alanmimms/WSPR-ease/hw/WSPR-ease.kicad_pcb

## KiCad design hw/WSPR-ease.kicad_pcb (2026-07-18)

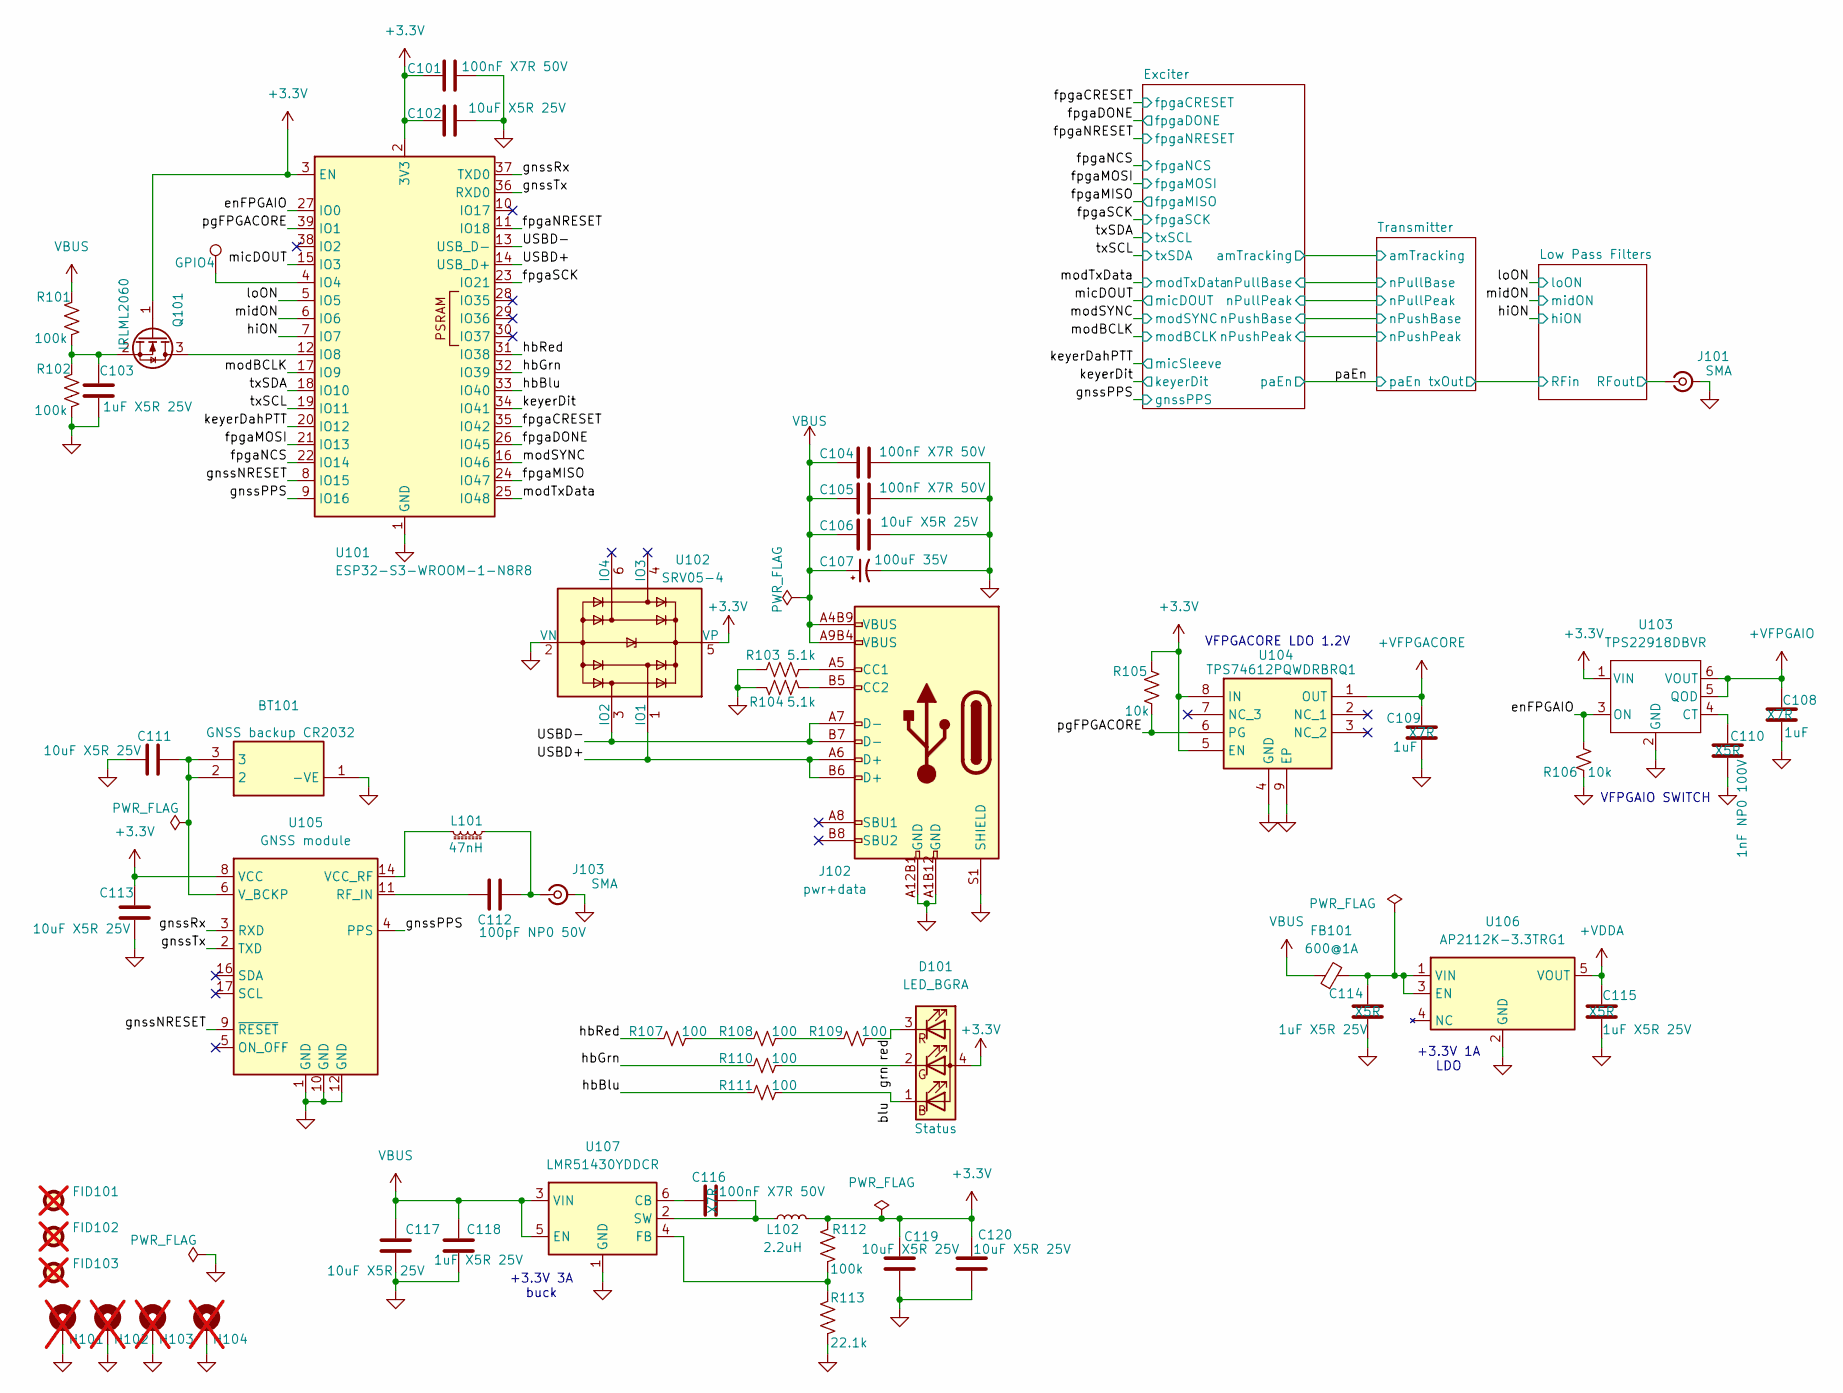
[picture p1: schematic WSPR-ease.kicad_sch]

Parts:
BT101: CR3032 holder; S8401-46; Mouser Part Number 855-S8401-46; LCSC C5904513
C101, C104, C105, C116: 100nF X7R 50V; C_0402_1005Metric; MPN KAM05FR71H104KH
C102, C106, C111, C113: 10uF X5R 25V; C_0603_1608Metric; MPN CM105X5R106M25AT; LCSC C479655
C103: 1uF X5R 25V; C_0402_1005Metric; MPN 04023D105MAT2A; LCSC C7393852
C107: 100uF 35V; C_Elec_6.3x7.7; MPN HHXJ350ARA101MF80G; LCSC C46528074
C108, C109: 1uF; C_0402_1005Metric; MPN GRM155Z71A105KE1D; LCSC_PN C301928
C110: 1nF NP0 100V; C_0603_1608Metric; MPN KGM15ACG2A102FT; LCSC_PN C301928
C112: 100pF NP0 50V; C_0402_1005Metric
C114, C115, C118: 1uF X5R 25V; C_0402_1005Metric; MPN 04023D105MAT2A; Mouser_PN 581-04023D105MAT2A
C117: 10uF X5R 25V; C_0603_1608Metric; MPN CM105X5R106M25AT; Mouser_PN 346-CM105X5R106M25AT
C119, C120: 10uF X5R 25V; C_0603_1608Metric; Manufacturer_Part_Number 81-GXT155R71E223KE1D; Mouser Part Number 963-MLAST168BB5106MT
D101: LED_BGRA; UHD111AFKAC3K23E1L3VG5ZB3Z3; MPN UHD111A-FKA-C3K23E1L3VG5ZB3Z3; Mouser_PN 941-UHD1AA3K3E3V53Z3
FB101: 600@1A; L_0603_1608Metric; MPN ILHB0603ER601VHC41; MouserPN 71-ILHB0603E601VHC41
FID101, FID102, FID103: Fiducial; Fiducial_1mm_Mask2mm; LCSC DNP; not fitted
H101, H102, H103, H104: MountingHole_Pad; MountingHole_3.2mm_M3_ISO7380_Pad; LCSC DNP; not fitted
J101, J103: SMA; SMA_Amphenol_901-143_Horizontal; MPN SMA-J-P-H-RA-TH1; LCSC C496551
J102: pwr+data; UJ20-C-H-G-SMT-P16-TR; MPN UJ20-C-H-G-SMT-P16-TR; Mouser_PN 179-UJ20CHGSMTP16TR
L101: 47nH; L_0603_1608Metric; MPN AIMC-0603-47NJ-T; LCSC C98076
L102: 2.2uH; L_1008_2520Metric; MPN APH252010T2R2M; LCSC C5349606
Q101: IRLML2060; SOT-23; MPN IRLML2060TRPBF; Mouser_PN 942-IRLML2060TRPBF
R101, R102: 100k; R_0402_1005Metric; MPN AC0402FR-0747RL; LCSC C2479306
R103, R104: 5.1k; R_0402_1005Metric; MPN MCS04020C5101FE000; Mouser_PN 594-MCS04020C5101FE0
R105: 10k; R_0402_1005Metric; MPN CRT0402-FZ-1003GLF; LCSC_PN C728576
R106: 10k; R_0402_1005Metric; MPN CRT0402-FZ-1003GLF; Mouser_PN 652-CRT0402FZ1003GLF
R107, R108, R109, R110, R111: 100; R_0402_1005Metric; MPN RT0402FRD0722K1L; Mouser_PN 603-RT0402FRD0722K1L
R112: 100k; R_0402_1005Metric; MPN AC0402FR-0747RL; Mouser_PN 603-AC0402FR-0747RL
R113: 22.1k; R_0402_1005Metric; MPN RT0402FRD0722K1L; Mouser_PN 603-RT0402FRD0722K1L
TP101: GPIO4; TestPoint_Pad_1.5x1.5mm
U101: ESP32-S3-WROOM-1-N8R8; ESP32-S3-WROOM-1; Mouser Part Number ESP32-S3-WROOM-1-N8R8; LCSC C2913201
U102: SRV05-4; SOT-23-6; MPN SRV05-4.TCT; LCSC C2836319
U103: TPS22918DBVR; DBV6_TEX; MPN TPS22918DBVR; LCSC_PN C131941
U104: TPS74612PQWDRBRQ1; SON65P300X300X100-9N-D; MPN TPS74612PQWDRBRQ1; LCSC_PN C2868254
U105: GNSS module; ublox_MAX; MPN TESEO-LIV3R; LCSC C5117921
U106: AP2112K-3.3TRG1; SOT95P285X140-5N; Mouser Part Number 621-AP2112K-3.3TRG1
U107: LMR51430YDDCR; SOT-23-6; MPN LMR51430YDDCR; Mouser_PN 595-LMR51430YDDCR

Connections:
+3.3V: C101.1, C102.1, C113.1, C119.1, C120.1, D101.4 (A), L102.2, Q101.1 (G), R105.2, R112.2, U101.2 (3V3), U101.3 (EN), U102.5 (VP), U103.1 (VIN), U104.5 (EN), U104.8 (IN), U105.8 (VCC); also elsewhere on the board
+VDDA: C115.1, U106.5 (VOUT); also elsewhere on the board
+VFPGACORE: C109.1, U104.1 (OUT); also elsewhere on the board
+VFPGAIO: C108.1, U103.5 (QOD), U103.6 (VOUT); also elsewhere on the board
/Low Pass Filters/RFout: J101.1 (In); also elsewhere on the board
/USBD+: J102.A6 (D+), J102.B6 (D+), U101.14 (USB_D+), U102.1 (IO1)
/USBD-: J102.A7 (D-), J102.B7 (D-), U101.13 (USB_D-), U102.3 (IO2)
/blu: D101.1 (BK), R111.2
/enFPGAIO: R106.2, U101.27 (IO0), U103.3 (ON)
/fpgaCRESET: U101.35 (IO42); also elsewhere on the board
/fpgaDONE: U101.26 (IO45); also elsewhere on the board
/fpgaMISO: U101.24 (IO47); also elsewhere on the board
/fpgaMOSI: U101.21 (IO13); also elsewhere on the board
/fpgaNCS: U101.22 (IO14); also elsewhere on the board
/fpgaNRESET: U101.11 (IO18); also elsewhere on the board
/fpgaSCK: U101.23 (IO21); also elsewhere on the board
/gnssNRESET: U101.8 (IO15), U105.9 (~RESET)
/gnssPPS: U101.9 (IO16), U105.4 (PPS); also elsewhere on the board
/gnssRx: U101.37 (TXD0), U105.3 (RXD)
/gnssTx: U101.36 (RXD0), U105.2 (TXD)
/grn: D101.2 (GK), R110.2
/hbBlu: R111.1, U101.33 (IO40)
/hbGrn: R110.1, U101.32 (IO39)
/hbRed: R107.1, U101.31 (IO38)
/hiON: U101.7 (IO7); also elsewhere on the board
/keyerDahPTT: U101.20 (IO12); also elsewhere on the board
/keyerDit: U101.34 (IO41); also elsewhere on the board
/loON: U101.5 (IO5); also elsewhere on the board
/micDOUT: U101.15 (IO3); also elsewhere on the board
/midON: U101.6 (IO6); also elsewhere on the board
/modBCLK: U101.17 (IO9); also elsewhere on the board
/modSYNC: U101.16 (IO46); also elsewhere on the board
/modTxData: U101.25 (IO48); also elsewhere on the board
/pgFPGACORE: R105.1, U101.39 (IO1), U104.6 (PG)
/red: D101.3 (RK), R109.2
/txSCL: U101.19 (IO11); also elsewhere on the board
/txSDA: U101.18 (IO10); also elsewhere on the board
GND: BT101.1 (-VE), C101.2, C102.2, C103.2, C104.2, C105.2, C106.2, C107.2, C108.2, C109.2, C110.2, C111.1, C113.2, C114.2, C115.2, C117.2, C118.2, C119.2, C120.2, H101.1, H102.1, H103.1, H104.1, J101.2 (Ext), J102.A1B12 (GND), J102.A12B1 (GND), J102.S1 (SHIELD), J103.2 (Ext), R102.2, R103.2, R104.2, R106.1, R113.1, U101.1 (GND), U101.40 (GND), U101.41 (GND), U102.2 (VN), U103.2 (GND), U104.4 (GND), U104.9 (EP), U105.1 (GND), U105.10 (GND), U105.12 (GND), U106.2 (GND), U107.1 (GND); also elsewhere on the board
unnamed: J102.A5 (CC1), R103.1
unnamed: J102.B5 (CC2), R104.1
unnamed: C112.2, J103.1 (In), L101.2
unnamed: Q101.3 (D), U101.12 (IO8)
unnamed: C103.1, Q101.2 (S), R101.2, R102.1
unnamed: R107.2, R108.1
unnamed: R108.2, R109.1
unnamed: TP101.1, U101.4 (IO4)
unnamed: C110.1, U103.4 (CT)
unnamed: C112.1, U105.11 (RF_IN)
unnamed: L101.1, U105.14 (VCC_RF)
unnamed: BT101.2, BT101.3, C111.2, U105.6 (V_BCKP)
unnamed: C114.1, FB101.2, U106.1 (VIN), U106.3 (EN)
unnamed: C116.1, U107.6 (CB)
unnamed: R112.1, R113.2, U107.4 (FB)
unnamed: C116.2, L102.1, U107.2 (SW)
VBUS: C104.1, C105.1, C106.1, C107.1, C117.1, C118.1, FB101.1, J102.A4B9 (VBUS), J102.A9B4 (VBUS), R101.1, U107.3 (VIN), U107.5 (EN); also elsewhere on the board

Notes on the sheet:
VFPGAIO SWITCH
+3.3V 1A LDO
+3.3V 3A buck
VFPGACORE LDO 1.2V

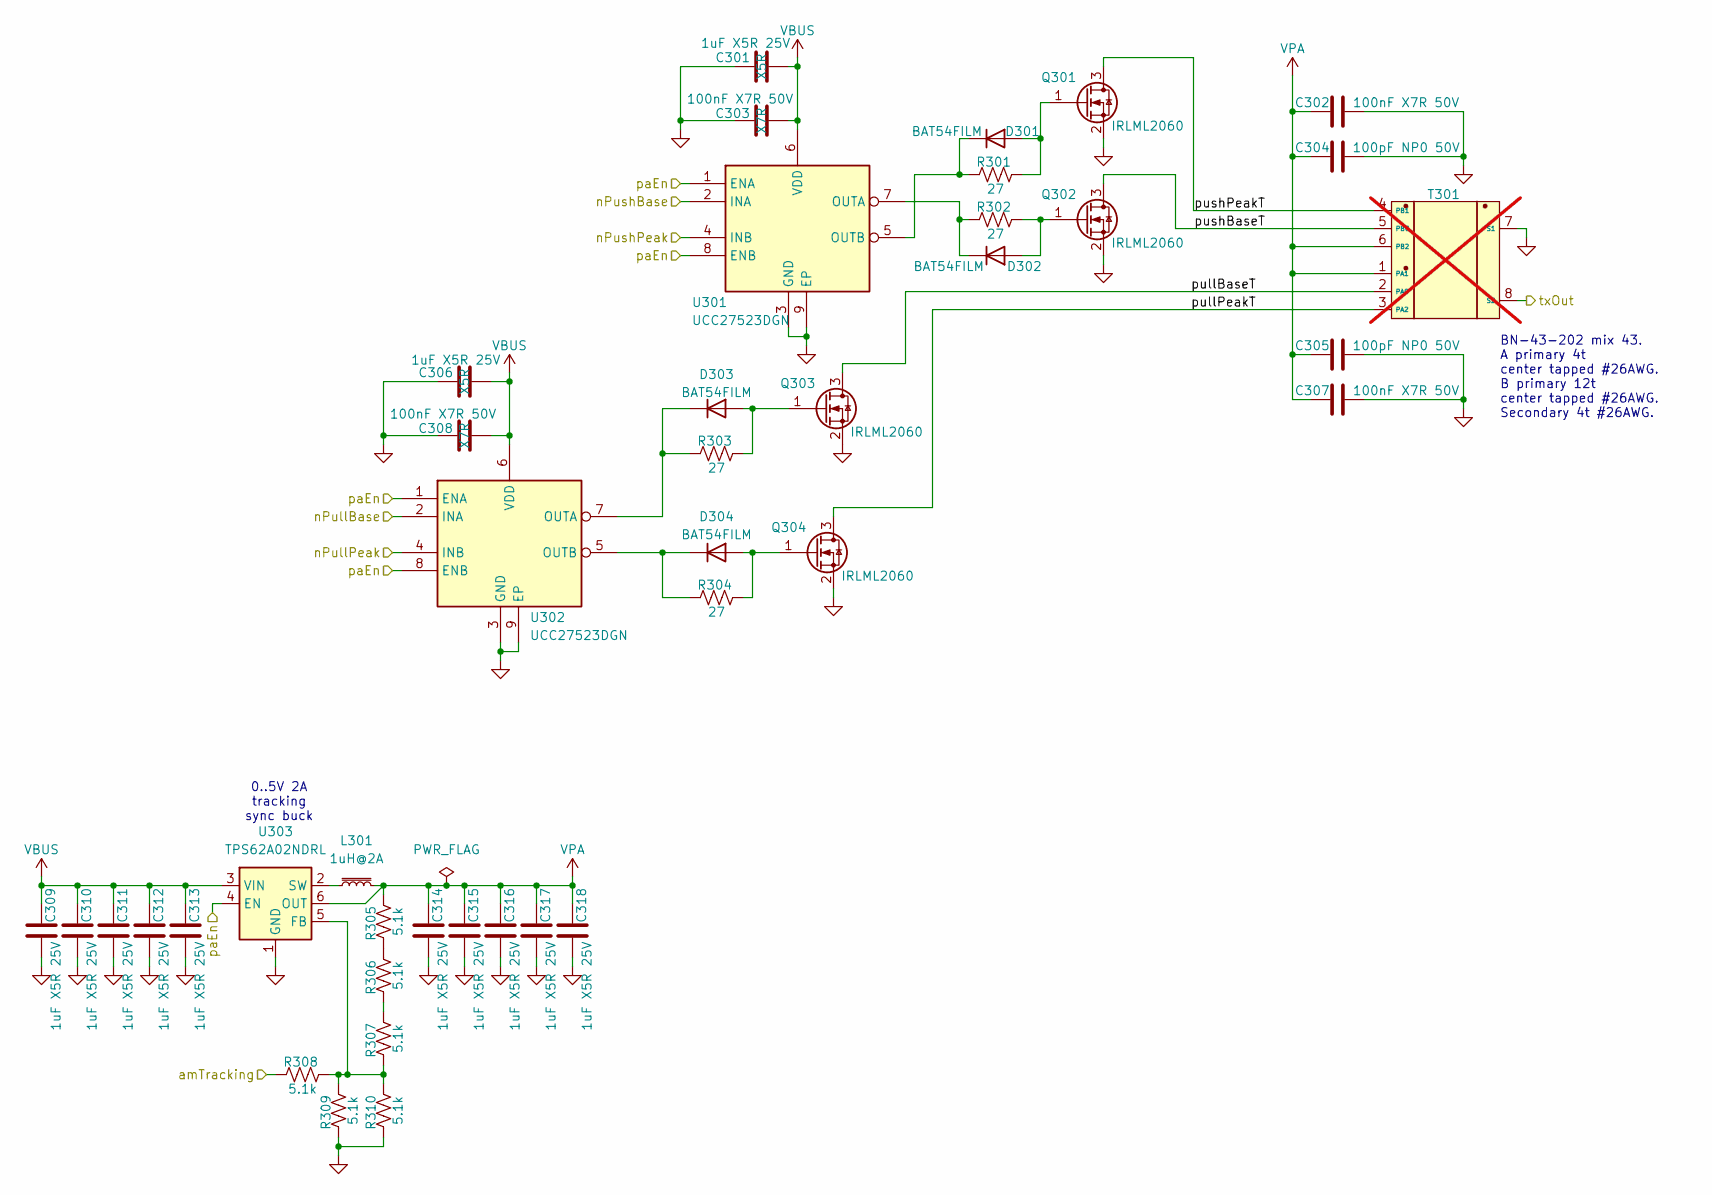
[picture p2: schematic tx.kicad_sch, Transmitter]

Parts:
C301, C306: 1uF X5R 25V; C_0402_1005Metric; MPN 04023D105MAT2A; Mouser_PN 581-04023D105MAT2A
C302, C303, C307, C308: 100nF X7R 50V; C_0402_1005Metric; MPN KAM05FR71H104KH
C304, C305: 100pF NP0 50V; C_0402_1005Metric
C309, C310, C311, C312, C313, C314, C315, C316, C317, C318: 1uF X5R 25V; C_0402_1005Metric; MPN 04023D105MAT2A; LCSC C7393852
D301, D302, D303, D304: BAT54FILM; D_SOD-123; MPN BAT54ZFILM; Mouser_PN 511-BAT54FILM
L301: 1uH@2A; PFL4514-inductor; MPN PFL4514-102MEC
Q301, Q302, Q303, Q304: IRLML2060; SOT-23; MPN IRLML2060TRPBF; Mouser_PN 942-IRLML2060TRPBF
R301, R302, R303, R304: 27; R_0402_1005Metric; MPN MCS04020C5101FE000; LCSC C2906874
R305, R306, R307, R308, R309, R310: 5.1k; R_0402_1005Metric
T301: BN-43-202_DualPri_CTSec; bn-43-202-horizontal; MPN 2843000202; LCSC C7174817; not fitted
U301, U302: UCC27523DGN; SOP65P490X110-9N; MPN UCC27525DGNR; Mouser_PN 595-UCC27525DGNR
U303: TPS62A02NDRL; SOT-563

Connections:
/Exciter/amTracking: R308.1; also elsewhere on the board
/Exciter/nPullBase: U302.2 (INA); also elsewhere on the board
/Exciter/nPullPeak: U302.4 (INB); also elsewhere on the board
/Exciter/nPushBase: U301.2 (INA); also elsewhere on the board
/Exciter/nPushPeak: U301.4 (INB); also elsewhere on the board
/Low Pass Filters/RFin: T301.8 (S2); also elsewhere on the board
/Transmitter/pullBaseT: Q303.3 (D), T301.2 (PAC)
/Transmitter/pullPeakT: Q304.3 (D), T301.3 (PA2)
/Transmitter/pushBaseT: Q302.3 (D), T301.5 (PBC)
/Transmitter/pushPeakT: Q301.3 (D), T301.4 (PB1)
/paEn: U301.1 (ENA), U301.8 (ENB), U302.1 (ENA), U302.8 (ENB), U303.4 (EN); also elsewhere on the board
GND: C301.1, C302.2, C303.1, C304.2, C305.2, C306.1, C307.2, C308.1, C309.2, C310.2, C311.2, C312.2, C313.2, C314.2, C315.2, C316.2, C317.2, C318.2, Q301.2 (S), Q302.2 (S), Q303.2 (S), Q304.2 (S), R309.1, R310.1, T301.7 (S1), U301.3 (GND), U301.9 (EP), U302.3 (GND), U302.9 (EP), U303.1 (GND); also elsewhere on the board
unnamed: D301.2 (A), Q301.1 (G), R301.2
unnamed: D301.1 (K), R301.1, U301.5 (OUTB)
unnamed: D302.2 (A), Q302.1 (G), R302.2
unnamed: D302.1 (K), R302.1, U301.7 (OUTA)
unnamed: D303.2 (A), Q303.1 (G), R303.2
unnamed: D303.1 (K), R303.1, U302.7 (OUTA)
unnamed: D304.2 (A), Q304.1 (G), R304.2
unnamed: D304.1 (K), R304.1, U302.5 (OUTB)
unnamed: R305.1, R306.2
unnamed: R306.1, R307.2
unnamed: R307.1, R308.2, R309.2, R310.2, U303.5 (FB)
unnamed: L301.1, U303.2 (SW)
VBUS: C301.2, C303.2, C306.2, C308.2, C309.1, C310.1, C311.1, C312.1, C313.1, U301.6 (VDD), U302.6 (VDD), U303.3 (VIN); also elsewhere on the board
VPA: C302.1, C304.1, C305.1, C307.1, C314.1, C315.1, C316.1, C317.1, C318.1, L301.2, R305.2, T301.1 (PA1), T301.6 (PB2), U303.6 (OUT)

Notes on the sheet:
BN-43-202 mix 43. A primary 4t center tapped #26AWG. B primary 12t center tapped #26AWG. Secondary 4t #26AWG.
0..5V 2A tracking sync buck

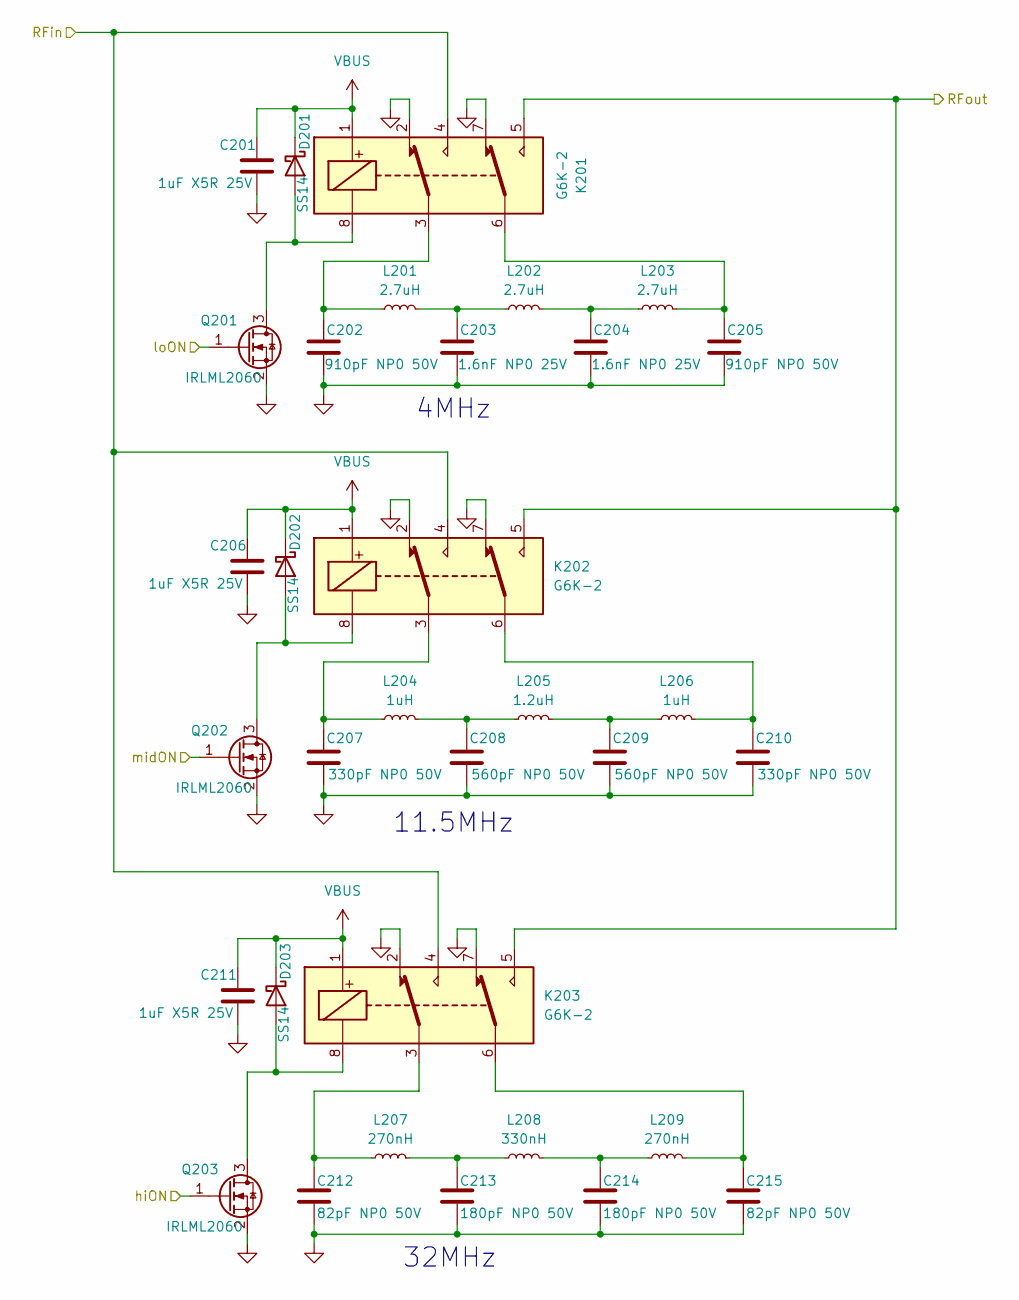
[picture p3: schematic LPFs.kicad_sch, Transmitter]

Parts:
C201, C206, C211: 1uF X5R 25V; C_0402_1005Metric; MPN 04023D105MAT2A; LCSC C7393852
C202, C205: 910pF NP0 50V; C_0402_1005Metric
C203, C204: 1.6nF NP0 25V; C_0402_1005Metric
C207, C210: 330pF NP0 50V; C_0402_1005Metric
C208, C209: 560pF NP0 50V; C_0402_1005Metric
C212, C215: 82pF NP0 50V; C_0402_1005Metric
C213, C214: 180pF NP0 50V; C_0402_1005Metric
D201, D202, D203: SS14; D_SMA; MPN SS14; LCSC C45406502
K201, K202, K203: G6K-2; Relay_DPDT_Omron_G6K-2G; MPN G6K-2G-DC5; Mouser_PN 653-G6K-2G-DC5
L201, L202, L203: 2.7uH; L_1008_2520Metric; MPN 1008LS-272XJRC; Mouser_PN 994-1008LS-272XJRC
L204, L206: 1uH; L_1008_2520Metric; MPN 1008CS-102XJRC; Mouser_PN 994-1008CS-102XJRC
L205: 1.2uH; L_1008_2520Metric; MPN 1008CS-122XJRC; Mouser_PN 994-1008CS-122XJRC
L207, L209: 270nH; L_0805_2012Metric; MPN 1008CS-271XGRC; LCSC C48946576
L208: 330nH; L_0805_2012Metric; MPN 1008CS-331XGRC; LCSC C48946577
Q201, Q202, Q203: IRLML2060; SOT-23; MPN IRLML2060TRPBF; Mouser_PN 942-IRLML2060TRPBF

Connections:
/Low Pass Filters/RFin: K201.4, K202.4, K203.4; also elsewhere on the board
/Low Pass Filters/RFout: K201.5, K202.5, K203.5; also elsewhere on the board
/hiON: Q203.1 (G); also elsewhere on the board
/loON: Q201.1 (G); also elsewhere on the board
/midON: Q202.1 (G); also elsewhere on the board
GND: C201.2, C202.2, C203.2, C204.2, C205.2, C206.2, C207.2, C208.2, C209.2, C210.2, C211.2, C212.2, C213.2, C214.2, C215.2, K201.2, K201.7, K202.2, K202.7, K203.2, K203.7, Q201.2 (S), Q202.2 (S), Q203.2 (S); also elsewhere on the board
unnamed: C202.1, K201.3, L201.1
unnamed: C203.1, L201.2, L202.1
unnamed: C204.1, L202.2, L203.1
unnamed: C205.1, K201.6, L203.2
unnamed: C207.1, K202.3, L204.1
unnamed: C208.1, L204.2, L205.1
unnamed: C209.1, L205.2, L206.1
unnamed: C210.1, K202.6, L206.2
unnamed: C212.1, K203.3, L207.1
unnamed: C213.1, L207.2, L208.1
unnamed: C214.1, L208.2, L209.1
unnamed: C215.1, K203.6, L209.2
unnamed: D201.2 (A), K201.8, Q201.3 (D)
unnamed: D202.2 (A), K202.8, Q202.3 (D)
unnamed: D203.2 (A), K203.8, Q203.3 (D)
VBUS: C201.1, C206.1, C211.1, D201.1 (K), D202.1 (K), D203.1 (K), K201.1, K202.1, K203.1; also elsewhere on the board

Notes on the sheet:
4MHz
32MHz
11.5MHz

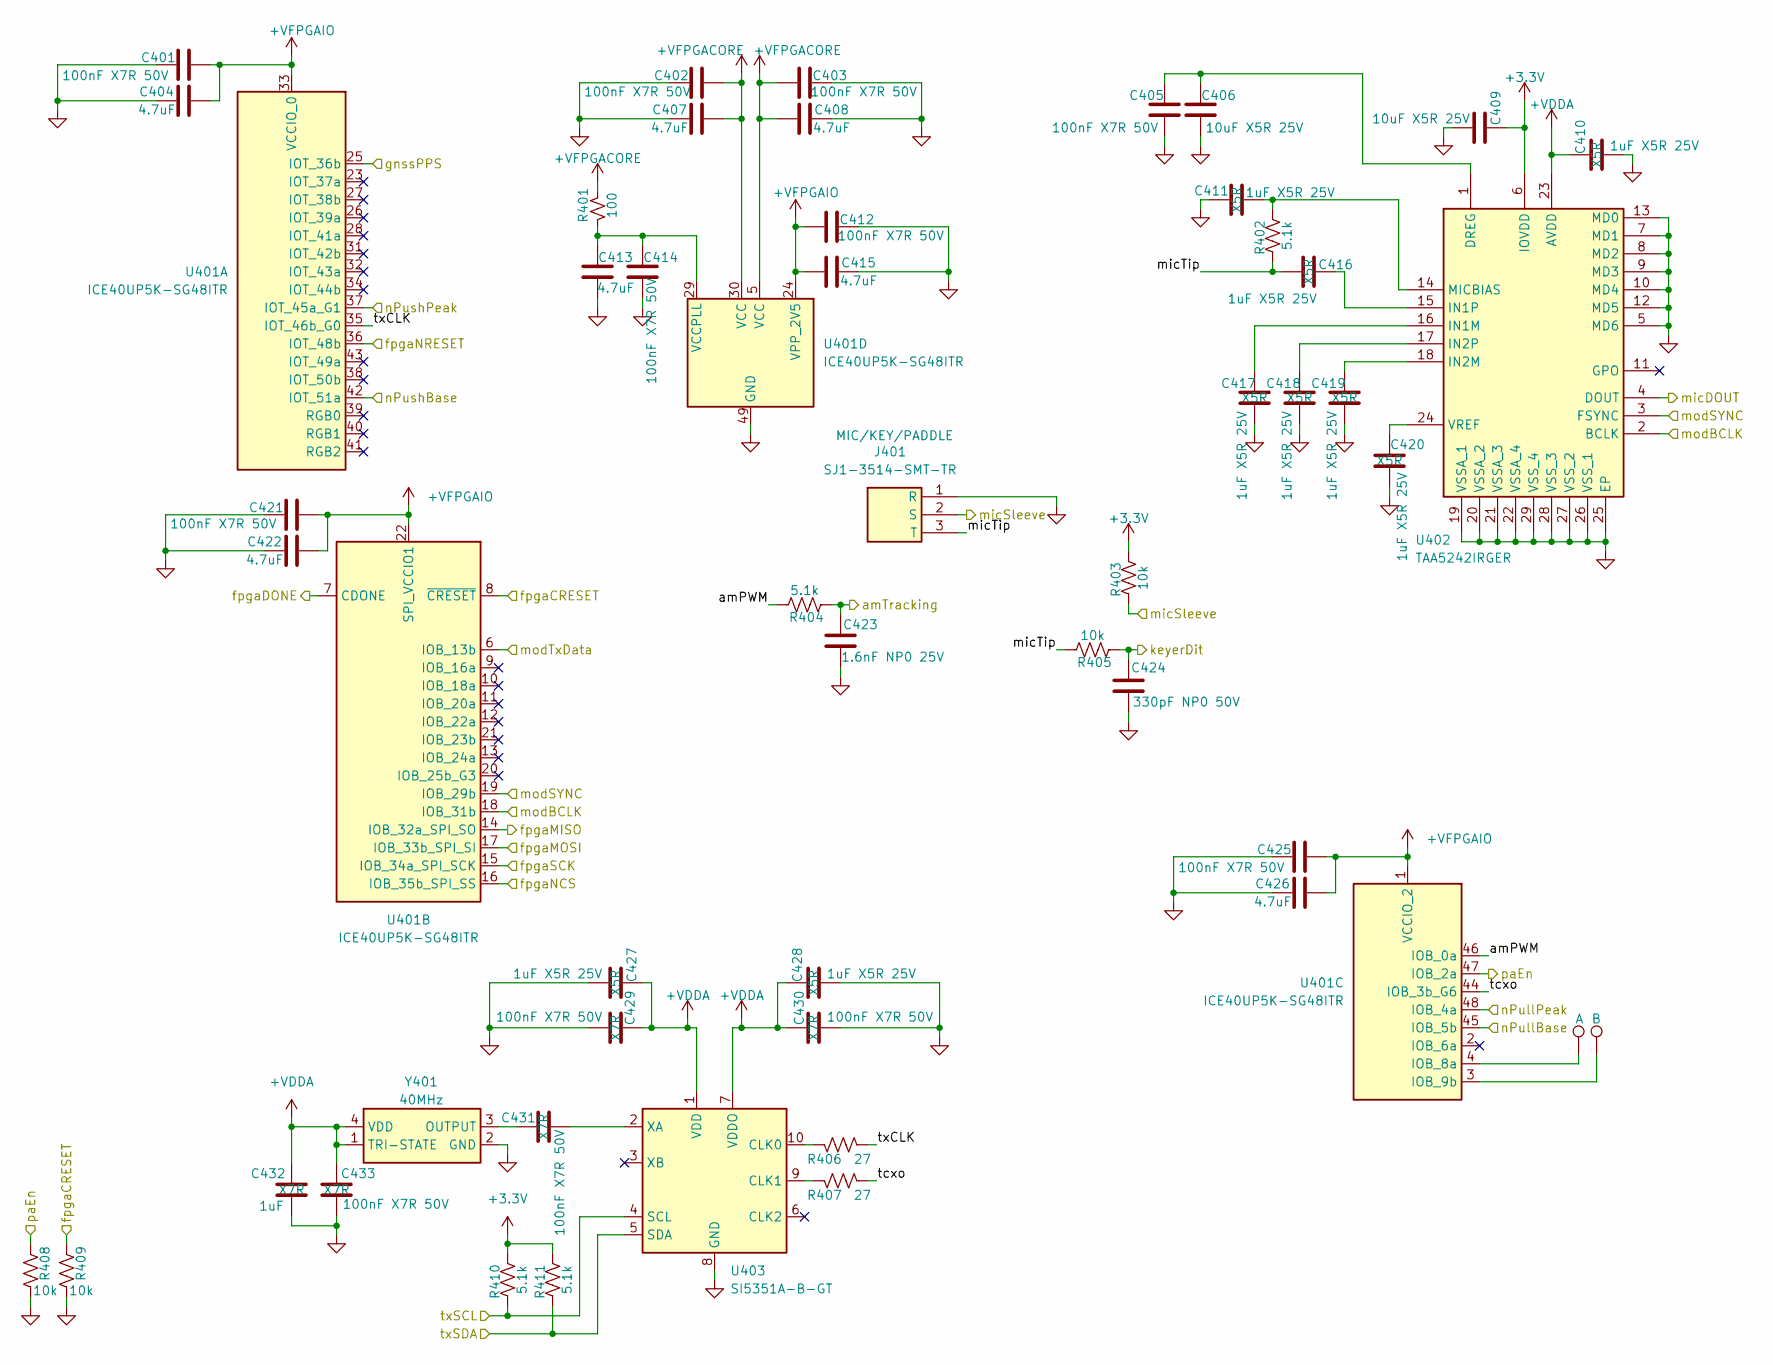
[picture p4: schematic exciter.kicad_sch]

Parts:
C401, C402, C403, C405, C412, C414, C421, C425: 100nF X7R 50V; C_0402_1005Metric; MPN KGM15BR71H104KT; LCSC C24452
C404, C407, C408, C413, C415, C422, C426: 4.7uF; C_0402_1005Metric; MPN CM05X5R475M10AH; LCSC_PN C18535241
C406: 10uF X5R 25V; C_0603_1608Metric; Manufacturer_Part_Number 81-GXT155R71E223KE1D; Mouser Part Number 963-MLAST168BB5106MT
C409: 10uF X5R 25V; C_0603_1608Metric; MPN CM105X5R106M25AT; LCSC C96446
C410, C411, C416, C417, C418, C419, C420, C427, C428: 1uF X5R 25V; C_0402_1005Metric; MPN 04023D105MAT2A; Mouser_PN 581-04023D105MAT2A
C423: 1.6nF NP0 25V; C_0402_1005Metric
C424: 330pF NP0 50V; C_0402_1005Metric
C429, C430, C431: 100nF X7R 50V; C_0402_1005Metric; MPN KAM05FR71H104KH
C432: 1uF; C_0402_1005Metric; MPN GRM155Z71A105KE1D; LCSC_PN C301928
C433: 100nF X7R 50V; C_0402_1005Metric; MPN KGM15BR71H104KT; LCSC_PN C24452
J401: SJ1-3514-SMT-TR; 35RASMT2BHWNTRX; Mouser Part Number 502-35RASMT2BHWNTRX
R401: 100; R_0402_1005Metric; MPN RT0402FRD0722K1L; Mouser_PN 603-RT0402FRD0722K1L
R402, R404: 5.1k; R_0402_1005Metric; MPN MCT06030C1009FP500; LCSC C2907091
R403, R405: 10k; R_0402_1005Metric; MPN MCT06030C1009FP500; LCSC C2907091
R406, R407: 27; R_0402_1005Metric; MPN MCS04020C5101FE000; Mouser_PN 594-MCS04020C5101FE0
R408, R409: 10k; R_0402_1005Metric; MPN CRT0402-FZ-1003GLF; LCSC C60490
R410, R411: 5.1k; R_0402_1005Metric; MPN MCS04020C5101FE000; LCSC C2906874
TP401: A; TestPoint_Pad_1.5x1.5mm
TP402: B; TestPoint_Pad_1.5x1.5mm
U401: ICE40UP5K-SG48ITR; QFN50P700X700X100-49N-D; MPN ICE40UP5K-SG48I; LCSC C2678152
U402: TAA5242IRGER; Manufacturer_Part_Number TAA5242IRGER
U403: SI5351A-B-GT; MSOP-10_3x3mm_P0.5mm; MPN SI5351C-B-GM1; Mouser_PN 634-SI5351C-B-GM1
Y401: 40MHz; ECSTXO201633400TR; MPN ECS-TXO-2016-33-400-TR; LCSC_PN C2451471

Connections:
+3.3V: C409.2, R403.2, R410.2, R411.2, U402.6 (IOVDD); also elsewhere on the board
+VDDA: C410.1, C427.1, C428.1, C429.2, C430.2, C432.1, C433.1, U402.23 (AVDD), U403.1 (VDD), U403.7 (VDDO), Y401.1 (TRI-STATE), Y401.4 (VDD); also elsewhere on the board
+VFPGACORE: C402.2, C403.2, C407.1, C408.1, R401.2, U401.5 (VCC), U401.30 (VCC); also elsewhere on the board
+VFPGAIO: C401.2, C404.1, C412.2, C415.1, C421.2, C422.1, C425.2, C426.1, U401.1 (VCCIO_2), U401.22 (SPI_VCCIO1), U401.24 (VPP_2V5), U401.33 (VCCIO_0); also elsewhere on the board
/Exciter/amPWM: R404.2, U401.46 (IOB_0a)
/Exciter/amTracking: C423.1, R404.1; also elsewhere on the board
/Exciter/micTip: C416.2, J401.3 (T), R402.1, R405.2
/Exciter/nPullBase: U401.45 (IOB_5b); also elsewhere on the board
/Exciter/nPullPeak: U401.48 (IOB_4a); also elsewhere on the board
/Exciter/nPushBase: U401.42 (IOT_51a); also elsewhere on the board
/Exciter/nPushPeak: U401.37 (IOT_45a_G1); also elsewhere on the board
/Exciter/tcxo: R407.1, U401.44 (IOB_3b_G6)
/Exciter/txCLK: R406.1, U401.35 (IOT_46b_G0)
/fpgaCRESET: R409.1, U401.8 (~CRESET); also elsewhere on the board
/fpgaDONE: U401.7 (CDONE); also elsewhere on the board
/fpgaMISO: U401.14 (IOB_32a_SPI_SO); also elsewhere on the board
/fpgaMOSI: U401.17 (IOB_33b_SPI_SI); also elsewhere on the board
/fpgaNCS: U401.16 (IOB_35b_SPI_SS); also elsewhere on the board
/fpgaNRESET: U401.36 (IOT_48b); also elsewhere on the board
/fpgaSCK: U401.15 (IOB_34a_SPI_SCK); also elsewhere on the board
/gnssPPS: U401.25 (IOT_36b); also elsewhere on the board
/keyerDahPTT: J401.2 (S), R403.1; also elsewhere on the board
/keyerDit: C424.1, R405.1; also elsewhere on the board
/micDOUT: U402.4 (DOUT); also elsewhere on the board
/modBCLK: U401.18 (IOB_31b), U402.2 (BCLK); also elsewhere on the board
/modSYNC: U401.19 (IOB_29b), U402.3 (FSYNC); also elsewhere on the board
/modTxData: U401.6 (IOB_13b); also elsewhere on the board
/paEn: R408.1, U401.47 (IOB_2a); also elsewhere on the board
/txSCL: R411.1, U403.5 (SDA); also elsewhere on the board
/txSDA: R410.1, U403.4 (SCL); also elsewhere on the board
GND: C401.1, C402.1, C403.1, C404.2, C405.1, C406.1, C407.2, C408.2, C409.1, C410.2, C411.2, C412.1, C413.2, C414.1, C415.2, C417.2, C418.2, C419.2, C420.2, C421.1, C422.2, C423.2, C424.2, C425.1, C426.2, C427.2, C428.2, C429.1, C430.1, C432.2, C433.2, J401.1 (R), R408.2, R409.2, U401.49 (GND), U402.5 (MD6), U402.7 (MD1), U402.8 (MD2), U402.9 (MD3), U402.10 (MD4), U402.12 (MD5), U402.13 (MD0), U402.19 (VSSA_1), U402.20 (VSSA_2), U402.21 (VSSA_3), U402.22 (VSSA_4), U402.25 (EP), U402.26 (VSS_1), U402.27 (VSS_2), U402.28 (VSS_3), U402.29 (VSS_4), U403.8 (GND), Y401.2 (GND); also elsewhere on the board
unnamed: TP401.1, U401.4 (IOB_8a)
unnamed: TP402.1, U401.3 (IOB_9b)
unnamed: C413.1, C414.2, R401.1, U401.29 (VCCPLL)
unnamed: C405.2, C406.2, U402.1 (DREG)
unnamed: C417.1, U402.16 (IN1M)
unnamed: C416.1, U402.15 (IN1P)
unnamed: C419.1, U402.18 (IN2M)
unnamed: C418.1, U402.17 (IN2P)
unnamed: C411.1, R402.2, U402.14 (MICBIAS)
unnamed: C420.1, U402.24 (VREF)
unnamed: R406.2, U403.10 (CLK0)
unnamed: R407.2, U403.9 (CLK1)
unnamed: C431.2, U403.2 (XA)
unnamed: C431.1, Y401.3 (OUTPUT)

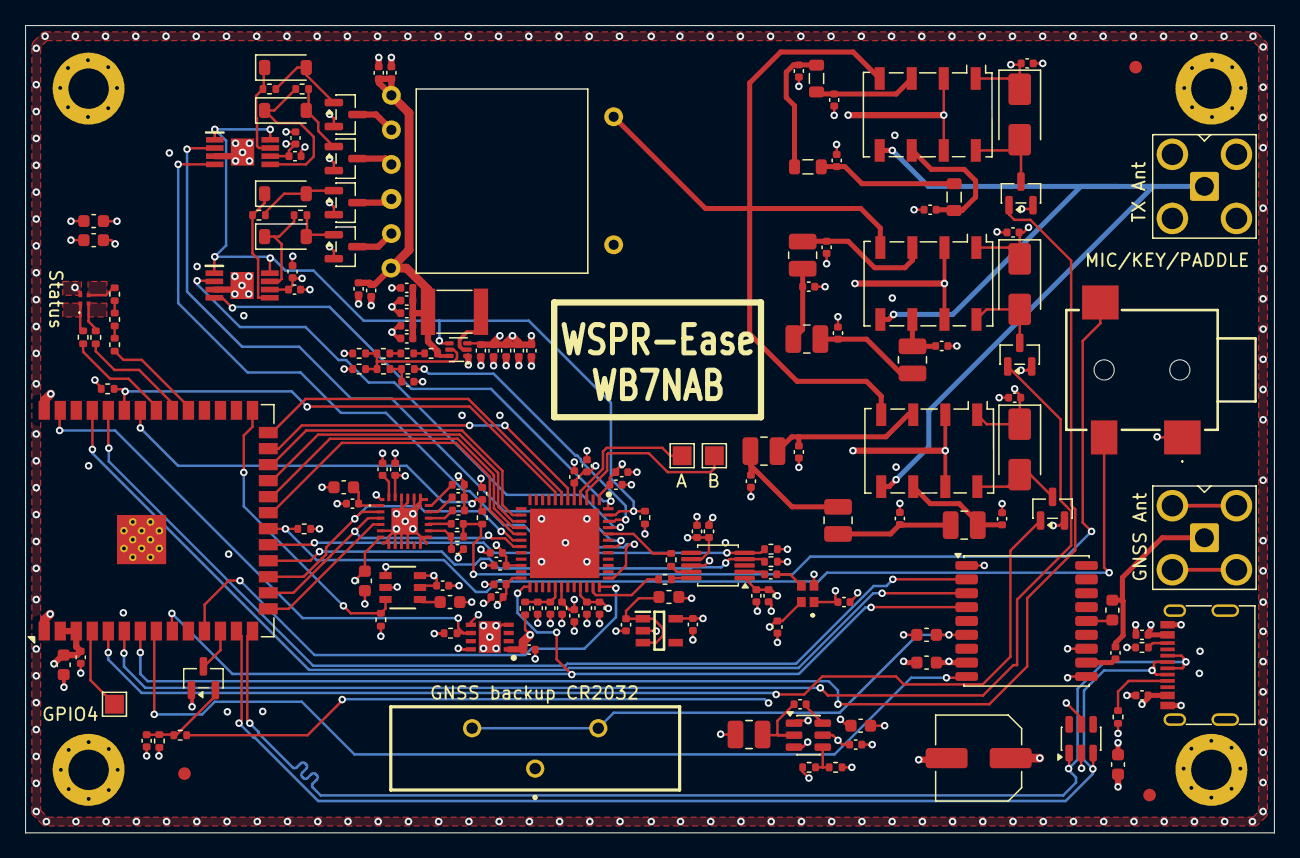
[picture p5: board WSPR-ease.kicad_pcb from above]

Board: 4 copper layers, 99.0 x 64.0 mm, 182 parts (0 on the bottom side), 112 nets.
