alanmimms/WSPR-ease/FPGA/pins.pcf

# Clock Inputs
set_io txCLK 35
set_io tcxo 44
set_io gnssPPS 25

# SPI Interface
set_io fpgaMISO 14
set_io fpgaSCK 15
set_io fpgaNCS 16
set_io fpgaMOSI 17

# I2S Audio Bus Inputs (from ESP32, BCLK/SYNC shared with mic ADC)
set_io modTxData 6
set_io modBCLK 18
set_io modSYNC 19

# RF Exciter & Control Outputs
set_io rfPushPeak 37
set_io rfPushBase 42
set_io rfPullPeak 48
set_io rfPullBase 45
set_io paEn 47
set_io amPWM 46

# Debug Pads
set_io padA 4
set_io padB 3

# Reset without reconfiguration
set_io fpgaNRESET 36
