alanmimms/WSPR-ease/FPGA/sim/cells_sim.v

/*
 *  yosys -- Yosys Open SYnthesis Suite
 *
 *  Copyright (C) 2012  Claire Xenia Wolf <claire@yosyshq.com>
 *
 *  Permission to use, copy, modify, and/or distribute this software for any
 *  purpose with or without fee is hereby granted, provided that the above
 *  copyright notice and this permission notice appear in all copies.
 *
 *  THE SOFTWARE IS PROVIDED "AS IS" AND THE AUTHOR DISCLAIMS ALL WARRANTIES
 *  WITH REGARD TO THIS SOFTWARE INCLUDING ALL IMPLIED WARRANTIES OF
 *  MERCHANTABILITY AND FITNESS. IN NO EVENT SHALL THE AUTHOR BE LIABLE FOR
 *  ANY SPECIAL, DIRECT, INDIRECT, OR CONSEQUENTIAL DAMAGES OR ANY DAMAGES
 *  WHATSOEVER RESULTING FROM LOSS OF USE, DATA OR PROFITS, WHETHER IN AN
 *  ACTION OF CONTRACT, NEGLIGENCE OR OTHER TORTIOUS ACTION, ARISING OUT OF
 *  OR IN CONNECTION WITH THE USE OR PERFORMANCE OF THIS SOFTWARE.
 */
`timescale 1ps / 1ps
`define SB_DFF_INIT initial Q = 0;
// `define SB_DFF_INIT

`ifndef NO_ICE40_DEFAULT_ASSIGNMENTS
`define ICE40_DEFAULT_ASSIGNMENT_V(v) = v
`define ICE40_DEFAULT_ASSIGNMENT_0 = 1'b0
`define ICE40_DEFAULT_ASSIGNMENT_1 = 1'b1
`else
`define ICE40_DEFAULT_ASSIGNMENT_V(v)
`define ICE40_DEFAULT_ASSIGNMENT_0
`define ICE40_DEFAULT_ASSIGNMENT_1
`endif

// SiliconBlue IO Cells

module SB_IO (
	inout  PACKAGE_PIN,
	input  LATCH_INPUT_VALUE,
	input  CLOCK_ENABLE `ICE40_DEFAULT_ASSIGNMENT_1,
	input  INPUT_CLK,
	input  OUTPUT_CLK,
	input  OUTPUT_ENABLE,
	input  D_OUT_0,
	input  D_OUT_1,
	output D_IN_0,
	output D_IN_1
);
	parameter [5:0] PIN_TYPE = 6'b000000;
	parameter [0:0] PULLUP = 1'b0;
	parameter [0:0] NEG_TRIGGER = 1'b0;
	parameter IO_STANDARD = "SB_LVCMOS";

`ifndef BLACKBOX
	reg dout, din_0, din_1;
	reg din_q_0, din_q_1;
	reg dout_q_0, dout_q_1;
	reg outena_q;

	// IO tile generates a constant 1'b1 internally if global_cen is not connected
`ifdef VERILATOR
        wire clken_pulled = CLOCK_ENABLE;
`else
	wire clken_pulled = CLOCK_ENABLE || CLOCK_ENABLE === 1'bz;
`endif
	reg  clken_pulled_ri;
	reg  clken_pulled_ro;

	generate if (!NEG_TRIGGER) begin
		always @(posedge INPUT_CLK)                       clken_pulled_ri <= clken_pulled;
		always @(posedge INPUT_CLK)  if (clken_pulled)    din_q_0         <= PACKAGE_PIN;
		always @(negedge INPUT_CLK)  if (clken_pulled_ri) din_q_1         <= PACKAGE_PIN;
		always @(posedge OUTPUT_CLK)                      clken_pulled_ro <= clken_pulled;
		always @(posedge OUTPUT_CLK) if (clken_pulled)    dout_q_0        <= D_OUT_0;
		always @(negedge OUTPUT_CLK) if (clken_pulled_ro) dout_q_1        <= D_OUT_1;
		always @(posedge OUTPUT_CLK) if (clken_pulled)    outena_q        <= OUTPUT_ENABLE;
	end else begin
		always @(negedge INPUT_CLK)                       clken_pulled_ri <= clken_pulled;
		always @(negedge INPUT_CLK)  if (clken_pulled)    din_q_0         <= PACKAGE_PIN;
		always @(posedge INPUT_CLK)  if (clken_pulled_ri) din_q_1         <= PACKAGE_PIN;
		always @(negedge OUTPUT_CLK)                      clken_pulled_ro <= clken_pulled;
		always @(negedge OUTPUT_CLK) if (clken_pulled)    dout_q_0        <= D_OUT_0;
		always @(posedge OUTPUT_CLK) if (clken_pulled_ro) dout_q_1        <= D_OUT_1;
		always @(negedge OUTPUT_CLK) if (clken_pulled)    outena_q        <= OUTPUT_ENABLE;
	end endgenerate

	always @* begin
		if (!PIN_TYPE[1] || !LATCH_INPUT_VALUE)
			din_0 = PIN_TYPE[0] ? PACKAGE_PIN : din_q_0;
		din_1 = din_q_1;
	end

	// work around simulation glitches on dout in DDR mode
	reg outclk_delayed_1;
	reg outclk_delayed_2;
	always @* outclk_delayed_1 <= OUTPUT_CLK;
	always @* outclk_delayed_2 <= outclk_delayed_1;

	always @* begin
		if (PIN_TYPE[3])
			dout = PIN_TYPE[2] ? !dout_q_0 : D_OUT_0;
		else
			dout = (outclk_delayed_2 ^ NEG_TRIGGER) || PIN_TYPE[2] ? dout_q_0 : dout_q_1;
	end

	assign D_IN_0 = din_0, D_IN_1 = din_1;

	generate
		if (PIN_TYPE[5:4] == 2'b01) assign PACKAGE_PIN = dout;
		if (PIN_TYPE[5:4] == 2'b10) assign PACKAGE_PIN = OUTPUT_ENABLE ? dout : 1'bz;
		if (PIN_TYPE[5:4] == 2'b11) assign PACKAGE_PIN = outena_q ? dout : 1'bz;
	endgenerate
`endif
`ifdef TIMING
specify
	(INPUT_CLK => D_IN_0) = (0:0:0, 0:0:0);
	(INPUT_CLK => D_IN_1) = (0:0:0, 0:0:0);
	(PACKAGE_PIN => D_IN_0) = (0:0:0, 0:0:0);
	(OUTPUT_CLK => PACKAGE_PIN) = (0:0:0, 0:0:0);
	(D_OUT_0 => PACKAGE_PIN) = (0:0:0, 0:0:0);
	(OUTPUT_ENABLE => PACKAGE_PIN) = (0:0:0, 0:0:0);

	$setuphold(posedge OUTPUT_CLK, posedge D_OUT_0, 0:0:0, 0:0:0);
	$setuphold(posedge OUTPUT_CLK, negedge D_OUT_0, 0:0:0, 0:0:0);
	$setuphold(negedge OUTPUT_CLK, posedge D_OUT_1, 0:0:0, 0:0:0);
	$setuphold(negedge OUTPUT_CLK, negedge D_OUT_1, 0:0:0, 0:0:0);
	$setuphold(negedge OUTPUT_CLK, posedge D_OUT_0, 0:0:0, 0:0:0);
	$setuphold(negedge OUTPUT_CLK, negedge D_OUT_0, 0:0:0, 0:0:0);
	$setuphold(posedge OUTPUT_CLK, posedge D_OUT_1, 0:0:0, 0:0:0);
	$setuphold(posedge OUTPUT_CLK, negedge D_OUT_1, 0:0:0, 0:0:0);
	$setuphold(posedge INPUT_CLK, posedge CLOCK_ENABLE, 0:0:0, 0:0:0);
	$setuphold(posedge INPUT_CLK, negedge CLOCK_ENABLE, 0:0:0, 0:0:0);
	$setuphold(posedge OUTPUT_CLK, posedge CLOCK_ENABLE, 0:0:0, 0:0:0);
	$setuphold(posedge OUTPUT_CLK, negedge CLOCK_ENABLE, 0:0:0, 0:0:0);
	$setuphold(posedge INPUT_CLK, posedge PACKAGE_PIN, 0:0:0, 0:0:0);
	$setuphold(posedge INPUT_CLK, negedge PACKAGE_PIN, 0:0:0, 0:0:0);
	$setuphold(negedge INPUT_CLK, posedge PACKAGE_PIN, 0:0:0, 0:0:0);
	$setuphold(negedge INPUT_CLK, negedge PACKAGE_PIN, 0:0:0, 0:0:0);
	$setuphold(posedge OUTPUT_CLK, posedge OUTPUT_ENABLE, 0:0:0, 0:0:0);
	$setuphold(posedge OUTPUT_CLK, negedge OUTPUT_ENABLE, 0:0:0, 0:0:0);
	$setuphold(negedge OUTPUT_CLK, posedge OUTPUT_ENABLE, 0:0:0, 0:0:0);
	$setuphold(negedge OUTPUT_CLK, negedge OUTPUT_ENABLE, 0:0:0, 0:0:0);
endspecify
`endif
endmodule

module SB_GB_IO (
	inout  PACKAGE_PIN,
	output GLOBAL_BUFFER_OUTPUT,
	input  LATCH_INPUT_VALUE,
	input  CLOCK_ENABLE `ICE40_DEFAULT_ASSIGNMENT_1,
	input  INPUT_CLK,
	input  OUTPUT_CLK,
	input  OUTPUT_ENABLE,
	input  D_OUT_0,
	input  D_OUT_1,
	output D_IN_0,
	output D_IN_1
);
	parameter [5:0] PIN_TYPE = 6'b000000;
	parameter [0:0] PULLUP = 1'b0;
	parameter [0:0] NEG_TRIGGER = 1'b0;
	parameter IO_STANDARD = "SB_LVCMOS";

	assign GLOBAL_BUFFER_OUTPUT = PACKAGE_PIN;

	SB_IO #(
		.PIN_TYPE(PIN_TYPE),
		.PULLUP(PULLUP),
		.NEG_TRIGGER(NEG_TRIGGER),
		.IO_STANDARD(IO_STANDARD)
	) IO (
		.PACKAGE_PIN(PACKAGE_PIN),
		.LATCH_INPUT_VALUE(LATCH_INPUT_VALUE),
		.CLOCK_ENABLE(CLOCK_ENABLE),
		.INPUT_CLK(INPUT_CLK),
		.OUTPUT_CLK(OUTPUT_CLK),
		.OUTPUT_ENABLE(OUTPUT_ENABLE),
		.D_OUT_0(D_OUT_0),
		.D_OUT_1(D_OUT_1),
		.D_IN_0(D_IN_0),
		.D_IN_1(D_IN_1)
	);
endmodule

module SB_GB (
	input  USER_SIGNAL_TO_GLOBAL_BUFFER,
	output GLOBAL_BUFFER_OUTPUT
);
	assign GLOBAL_BUFFER_OUTPUT = USER_SIGNAL_TO_GLOBAL_BUFFER;
`ifdef TIMING
specify
	(USER_SIGNAL_TO_GLOBAL_BUFFER => GLOBAL_BUFFER_OUTPUT) = (0:0:0, 0:0:0);
endspecify
`endif
endmodule

// SiliconBlue Logic Cells

(* abc9_lut=1, lib_whitebox *)
module SB_LUT4 (
	output O,
	input I0 `ICE40_DEFAULT_ASSIGNMENT_0,
	input I1 `ICE40_DEFAULT_ASSIGNMENT_0,
	input I2 `ICE40_DEFAULT_ASSIGNMENT_0,
	input I3 `ICE40_DEFAULT_ASSIGNMENT_0
);
	parameter [15:0] LUT_INIT = 0;
	wire [7:0] s3 = I3 ? LUT_INIT[15:8] : LUT_INIT[7:0];
	wire [3:0] s2 = I2 ?       s3[ 7:4] :       s3[3:0];
	wire [1:0] s1 = I1 ?       s2[ 3:2] :       s2[1:0];
	assign O = I0 ? s1[1] : s1[0];
`ifdef ICE40_HX
	specify
		// https://github.com/YosysHQ/icestorm/blob/be0bca0230d6fe1102e0a360b953fbb0d273a39f/icefuzz/timings_hx1k.txt#L80
		(I0 => O) = (449, 386);
		// https://github.com/YosysHQ/icestorm/blob/be0bca0230d6fe1102e0a360b953fbb0d273a39f/icefuzz/timings_hx1k.txt#L83
		(I1 => O) = (400, 379);
		// https://github.com/YosysHQ/icestorm/blob/be0bca0230d6fe1102e0a360b953fbb0d273a39f/icefuzz/timings_hx1k.txt#L86
		(I2 => O) = (379, 351);
		// https://github.com/YosysHQ/icestorm/blob/be0bca0230d6fe1102e0a360b953fbb0d273a39f/icefuzz/timings_hx1k.txt#L88
		(I3 => O) = (316, 288);
	endspecify
`endif
`ifdef ICE40_LP
	specify
		// https://github.com/YosysHQ/icestorm/blob/be0bca0230d6fe1102e0a360b953fbb0d273a39f/icefuzz/timings_lp1k.txt#L80
		(I0 => O) = (662, 569);
		// https://github.com/YosysHQ/icestorm/blob/be0bca0230d6fe1102e0a360b953fbb0d273a39f/icefuzz/timings_lp1k.txt#L83
		(I1 => O) = (589, 558);
		// https://github.com/YosysHQ/icestorm/blob/be0bca0230d6fe1102e0a360b953fbb0d273a39f/icefuzz/timings_lp1k.txt#L86
		(I2 => O) = (558, 517);
		// https://github.com/YosysHQ/icestorm/blob/be0bca0230d6fe1102e0a360b953fbb0d273a39f/icefuzz/timings_lp1k.txt#L88
		(I3 => O) = (465, 423);
	endspecify
`endif
`ifdef ICE40_U
	specify
		// https://github.com/YosysHQ/icestorm/blob/be0bca0230d6fe1102e0a360b953fbb0d273a39f/icefuzz/timings_up5k.txt#L92
		(I0 => O) = (1245, 1285);
		// https://github.com/YosysHQ/icestorm/blob/be0bca0230d6fe1102e0a360b953fbb0d273a39f/icefuzz/timings_up5k.txt#L95
		(I1 => O) = (1179, 1232);
		// https://github.com/YosysHQ/icestorm/blob/be0bca0230d6fe1102e0a360b953fbb0d273a39f/icefuzz/timings_up5k.txt#L98
		(I2 => O) = (1179, 1205);
		// https://github.com/YosysHQ/icestorm/blob/be0bca0230d6fe1102e0a360b953fbb0d273a39f/icefuzz/timings_up5k.txt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
		(I3 => O) = (861, 874);
	endspecify
`endif
endmodule

(* lib_whitebox *)
module SB_CARRY (output CO, input I0, I1, CI);
	assign CO = (I0 && I1) || ((I0 || I1) && CI);
`ifdef ICE40_HX
	specify
		// https://github.com/YosysHQ/icestorm/blob/be0bca0230d6fe1102e0a360b953fbb0d273a39f/icefuzz/timings_hx1k.txt#L79
		(CI => CO) = (126, 105);
		// https://github.com/YosysHQ/icestorm/blob/be0bca0230d6fe1102e0a360b953fbb0d273a39f/icefuzz/timings_hx1k.txt#L82
		(I0 => CO) = (259, 245);
		// https://github.com/YosysHQ/icestorm/blob/be0bca0230d6fe1102e0a360b953fbb0d273a39f/icefuzz/timings_hx1k.txt#L85
		(I1 => CO) = (231, 133);
	endspecify
`endif
`ifdef ICE40_LP
	specify
		// https://github.com/YosysHQ/icestorm/blob/be0bca0230d6fe1102e0a360b953fbb0d273a39f/icefuzz/timings_lp1k.txt#L79
		(CI => CO) = (186, 155);
		// https://github.com/YosysHQ/icestorm/blob/be0bca0230d6fe1102e0a360b953fbb0d273a39f/icefuzz/timings_lp1k.txt#L82
		(I0 => CO) = (382, 362);
		// https://github.com/YosysHQ/icestorm/blob/be0bca0230d6fe1102e0a360b953fbb0d273a39f/icefuzz/timings_lp1k.txt#L85
		(I1 => CO) = (341, 196);
	endspecify
`endif
`ifdef ICE40_U
	specify
		// https://github.com/YosysHQ/icestorm/blob/be0bca0230d6fe1102e0a360b953fbb0d273a39f/icefuzz/timings_up5k.txt#L91
		(CI => CO) = (278, 278);
		// https://github.com/YosysHQ/icestorm/blob/be0bca0230d6fe1102e0a360b953fbb0d273a39f/icefuzz/timings_up5k.txt#L94
		(I0 => CO) = (675, 662);
		// https://github.com/YosysHQ/icestorm/blob/be0bca0230d6fe1102e0a360b953fbb0d273a39f/icefuzz/timings_up5k.txt#L97
		(I1 => CO) = (609, 358);
	endspecify
`endif
endmodule

// Positive Edge SiliconBlue FF Cells

(* abc9_flop, lib_whitebox *)
module SB_DFF (
	output reg Q,
	input C, D
);
	`SB_DFF_INIT

	always @(posedge C)
		Q <= D;
`ifdef ICE40_HX
	specify
		// https://github.com/YosysHQ/icestorm/blob/95949315364f8d9b0c693386aefadf44b28e2cf6/icefuzz/timings_hx1k.txt#L74
		//   minus https://github.com/YosysHQ/icestorm/blob/95949315364f8d9b0c693386aefadf44b28e2cf6/icefuzz/timings_hx1k.txt#L80
		$setup(D, posedge C, 470 - 449);
		// https://github.com/YosysHQ/icestorm/blob/95949315364f8d9b0c693386aefadf44b28e2cf6/icefuzz/timings_hx1k.txt#L90
		(posedge C => (Q : D)) = 540;
	endspecify
`endif
`ifdef ICE40_LP
	specify
		// https://github.com/YosysHQ/icestorm/blob/95949315364f8d9b0c693386aefadf44b28e2cf6/icefuzz/timings_lp1k.txt#L74
		//   minus https://github.com/YosysHQ/icestorm/blob/95949315364f8d9b0c693386aefadf44b28e2cf6/icefuzz/timings_lp1k.txt#L80
		$setup(D, posedge C, 693 - 662);
		// https://github.com/YosysHQ/icestorm/blob/95949315364f8d9b0c693386aefadf44b28e2cf6/icefuzz/timings_lp1k.txt#L90
		(posedge C => (Q : D)) = 796;
	endspecify
`endif
`ifdef ICE40_U
	specify
		// https://github.com/YosysHQ/icestorm/blob/95949315364f8d9b0c693386aefadf44b28e2cf6/icefuzz/timings_lp1k.txt#L86
		//   minus https://github.com/YosysHQ/icestorm/blob/95949315364f8d9b0c693386aefadf44b28e2cf6/icefuzz/timings_lp1k.txt#L80
		$setup(D, posedge C, /*1232 - 1285*/ 0); // Negative times not currently supported
		// https://github.com/YosysHQ/icestorm/blob/95949315364f8d9b0c693386aefadf44b28e2cf6/icefuzz/timings_up5k.txt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
		(posedge C => (Q : D)) = 1391;
	endspecify
`endif
endmodule

(* abc9_flop, lib_whitebox *)
module SB_DFFE (
	output reg Q,
	input C,
	input E `ICE40_DEFAULT_ASSIGNMENT_1,
	input D
);
	`SB_DFF_INIT

	always @(posedge C)
		if (E)
			Q <= D;
`ifdef ICE40_HX
	specify
		// https://github.com/YosysHQ/icestorm/blob/95949315364f8d9b0c693386aefadf44b28e2cf6/icefuzz/timings_hx1k.txt#L74
		//   minus https://github.com/YosysHQ/icestorm/blob/95949315364f8d9b0c693386aefadf44b28e2cf6/icefuzz/timings_hx1k.txt#L80
		$setup(D, posedge C &&& E, 470 - 449);
		// https://github.com/YosysHQ/icestorm/blob/95949315364f8d9b0c693386aefadf44b28e2cf6/icefuzz/timings_hx1k.txt#L73
		$setup(E, posedge C, 0);
		// https://github.com/YosysHQ/icestorm/blob/95949315364f8d9b0c693386aefadf44b28e2cf6/icefuzz/timings_hx1k.txt#L90
		if (E) (posedge C => (Q : D)) = 540;
	endspecify
`endif
`ifdef ICE40_LP
	specify
		// https://github.com/YosysHQ/icestorm/blob/95949315364f8d9b0c693386aefadf44b28e2cf6/icefuzz/timings_lp1k.txt#L74
		//   minus https://github.com/YosysHQ/icestorm/blob/95949315364f8d9b0c693386aefadf44b28e2cf6/icefuzz/timings_lp1k.txt#L80
		$setup(D, posedge C &&& E, 693 - 662);
		// https://github.com/YosysHQ/icestorm/blob/95949315364f8d9b0c693386aefadf44b28e2cf6/icefuzz/timings_lp1k.txt#L73
		$setup(E, posedge C, 0);
		// https://github.com/YosysHQ/icestorm/blob/95949315364f8d9b0c693386aefadf44b28e2cf6/icefuzz/timings_lp1k.txt#L90
		if (E) (posedge C => (Q : D)) = 796;
	endspecify
`endif
`ifdef ICE40_U
	specify
		// https://github.com/YosysHQ/icestorm/blob/95949315364f8d9b0c693386aefadf44b28e2cf6/icefuzz/timings_lp1k.txt#L86
		//   minus https://github.com/YosysHQ/icestorm/blob/95949315364f8d9b0c693386aefadf44b28e2cf6/icefuzz/timings_lp1k.txt#L80
		$setup(D, posedge C &&& E, /*1232 - 1285*/ 0); // Negative times not currently supported
		// https://github.com/YosysHQ/icestorm/blob/95949315364f8d9b0c693386aefadf44b28e2cf6/icefuzz/timings_up5k.txt#L86
		$setup(E, posedge C, 0);
		// https://github.com/YosysHQ/icestorm/blob/95949315364f8d9b0c693386aefadf44b28e2cf6/icefuzz/timings_up5k.txt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
		if (E) (posedge C => (Q : D)) = 1391;
	endspecify
`endif
endmodule

(* abc9_flop, lib_whitebox *)
module SB_DFFSR (
	output reg Q,
	input C, R, D
);
	`SB_DFF_INIT

	always @(posedge C)
		if (R)
			Q <= 0;
		else
			Q <= D;
`ifdef ICE40_HX
	specify
		// https://github.com/YosysHQ/icestorm/blob/95949315364f8d9b0c693386aefadf44b28e2cf6/icefuzz/timings_hx1k.txt#L74
		//   minus https://github.com/YosysHQ/icestorm/blob/95949315364f8d9b0c693386aefadf44b28e2cf6/icefuzz/timings_hx1k.txt#L80
		$setup(D, posedge C, 470 - 449);
		// https://github.com/YosysHQ/icestorm/blob/95949315364f8d9b0c693386aefadf44b28e2cf6/icefuzz/timings_hx1k.txt#L78
		$setup(R, posedge C, 203);
		// https://github.com/YosysHQ/icestorm/blob/95949315364f8d9b0c693386aefadf44b28e2cf6/icefuzz/timings_hx1k.txt#L90
		if ( R) (posedge C => (Q : 1'b0)) = 540;
		if (!R) (posedge C => (Q : D)) = 540;
	endspecify
`endif
`ifdef ICE40_LP
	specify
		// https://github.com/YosysHQ/icestorm/blob/95949315364f8d9b0c693386aefadf44b28e2cf6/icefuzz/timings_lp1k.txt#L74
		//   minus https://github.com/YosysHQ/icestorm/blob/95949315364f8d9b0c693386aefadf44b28e2cf6/icefuzz/timings_lp1k.txt#L80
		$setup(D, posedge C, 693 - 662);
		// https://github.com/YosysHQ/icestorm/blob/95949315364f8d9b0c693386aefadf44b28e2cf6/icefuzz/timings_lp1k.txt#L78
		$setup(R, posedge C, 299);
		// https://github.com/YosysHQ/icestorm/blob/95949315364f8d9b0c693386aefadf44b28e2cf6/icefuzz/timings_lp1k.txt#L90
		if ( R) (posedge C => (Q : 1'b0)) = 796;
		if (!R) (posedge C => (Q : D)) = 796;
	endspecify
`endif
`ifdef ICE40_U
	specify
		// https://github.com/YosysHQ/icestorm/blob/95949315364f8d9b0c693386aefadf44b28e2cf6/icefuzz/timings_lp1k.txt#L86
		//   minus https://github.com/YosysHQ/icestorm/blob/95949315364f8d9b0c693386aefadf44b28e2cf6/icefuzz/timings_lp1k.txt#L80
		$setup(D, posedge C, /*1232 - 1285*/ 0); // Negative times not currently supported
		// https://github.com/YosysHQ/icestorm/blob/95949315364f8d9b0c693386aefadf44b28e2cf6/icefuzz/timings_up5k.txt#L90
		$setup(R, posedge C, 530);
		// https://github.com/YosysHQ/icestorm/blob/95949315364f8d9b0c693386aefadf44b28e2cf6/icefuzz/timings_up5k.txt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
		if ( R) (posedge C => (Q : 1'b0)) = 1391;
		if (!R) (posedge C => (Q : D)) = 1391;
	endspecify
`endif
endmodule

(* abc9_box, lib_whitebox *)
module SB_DFFR (
	output reg Q,
	input C, R, D
);
	`SB_DFF_INIT

	always @(posedge C, posedge R)
		if (R)
			Q <= 0;
		else
			Q <= D;
`ifdef ICE40_HX
	specify
		// https://github.com/YosysHQ/icestorm/blob/95949315364f8d9b0c693386aefadf44b28e2cf6/icefuzz/timings_hx1k.txt#L74
		//   minus https://github.com/YosysHQ/icestorm/blob/95949315364f8d9b0c693386aefadf44b28e2cf6/icefuzz/timings_hx1k.txt#L80
		$setup(D, posedge C, 470 - 449);
		// https://github.com/YosysHQ/icestorm/blob/95949315364f8d9b0c693386aefadf44b28e2cf6/icefuzz/timings_hx1k.txt#L63
		$setup(negedge R, posedge C, 160);
		// https://github.com/YosysHQ/icestorm/blob/95949315364f8d9b0c693386aefadf44b28e2cf6/icefuzz/timings_hx1k.txt#L91
`ifndef YOSYS
		(posedge R => (Q : 1'b0)) = 599;
`else
		if (R) (R => Q) = 599;	// Technically, this should be an edge sensitive path
					// but for facilitating a bypass box, let's pretend it's
					// a simple path
`endif
		// https://github.com/YosysHQ/icestorm/blob/95949315364f8d9b0c693386aefadf44b28e2cf6/icefuzz/timings_hx1k.txt#L90
		if (!R) (posedge C => (Q : D)) = 540;
	endspecify
`endif
`ifdef ICE40_LP
	specify
		// https://github.com/YosysHQ/icestorm/blob/95949315364f8d9b0c693386aefadf44b28e2cf6/icefuzz/timings_lp1k.txt#L74
		//   minus https://github.com/YosysHQ/icestorm/blob/95949315364f8d9b0c693386aefadf44b28e2cf6/icefuzz/timings_lp1k.txt#L80
		$setup(D, posedge C, 693 - 662);
		// https://github.com/YosysHQ/icestorm/blob/95949315364f8d9b0c693386aefadf44b28e2cf6/icefuzz/timings_lp1k.txt#L63
		$setup(negedge R, posedge C, 235);
		// https://github.com/YosysHQ/icestorm/blob/95949315364f8d9b0c693386aefadf44b28e2cf6/icefuzz/timings_lp1k.txt#L91
`ifndef YOSYS
		(posedge R => (Q : 1'b0)) = 883;
`else
		if (R) (R => Q) = 883;	// Technically, this should be an edge sensitive path
					// but for facilitating a bypass box, let's pretend it's
					// a simple path
`endif
		// https://github.com/YosysHQ/icestorm/blob/95949315364f8d9b0c693386aefadf44b28e2cf6/icefuzz/timings_lp1k.txt#L90
		if (!R) (posedge C => (Q : D)) = 796;
	endspecify
`endif
`ifdef ICE40_U
	specify
		// https://github.com/YosysHQ/icestorm/blob/95949315364f8d9b0c693386aefadf44b28e2cf6/icefuzz/timings_lp1k.txt#L86
		//   minus https://github.com/YosysHQ/icestorm/blob/95949315364f8d9b0c693386aefadf44b28e2cf6/icefuzz/timings_lp1k.txt#L80
		$setup(D, posedge C, /*1232 - 1285*/ 0); // Negative times not currently supported
		// https://github.com/YosysHQ/icestorm/blob/95949315364f8d9b0c693386aefadf44b28e2cf6/icefuzz/timings_up5k.txt#L75
		$setup(negedge R, posedge C, 424);
		// https://github.com/YosysHQ/icestorm/blob/95949315364f8d9b0c693386aefadf44b28e2cf6/icefuzz/timings_up5k.txt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
`ifndef YOSYS
		(posedge R => (Q : 1'b0)) = 1589;
`else
		if (R) (R => Q) = 1589;	// Technically, this should be an edge sensitive path
					// but for facilitating a bypass box, let's pretend it's
					// a simple path
`endif
		// https://github.com/YosysHQ/icestorm/blob/95949315364f8d9b0c693386aefadf44b28e2cf6/icefuzz/timings_up5k.txt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
		if (!R) (posedge C => (Q : D)) = 1391;
	endspecify
`endif
endmodule

(* abc9_flop, lib_whitebox *)
module SB_DFFSS (
	output reg Q,
	input C, S, D
);
	`SB_DFF_INIT

	always @(posedge C)
		if (S)
			Q <= 1;
		else
			Q <= D;
`ifdef ICE40_HX
	specify
		// https://github.com/YosysHQ/icestorm/blob/95949315364f8d9b0c693386aefadf44b28e2cf6/icefuzz/timings_hx1k.txt#L74
		//   minus https://github.com/YosysHQ/icestorm/blob/95949315364f8d9b0c693386aefadf44b28e2cf6/icefuzz/timings_hx1k.txt#L80
		$setup(D, posedge C, 470 - 449);
		// https://github.com/YosysHQ/icestorm/blob/95949315364f8d9b0c693386aefadf44b28e2cf6/icefuzz/timings_hx1k.txt#L78
		$setup(S, posedge C, 203);
		// https://github.com/YosysHQ/icestorm/blob/95949315364f8d9b0c693386aefadf44b28e2cf6/icefuzz/timings_hx1k.txt#L90
		if ( S) (posedge C => (Q : 1'b1)) = 540;
		if (!S) (posedge C => (Q : D)) = 540;
	endspecify
`endif
`ifdef ICE40_LP
	specify
		// https://github.com/YosysHQ/icestorm/blob/95949315364f8d9b0c693386aefadf44b28e2cf6/icefuzz/timings_lp1k.txt#L74
		//   minus https://github.com/YosysHQ/icestorm/blob/95949315364f8d9b0c693386aefadf44b28e2cf6/icefuzz/timings_lp1k.txt#L80
		$setup(D, posedge C, 693 - 662);
		// https://github.com/YosysHQ/icestorm/blob/95949315364f8d9b0c693386aefadf44b28e2cf6/icefuzz/timings_lp1k.txt#L78
		$setup(S, posedge C, 299);
		// https://github.com/YosysHQ/icestorm/blob/95949315364f8d9b0c693386aefadf44b28e2cf6/icefuzz/timings_lp1k.txt#L90
		if ( S) (posedge C => (Q : 1'b1)) = 796;
		if (!S) (posedge C => (Q : D)) = 796;
	endspecify
`endif
`ifdef ICE40_U
	specify
		// https://github.com/YosysHQ/icestorm/blob/95949315364f8d9b0c693386aefadf44b28e2cf6/icefuzz/timings_lp1k.txt#L86
		//   minus https://github.com/YosysHQ/icestorm/blob/95949315364f8d9b0c693386aefadf44b28e2cf6/icefuzz/timings_lp1k.txt#L80
		$setup(D, posedge C, /*1232 - 1285*/ 0); // Negative times not currently supported
		// https://github.com/YosysHQ/icestorm/blob/95949315364f8d9b0c693386aefadf44b28e2cf6/icefuzz/timings_up5k.txt#L90
		$setup(S, posedge C, 530);
		// https://github.com/YosysHQ/icestorm/blob/95949315364f8d9b0c693386aefadf44b28e2cf6/icefuzz/timings_up5k.txt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
		if ( S) (posedge C => (Q : 1'b1)) = 1391;
		if (!S) (posedge C => (Q : D)) = 1391;
	endspecify
`endif
endmodule

(* abc9_box, lib_whitebox *)
module SB_DFFS (
	output reg Q,
	input C, S, D
);
	`SB_DFF_INIT

	always @(posedge C, posedge S)
		if (S)
			Q <= 1;
		else
			Q <= D;
`ifdef ICE40_HX
	specify
		// https://github.com/YosysHQ/icestorm/blob/95949315364f8d9b0c693386aefadf44b28e2cf6/icefuzz/timings_hx1k.txt#L74
		//   minus https://github.com/YosysHQ/icestorm/blob/95949315364f8d9b0c693386aefadf44b28e2cf6/icefuzz/timings_hx1k.txt#L80
		$setup(D, posedge C, 470 - 449);
		// https://github.com/YosysHQ/icestorm/blob/95949315364f8d9b0c693386aefadf44b28e2cf6/icefuzz/timings_hx1k.txt#L63
		$setup(negedge S, posedge C, 160);
		// https://github.com/YosysHQ/icestorm/blob/95949315364f8d9b0c693386aefadf44b28e2cf6/icefuzz/timings_hx1k.txt#L91
`ifndef YOSYS
		(posedge S => (Q : 1'b1)) = 599;
`else
		if (S) (S => Q) = 599;	// Technically, this should be an edge sensitive path
					// but for facilitating a bypass box, let's pretend it's
					// a simple path
`endif
		// https://github.com/YosysHQ/icestorm/blob/95949315364f8d9b0c693386aefadf44b28e2cf6/icefuzz/timings_hx1k.txt#L90
		if (!S) (posedge C => (Q : D)) = 540;
	endspecify
`endif
`ifdef ICE40_LP
	specify
		// https://github.com/YosysHQ/icestorm/blob/95949315364f8d9b0c693386aefadf44b28e2cf6/icefuzz/timings_lp1k.txt#L74
		//   minus https://github.com/YosysHQ/icestorm/blob/95949315364f8d9b0c693386aefadf44b28e2cf6/icefuzz/timings_lp1k.txt#L80
		$setup(D, posedge C, 693 - 662);
		// https://github.com/YosysHQ/icestorm/blob/95949315364f8d9b0c693386aefadf44b28e2cf6/icefuzz/timings_lp1k.txt#L63
		$setup(negedge S, posedge C, 235);
		// https://github.com/YosysHQ/icestorm/blob/95949315364f8d9b0c693386aefadf44b28e2cf6/icefuzz/timings_lp1k.txt#L91
`ifndef YOSYS
		(posedge S => (Q : 1'b1)) = 883;
`else
		if (S) (S => Q) = 883;	// Technically, this should be an edge sensitive path
					// but for facilitating a bypass box, let's pretend it's
					// a simple path
`endif
		// https://github.com/YosysHQ/icestorm/blob/95949315364f8d9b0c693386aefadf44b28e2cf6/icefuzz/timings_lp1k.txt#L90
		if (!S) (posedge C => (Q : D)) = 796;
	endspecify
`endif
`ifdef ICE40_U
	specify
		// https://github.com/YosysHQ/icestorm/blob/95949315364f8d9b0c693386aefadf44b28e2cf6/icefuzz/timings_lp1k.txt#L86
		//   minus https://github.com/YosysHQ/icestorm/blob/95949315364f8d9b0c693386aefadf44b28e2cf6/icefuzz/timings_lp1k.txt#L80
		$setup(D, posedge C, /*1232 - 1285*/ 0); // Negative times not currently supported
		// https://github.com/YosysHQ/icestorm/blob/95949315364f8d9b0c693386aefadf44b28e2cf6/icefuzz/timings_up5k.txt#L75
		$setup(negedge S, posedge C, 424);
		// https://github.com/YosysHQ/icestorm/blob/95949315364f8d9b0c693386aefadf44b28e2cf6/icefuzz/timings_up5k.txt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
`ifndef YOSYS
		(posedge S => (Q : 1'b1)) = 1589;
`else
		if (S) (S => Q) = 1589; // Technically, this should be an edge sensitive path
					// but for facilitating a bypass box, let's pretend it's
					// a simple path
`endif
		// https://github.com/YosysHQ/icestorm/blob/95949315364f8d9b0c693386aefadf44b28e2cf6/icefuzz/timings_up5k.txt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
		if (!S) (posedge C => (Q : D)) = 1391;
	endspecify
`endif
endmodule

(* abc9_flop, lib_whitebox *)
module SB_DFFESR (
	output reg Q,
	input C,
	input E `ICE40_DEFAULT_ASSIGNMENT_1,
	input R,
	input D
);
	`SB_DFF_INIT

	always @(posedge C)
		if (E) begin
			if (R)
				Q <= 0;
			else
				Q <= D;
		end
`ifdef ICE40_HX
	specify
		// https://github.com/YosysHQ/icestorm/blob/95949315364f8d9b0c693386aefadf44b28e2cf6/icefuzz/timings_hx1k.txt#L74
		//   minus https://github.com/YosysHQ/icestorm/blob/95949315364f8d9b0c693386aefadf44b28e2cf6/icefuzz/timings_hx1k.txt#L80
		$setup(D, posedge C &&& E && !R, 470 - 449);
		// https://github.com/YosysHQ/icestorm/blob/95949315364f8d9b0c693386aefadf44b28e2cf6/icefuzz/timings_hx1k.txt#L73
		$setup(E, posedge C, 0);
		// https://github.com/YosysHQ/icestorm/blob/95949315364f8d9b0c693386aefadf44b28e2cf6/icefuzz/timings_hx1k.txt#L78
		$setup(R, posedge C &&& E, 203);
		// https://github.com/YosysHQ/icestorm/blob/95949315364f8d9b0c693386aefadf44b28e2cf6/icefuzz/timings_hx1k.txt#L90
		if (E &&  R) (posedge C => (Q : 1'b0)) = 540;
		if (E && !R) (posedge C => (Q : D)) = 540;
	endspecify
`endif
`ifdef ICE40_LP
	specify
		// https://github.com/YosysHQ/icestorm/blob/95949315364f8d9b0c693386aefadf44b28e2cf6/icefuzz/timings_lp1k.txt#L74
		//   minus https://github.com/YosysHQ/icestorm/blob/95949315364f8d9b0c693386aefadf44b28e2cf6/icefuzz/timings_lp1k.txt#L80
		$setup(D, posedge C &&& E && !R, 693 - 662);
		// https://github.com/YosysHQ/icestorm/blob/95949315364f8d9b0c693386aefadf44b28e2cf6/icefuzz/timings_lp1k.txt#L73
		$setup(E, posedge C, 0);
		// https://github.com/YosysHQ/icestorm/blob/95949315364f8d9b0c693386aefadf44b28e2cf6/icefuzz/timings_lp1k.txt#L78
		$setup(R, posedge C &&& E, 299);
		// https://github.com/YosysHQ/icestorm/blob/95949315364f8d9b0c693386aefadf44b28e2cf6/icefuzz/timings_lp1k.txt#L90
		if (E &&  R) (posedge C => (Q : 1'b0)) = 796;
		if (E && !R) (posedge C => (Q : D)) = 796;
	endspecify
`endif
`ifdef ICE40_U
	specify
		// https://github.com/YosysHQ/icestorm/blob/95949315364f8d9b0c693386aefadf44b28e2cf6/icefuzz/timings_lp1k.txt#L86
		//   minus https://github.com/YosysHQ/icestorm/blob/95949315364f8d9b0c693386aefadf44b28e2cf6/icefuzz/timings_lp1k.txt#L80
		$setup(D, posedge C &&& E, /*1232 - 1285*/ 0); // Negative times not currently supported
		// https://github.com/YosysHQ/icestorm/blob/95949315364f8d9b0c693386aefadf44b28e2cf6/icefuzz/timings_up5k.txt#L86
		$setup(E, posedge C, 0);
		// https://github.com/YosysHQ/icestorm/blob/95949315364f8d9b0c693386aefadf44b28e2cf6/icefuzz/timings_up5k.txt#L90
		$setup(R, posedge C &&& E, 530);
		// https://github.com/YosysHQ/icestorm/blob/95949315364f8d9b0c693386aefadf44b28e2cf6/icefuzz/timings_up5k.txt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
		if (E &&  R) (posedge C => (Q : 1'b0)) = 1391;
		if (E && !R) (posedge C => (Q : D)) = 1391;
	endspecify
`endif
endmodule

(* abc9_box, lib_whitebox *)
module SB_DFFER (
	output reg Q,
	input C,
	input E `ICE40_DEFAULT_ASSIGNMENT_1,
	input R,
	input D
);
	`SB_DFF_INIT

	always @(posedge C, posedge R)
		if (R)
			Q <= 0;
		else if (E)
			Q <= D;
`ifdef ICE40_HX
	specify
		// https://github.com/YosysHQ/icestorm/blob/95949315364f8d9b0c693386aefadf44b28e2cf6/icefuzz/timings_hx1k.txt#L74
		//   minus https://github.com/YosysHQ/icestorm/blob/95949315364f8d9b0c693386aefadf44b28e2cf6/icefuzz/timings_hx1k.txt#L80
		$setup(D, posedge C &&& E, 470 - 449);
		// https://github.com/YosysHQ/icestorm/blob/95949315364f8d9b0c693386aefadf44b28e2cf6/icefuzz/timings_hx1k.txt#L73
		$setup(E, posedge C, 0);
		// https://github.com/YosysHQ/icestorm/blob/95949315364f8d9b0c693386aefadf44b28e2cf6/icefuzz/timings_hx1k.txt#L63
		$setup(negedge R, posedge C, 160);
		// https://github.com/YosysHQ/icestorm/blob/95949315364f8d9b0c693386aefadf44b28e2cf6/icefuzz/timings_hx1k.txt#L91
`ifndef YOSYS
		(posedge R => (Q : 1'b0)) = 599;
`else
		if (R) (R => Q) = 599;	// Technically, this should be an edge sensitive path
					// but for facilitating a bypass box, let's pretend it's
					// a simple path
`endif
		// https://github.com/YosysHQ/icestorm/blob/95949315364f8d9b0c693386aefadf44b28e2cf6/icefuzz/timings_hx1k.txt#L90
		if (E && !R) (posedge C => (Q : D)) = 540;
	endspecify
`endif
`ifdef ICE40_LP
	specify
		// https://github.com/YosysHQ/icestorm/blob/95949315364f8d9b0c693386aefadf44b28e2cf6/icefuzz/timings_lp1k.txt#L74
		//   minus https://github.com/YosysHQ/icestorm/blob/95949315364f8d9b0c693386aefadf44b28e2cf6/icefuzz/timings_lp1k.txt#L80
		$setup(D, posedge C &&& E, 693 - 662);
		// https://github.com/YosysHQ/icestorm/blob/95949315364f8d9b0c693386aefadf44b28e2cf6/icefuzz/timings_lp1k.txt#L73
		$setup(E, posedge C, 0);
		// https://github.com/YosysHQ/icestorm/blob/95949315364f8d9b0c693386aefadf44b28e2cf6/icefuzz/timings_lp1k.txt#L63
		$setup(negedge R, posedge C, 235);
		// https://github.com/YosysHQ/icestorm/blob/95949315364f8d9b0c693386aefadf44b28e2cf6/icefuzz/timings_lp1k.txt#L91
`ifndef YOSYS
		(posedge R => (Q : 1'b0)) = 883;
`else
		if (R) (R => Q) = 883; 	// Technically, this should be an edge sensitive path
					// but for facilitating a bypass box, let's pretend it's
					// a simple path
`endif
		// https://github.com/YosysHQ/icestorm/blob/95949315364f8d9b0c693386aefadf44b28e2cf6/icefuzz/timings_lp1k.txt#L90
		if (E && !R) (posedge C => (Q : D)) = 796;
	endspecify
`endif
`ifdef ICE40_U
	specify
		// https://github.com/YosysHQ/icestorm/blob/95949315364f8d9b0c693386aefadf44b28e2cf6/icefuzz/timings_lp1k.txt#L86
		//   minus https://github.com/YosysHQ/icestorm/blob/95949315364f8d9b0c693386aefadf44b28e2cf6/icefuzz/timings_lp1k.txt#L80
		$setup(D, posedge C &&& E, /*1232 - 1285*/ 0); // Negative times not currently supported
		// https://github.com/YosysHQ/icestorm/blob/95949315364f8d9b0c693386aefadf44b28e2cf6/icefuzz/timings_up5k.txt#L86
		$setup(E, posedge C, 0);
		// https://github.com/YosysHQ/icestorm/blob/95949315364f8d9b0c693386aefadf44b28e2cf6/icefuzz/timings_up5k.txt#L75
		$setup(negedge R, posedge C, 424);
		// https://github.com/YosysHQ/icestorm/blob/95949315364f8d9b0c693386aefadf44b28e2cf6/icefuzz/timings_up5k.txt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
`ifndef YOSYS
		(posedge R => (Q : 1'b0)) = 1589;
`else
		if (R) (R => Q) = 1589;	// Technically, this should be an edge sensitive path
					// but for facilitating a bypass box, let's pretend it's
					// a simple path
`endif
		// https://github.com/YosysHQ/icestorm/blob/95949315364f8d9b0c693386aefadf44b28e2cf6/icefuzz/timings_up5k.txt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
		if (E && !R) (posedge C => (Q : D)) = 1391;
	endspecify
`endif
endmodule

(* abc9_flop, lib_whitebox *)
module SB_DFFESS (
	output reg Q,
	input C,
	input E `ICE40_DEFAULT_ASSIGNMENT_1,
	input S,
	input D
);
	`SB_DFF_INIT

	always @(posedge C)
		if (E) begin
			if (S)
				Q <= 1;
			else
				Q <= D;
		end
`ifdef ICE40_HX
	specify
		// https://github.com/YosysHQ/icestorm/blob/95949315364f8d9b0c693386aefadf44b28e2cf6/icefuzz/timings_hx1k.txt#L74
		//   minus https://github.com/YosysHQ/icestorm/blob/95949315364f8d9b0c693386aefadf44b28e2cf6/icefuzz/timings_hx1k.txt#L80
		$setup(D, posedge C &&& E && !S, 470 - 449);
		// https://github.com/YosysHQ/icestorm/blob/95949315364f8d9b0c693386aefadf44b28e2cf6/icefuzz/timings_hx1k.txt#L73
		$setup(E, posedge C, 0);
		// https://github.com/YosysHQ/icestorm/blob/95949315364f8d9b0c693386aefadf44b28e2cf6/icefuzz/timings_hx1k.txt#L78
		$setup(S, posedge C &&& E, 203);
		// https://github.com/YosysHQ/icestorm/blob/95949315364f8d9b0c693386aefadf44b28e2cf6/icefuzz/timings_hx1k.txt#L90
		if (E &&  S) (posedge C => (Q : 1'b1)) = 540;
		if (E && !S) (posedge C => (Q : D)) = 540;
	endspecify
`endif
`ifdef ICE40_LP
	specify
		// https://github.com/YosysHQ/icestorm/blob/95949315364f8d9b0c693386aefadf44b28e2cf6/icefuzz/timings_lp1k.txt#L74
		//   minus https://github.com/YosysHQ/icestorm/blob/95949315364f8d9b0c693386aefadf44b28e2cf6/icefuzz/timings_lp1k.txt#L80
		$setup(D, posedge C &&& E && !S, 693 - 662);
		// https://github.com/YosysHQ/icestorm/blob/95949315364f8d9b0c693386aefadf44b28e2cf6/icefuzz/timings_lp1k.txt#L73
		$setup(E, posedge C, 0);
		// https://github.com/YosysHQ/icestorm/blob/95949315364f8d9b0c693386aefadf44b28e2cf6/icefuzz/timings_lp1k.txt#L78
		$setup(S, posedge C &&& E, 299);
		// https://github.com/YosysHQ/icestorm/blob/95949315364f8d9b0c693386aefadf44b28e2cf6/icefuzz/timings_lp1k.txt#L90
		if (E &&  S) (posedge C => (Q : 1'b1)) = 796;
		if (E && !S) (posedge C => (Q : D)) = 796;
	endspecify
`endif
`ifdef ICE40_U
	specify
		// https://github.com/YosysHQ/icestorm/blob/95949315364f8d9b0c693386aefadf44b28e2cf6/icefuzz/timings_lp1k.txt#L86
		//   minus https://github.com/YosysHQ/icestorm/blob/95949315364f8d9b0c693386aefadf44b28e2cf6/icefuzz/timings_lp1k.txt#L80
		$setup(D, posedge C &&& E, /*1232 - 1285*/ 0); // Negative times not currently supported
		// https://github.com/YosysHQ/icestorm/blob/95949315364f8d9b0c693386aefadf44b28e2cf6/icefuzz/timings_up5k.txt#L86
		$setup(E, posedge C, 0);
		// https://github.com/YosysHQ/icestorm/blob/95949315364f8d9b0c693386aefadf44b28e2cf6/icefuzz/timings_up5k.txt#L90
		$setup(S, posedge C &&& E, 530);
		// https://github.com/YosysHQ/icestorm/blob/95949315364f8d9b0c693386aefadf44b28e2cf6/icefuzz/timings_up5k.txt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
		if (E &&  S) (posedge C => (Q : 1'b1)) = 1391;
		if (E && !S) (posedge C => (Q : D)) = 1391;
	endspecify
`endif
endmodule

(* abc9_box, lib_whitebox *)
module SB_DFFES (
	output reg Q,
	input C,
	input E `ICE40_DEFAULT_ASSIGNMENT_1,
	input S,
	input D
);
	`SB_DFF_INIT

	always @(posedge C, posedge S)
		if (S)
			Q <= 1;
		else if (E)
			Q <= D;
`ifdef ICE40_HX
	specify
		// https://github.com/YosysHQ/icestorm/blob/95949315364f8d9b0c693386aefadf44b28e2cf6/icefuzz/timings_hx1k.txt#L74
		//   minus https://github.com/YosysHQ/icestorm/blob/95949315364f8d9b0c693386aefadf44b28e2cf6/icefuzz/timings_hx1k.txt#L80
		$setup(D, posedge C &&& E, 470 - 449);
		// https://github.com/YosysHQ/icestorm/blob/95949315364f8d9b0c693386aefadf44b28e2cf6/icefuzz/timings_hx1k.txt#L73
		$setup(E, posedge C, 0);
		// https://github.com/YosysHQ/icestorm/blob/95949315364f8d9b0c693386aefadf44b28e2cf6/icefuzz/timings_hx1k.txt#L63
		$setup(posedge S, posedge C, 160);
		// https://github.com/YosysHQ/icestorm/blob/95949315364f8d9b0c693386aefadf44b28e2cf6/icefuzz/timings_hx1k.txt#L91
`ifndef YOSYS
		(posedge S => (Q : 1'b1)) = 599;
`else
		if (S) (S => Q) = 599;	// Technically, this should be an edge sensitive path
					// but for facilitating a bypass box, let's pretend it's
					// a simple path
`endif
		// https://github.com/YosysHQ/icestorm/blob/95949315364f8d9b0c693386aefadf44b28e2cf6/icefuzz/timings_hx1k.txt#L90
		if (E && !S) (posedge C => (Q : D)) = 540;
	endspecify
`endif
`ifdef ICE40_LP
	specify
		// https://github.com/YosysHQ/icestorm/blob/95949315364f8d9b0c693386aefadf44b28e2cf6/icefuzz/timings_lp1k.txt#L74
		//   minus https://github.com/YosysHQ/icestorm/blob/95949315364f8d9b0c693386aefadf44b28e2cf6/icefuzz/timings_lp1k.txt#L80
		$setup(D, posedge C &&& E, 693 - 662);
		// https://github.com/YosysHQ/icestorm/blob/95949315364f8d9b0c693386aefadf44b28e2cf6/icefuzz/timings_lp1k.txt#L73
		$setup(E, posedge C, 0);
		// https://github.com/YosysHQ/icestorm/blob/95949315364f8d9b0c693386aefadf44b28e2cf6/icefuzz/timings_lp1k.txt#L63
		$setup(posedge S, posedge C, 235);
		// https://github.com/YosysHQ/icestorm/blob/95949315364f8d9b0c693386aefadf44b28e2cf6/icefuzz/timings_lp1k.txt#L91
`ifndef YOSYS
		(posedge S => (Q : 1'b1)) = 883;
`else
		if (S) (S => Q) = 883; // Technically, this should be an edge sensitive path
							   // but for facilitating a bypass box, let's pretend it's
							   // a simple path
`endif
		// https://github.com/YosysHQ/icestorm/blob/95949315364f8d9b0c693386aefadf44b28e2cf6/icefuzz/timings_lp1k.txt#L90
		if (E && !S) (posedge C => (Q : D)) = 796;
	endspecify
`endif
`ifdef ICE40_U
	specify
		// https://github.com/YosysHQ/icestorm/blob/95949315364f8d9b0c693386aefadf44b28e2cf6/icefuzz/timings_lp1k.txt#L86
		//   minus https://github.com/YosysHQ/icestorm/blob/95949315364f8d9b0c693386aefadf44b28e2cf6/icefuzz/timings_lp1k.txt#L80
		$setup(D, posedge C &&& E, /*1232 - 1285*/ 0); // Negative times not currently supported
		// https://github.com/YosysHQ/icestorm/blob/95949315364f8d9b0c693386aefadf44b28e2cf6/icefuzz/timings_up5k.txt#L86
		$setup(E, posedge C, 0);
		// https://github.com/YosysHQ/icestorm/blob/95949315364f8d9b0c693386aefadf44b28e2cf6/icefuzz/timings_up5k.txt#L75
		$setup(posedge S, posedge C, 424);
		// https://github.com/YosysHQ/icestorm/blob/95949315364f8d9b0c693386aefadf44b28e2cf6/icefuzz/timings_up5k.txt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
`ifndef YOSYS
		(posedge S => (Q : 1'b1)) = 1589;
`else
		if (S) (S => Q) = 1589; // Technically, this should be an edge sensitive path
							   // but for facilitating a bypass box, let's pretend it's
							   // a simple path
`endif
		// https://github.com/YosysHQ/icestorm/blob/95949315364f8d9b0c693386aefadf44b28e2cf6/icefuzz/timings_up5k.txt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
		if (E && !S) (posedge C => (Q : D)) = 1391;
	endspecify
`endif
endmodule

// Negative Edge SiliconBlue FF Cells

(* abc9_flop, lib_whitebox *)
module SB_DFFN (
	output reg Q,
	input C, D
);
	`SB_DFF_INIT

	always @(negedge C)
		Q <= D;
`ifdef ICE40_HX
	specify
		// https://github.com/YosysHQ/icestorm/blob/95949315364f8d9b0c693386aefadf44b28e2cf6/icefuzz/timings_hx1k.txt#L74
		//   minus https://github.com/YosysHQ/icestorm/blob/95949315364f8d9b0c693386aefadf44b28e2cf6/icefuzz/timings_hx1k.txt#L80
		$setup(D, negedge C, 470 - 449);
		// https://github.com/YosysHQ/icestorm/blob/95949315364f8d9b0c693386aefadf44b28e2cf6/icefuzz/timings_hx1k.txt#L90
		(negedge C => (Q : D)) = 540;
	endspecify
`endif
`ifdef ICE40_LP
	specify
		// https://github.com/YosysHQ/icestorm/blob/95949315364f8d9b0c693386aefadf44b28e2cf6/icefuzz/timings_lp1k.txt#L74
		//   minus https://github.com/YosysHQ/icestorm/blob/95949315364f8d9b0c693386aefadf44b28e2cf6/icefuzz/timings_lp1k.txt#L80
		$setup(D, negedge C, 693 - 662);
		// https://github.com/YosysHQ/icestorm/blob/95949315364f8d9b0c693386aefadf44b28e2cf6/icefuzz/timings_lp1k.txt#L90
		(negedge C => (Q : D)) = 796;
	endspecify
`endif
`ifdef ICE40_U
	specify
		// https://github.com/YosysHQ/icestorm/blob/95949315364f8d9b0c693386aefadf44b28e2cf6/icefuzz/timings_lp1k.txt#L86
		//   minus https://github.com/YosysHQ/icestorm/blob/95949315364f8d9b0c693386aefadf44b28e2cf6/icefuzz/timings_lp1k.txt#L80
		$setup(D, negedge C, /*1232 - 1285*/ 0); // Negative times not currently supported
		// https://github.com/YosysHQ/icestorm/blob/95949315364f8d9b0c693386aefadf44b28e2cf6/icefuzz/timings_up5k.txt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
		(negedge C => (Q : D)) = 1391;
	endspecify
`endif
endmodule

(* abc9_flop, lib_whitebox *)
module SB_DFFNE (
	output reg Q,
	input C,
	input E `ICE40_DEFAULT_ASSIGNMENT_1,
	input D
);
	`SB_DFF_INIT

	always @(negedge C)
		if (E)
			Q <= D;
`ifdef ICE40_HX
	specify
		// https://github.com/YosysHQ/icestorm/blob/95949315364f8d9b0c693386aefadf44b28e2cf6/icefuzz/timings_hx1k.txt#L74
		//   minus https://github.com/YosysHQ/icestorm/blob/95949315364f8d9b0c693386aefadf44b28e2cf6/icefuzz/timings_hx1k.txt#L80
		$setup(D, negedge C &&& E, 470 - 449);
		// https://github.com/YosysHQ/icestorm/blob/95949315364f8d9b0c693386aefadf44b28e2cf6/icefuzz/timings_hx1k.txt#L73
		$setup(E, negedge C, 0);
		// https://github.com/YosysHQ/icestorm/blob/95949315364f8d9b0c693386aefadf44b28e2cf6/icefuzz/timings_hx1k.txt#L90
		if (E) (negedge C => (Q : D)) = 540;
	endspecify
`endif
`ifdef ICE40_LP
	specify
		// https://github.com/YosysHQ/icestorm/blob/95949315364f8d9b0c693386aefadf44b28e2cf6/icefuzz/timings_lp1k.txt#L74
		//   minus https://github.com/YosysHQ/icestorm/blob/95949315364f8d9b0c693386aefadf44b28e2cf6/icefuzz/timings_lp1k.txt#L80
		$setup(D, negedge C &&& E, 693 - 662);
		// https://github.com/YosysHQ/icestorm/blob/95949315364f8d9b0c693386aefadf44b28e2cf6/icefuzz/timings_lp1k.txt#L73
		$setup(E, negedge C, 0);
		// https://github.com/YosysHQ/icestorm/blob/95949315364f8d9b0c693386aefadf44b28e2cf6/icefuzz/timings_lp1k.txt#L90
		if (E) (negedge C => (Q : D)) = 796;
	endspecify
`endif
`ifdef ICE40_U
	specify
		// https://github.com/YosysHQ/icestorm/blob/95949315364f8d9b0c693386aefadf44b28e2cf6/icefuzz/timings_lp1k.txt#L86
		//   minus https://github.com/YosysHQ/icestorm/blob/95949315364f8d9b0c693386aefadf44b28e2cf6/icefuzz/timings_lp1k.txt#L80
		$setup(D, negedge C &&& E, /*1232 - 1285*/ 0); // Negative times not currently supported
		// https://github.com/YosysHQ/icestorm/blob/95949315364f8d9b0c693386aefadf44b28e2cf6/icefuzz/timings_up5k.txt#L86
		$setup(E, negedge C, 0);
		// https://github.com/YosysHQ/icestorm/blob/95949315364f8d9b0c693386aefadf44b28e2cf6/icefuzz/timings_up5k.txt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
		if (E) (negedge C => (Q : D)) = 1391;
	endspecify
`endif
endmodule

(* abc9_flop, lib_whitebox *)
module SB_DFFNSR (
	output reg Q,
	input C, R, D
);
	`SB_DFF_INIT

	always @(negedge C)
		if (R)
			Q <= 0;
		else
			Q <= D;
`ifdef ICE40_HX
	specify
		// https://github.com/YosysHQ/icestorm/blob/95949315364f8d9b0c693386aefadf44b28e2cf6/icefuzz/timings_hx1k.txt#L74
		//   minus https://github.com/YosysHQ/icestorm/blob/95949315364f8d9b0c693386aefadf44b28e2cf6/icefuzz/timings_hx1k.txt#L80
		$setup(D, negedge C, 470 - 449);
		// https://github.com/YosysHQ/icestorm/blob/95949315364f8d9b0c693386aefadf44b28e2cf6/icefuzz/timings_hx1k.txt#L73
		$setup(R, negedge C, 203);
		// https://github.com/YosysHQ/icestorm/blob/95949315364f8d9b0c693386aefadf44b28e2cf6/icefuzz/timings_hx1k.txt#L90
		if ( R) (negedge C => (Q : 1'b0)) = 540;
		if (!R) (negedge C => (Q : D)) = 540;
	endspecify
`endif
`ifdef ICE40_LP
	specify
		// https://github.com/YosysHQ/icestorm/blob/95949315364f8d9b0c693386aefadf44b28e2cf6/icefuzz/timings_lp1k.txt#L74
		//   minus https://github.com/YosysHQ/icestorm/blob/95949315364f8d9b0c693386aefadf44b28e2cf6/icefuzz/timings_lp1k.txt#L80
		$setup(D, negedge C, 693 - 662);
		// https://github.com/YosysHQ/icestorm/blob/95949315364f8d9b0c693386aefadf44b28e2cf6/icefuzz/timings_lp1k.txt#L78
		$setup(R, negedge C, 299);
		// https://github.com/YosysHQ/icestorm/blob/95949315364f8d9b0c693386aefadf44b28e2cf6/icefuzz/timings_lp1k.txt#L90
		if ( R) (negedge C => (Q : 1'b0)) = 796;
		if (!R) (negedge C => (Q : D)) = 796;
	endspecify
`endif
`ifdef ICE40_U
	specify
		// https://github.com/YosysHQ/icestorm/blob/95949315364f8d9b0c693386aefadf44b28e2cf6/icefuzz/timings_lp1k.txt#L86
		//   minus https://github.com/YosysHQ/icestorm/blob/95949315364f8d9b0c693386aefadf44b28e2cf6/icefuzz/timings_lp1k.txt#L80
		$setup(D, negedge C, /*1232 - 1285*/ 0); // Negative times not currently supported
		// https://github.com/YosysHQ/icestorm/blob/95949315364f8d9b0c693386aefadf44b28e2cf6/icefuzz/timings_up5k.txt#L90
		$setup(R, negedge C, 530);
		// https://github.com/YosysHQ/icestorm/blob/95949315364f8d9b0c693386aefadf44b28e2cf6/icefuzz/timings_up5k.txt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
		if ( R) (negedge C => (Q : 1'b0)) = 1391;
		if (!R) (negedge C => (Q : D)) = 1391;
	endspecify
`endif
endmodule

(* abc9_flop, lib_whitebox *)
module SB_DFFNR (
	output reg Q,
	input C, R, D
);
	`SB_DFF_INIT

	always @(negedge C, posedge R)
		if (R)
			Q <= 0;
		else
			Q <= D;
`ifdef ICE40_HX
	specify
		// https://github.com/YosysHQ/icestorm/blob/95949315364f8d9b0c693386aefadf44b28e2cf6/icefuzz/timings_hx1k.txt#L74
		//   minus https://github.com/YosysHQ/icestorm/blob/95949315364f8d9b0c693386aefadf44b28e2cf6/icefuzz/timings_hx1k.txt#L80
		$setup(D, negedge C, 470 - 449);
		// https://github.com/YosysHQ/icestorm/blob/95949315364f8d9b0c693386aefadf44b28e2cf6/icefuzz/timings_hx1k.txt#L63
		$setup(negedge R, negedge C, 160);
		// https://github.com/YosysHQ/icestorm/blob/95949315364f8d9b0c693386aefadf44b28e2cf6/icefuzz/timings_hx1k.txt#L91
`ifndef YOSYS
		(posedge R => (Q : 1'b0)) = 599;
`else
		if (R) (R => Q) = 599;	// Technically, this should be an edge sensitive path
					// but for facilitating a bypass box, let's pretend it's
					// a simple path
`endif
		// https://github.com/YosysHQ/icestorm/blob/95949315364f8d9b0c693386aefadf44b28e2cf6/icefuzz/timings_hx1k.txt#L90
		if (!R) (negedge C => (Q : D)) = 540;
	endspecify
`endif
`ifdef ICE40_LP
	specify
		// https://github.com/YosysHQ/icestorm/blob/95949315364f8d9b0c693386aefadf44b28e2cf6/icefuzz/timings_lp1k.txt#L74
		//   minus https://github.com/YosysHQ/icestorm/blob/95949315364f8d9b0c693386aefadf44b28e2cf6/icefuzz/timings_lp1k.txt#L80
		$setup(D, negedge C, 693 - 662);
		// https://github.com/YosysHQ/icestorm/blob/95949315364f8d9b0c693386aefadf44b28e2cf6/icefuzz/timings_lp1k.txt#L63
		$setup(negedge R, negedge C, 235);
		// https://github.com/YosysHQ/icestorm/blob/95949315364f8d9b0c693386aefadf44b28e2cf6/icefuzz/timings_lp1k.txt#L91
`ifndef YOSYS
		(posedge R => (Q : 1'b0)) = 883;
`else
		if (R) (R => Q) = 883;	// Technically, this should be an edge sensitive path
					// but for facilitating a bypass box, let's pretend it's
					// a simple path
`endif
		// https://github.com/YosysHQ/icestorm/blob/95949315364f8d9b0c693386aefadf44b28e2cf6/icefuzz/timings_lp1k.txt#L90
		if (!R) (negedge C => (Q : D)) = 796;
	endspecify
`endif
`ifdef ICE40_U
	specify
		// https://github.com/YosysHQ/icestorm/blob/95949315364f8d9b0c693386aefadf44b28e2cf6/icefuzz/timings_lp1k.txt#L86
		//   minus https://github.com/YosysHQ/icestorm/blob/95949315364f8d9b0c693386aefadf44b28e2cf6/icefuzz/timings_lp1k.txt#L80
		$setup(D, negedge C, /*1232 - 1285*/ 0); // Negative times not currently supported
		// https://github.com/YosysHQ/icestorm/blob/95949315364f8d9b0c693386aefadf44b28e2cf6/icefuzz/timings_up5k.txt#L75
		$setup(negedge R, negedge C, 424);
		// https://github.com/YosysHQ/icestorm/blob/95949315364f8d9b0c693386aefadf44b28e2cf6/icefuzz/timings_up5k.txt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
`ifndef YOSYS
		(posedge R => (Q : 1'b0)) = 1589;
`else
		if (R) (R => Q) = 1589;	// Technically, this should be an edge sensitive path
					// but for facilitating a bypass box, let's pretend it's
					// a simple path
`endif
		// https://github.com/YosysHQ/icestorm/blob/95949315364f8d9b0c693386aefadf44b28e2cf6/icefuzz/timings_up5k.txt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
		if (!R) (negedge C => (Q : D)) = 1391;
	endspecify
`endif
endmodule

(* abc9_flop, lib_whitebox *)
module SB_DFFNSS (
	output reg Q,
	input C, S, D
);
	`SB_DFF_INIT

	always @(negedge C)
		if (S)
			Q <= 1;
		else
			Q <= D;
`ifdef ICE40_HX
	specify
		// https://github.com/YosysHQ/icestorm/blob/95949315364f8d9b0c693386aefadf44b28e2cf6/icefuzz/timings_hx1k.txt#L74
		//   minus https://github.com/YosysHQ/icestorm/blob/95949315364f8d9b0c693386aefadf44b28e2cf6/icefuzz/timings_hx1k.txt#L80
		$setup(D, negedge C, 470 - 449);
		// https://github.com/YosysHQ/icestorm/blob/95949315364f8d9b0c693386aefadf44b28e2cf6/icefuzz/timings_hx1k.txt#L73
		$setup(S, negedge C, 203);
		// https://github.com/YosysHQ/icestorm/blob/95949315364f8d9b0c693386aefadf44b28e2cf6/icefuzz/timings_hx1k.txt#L90
		if ( S) (negedge C => (Q : 1'b1)) = 540;
		if (!S) (negedge C => (Q : D)) = 540;
	endspecify
`endif
`ifdef ICE40_LP
	specify
		// https://github.com/YosysHQ/icestorm/blob/95949315364f8d9b0c693386aefadf44b28e2cf6/icefuzz/timings_lp1k.txt#L74
		//   minus https://github.com/YosysHQ/icestorm/blob/95949315364f8d9b0c693386aefadf44b28e2cf6/icefuzz/timings_lp1k.txt#L80
		$setup(D, negedge C, 693 - 662);
		// https://github.com/YosysHQ/icestorm/blob/95949315364f8d9b0c693386aefadf44b28e2cf6/icefuzz/timings_lp1k.txt#L78
		$setup(S, negedge C, 299);
		// https://github.com/YosysHQ/icestorm/blob/95949315364f8d9b0c693386aefadf44b28e2cf6/icefuzz/timings_lp1k.txt#L90
		if ( S) (negedge C => (Q : 1'b1)) = 796;
		if (!S) (negedge C => (Q : D)) = 796;
	endspecify
`endif
`ifdef ICE40_U
	specify
		// https://github.com/YosysHQ/icestorm/blob/95949315364f8d9b0c693386aefadf44b28e2cf6/icefuzz/timings_lp1k.txt#L86
		//   minus https://github.com/YosysHQ/icestorm/blob/95949315364f8d9b0c693386aefadf44b28e2cf6/icefuzz/timings_lp1k.txt#L80
		$setup(D, negedge C, /*1232 - 1285*/ 0); // Negative times not currently supported
		// https://github.com/YosysHQ/icestorm/blob/95949315364f8d9b0c693386aefadf44b28e2cf6/icefuzz/timings_up5k.txt#L90
		$setup(S, negedge C, 530);
		// https://github.com/YosysHQ/icestorm/blob/95949315364f8d9b0c693386aefadf44b28e2cf6/icefuzz/timings_up5k.txt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
		if ( S) (negedge C => (Q : 1'b1)) = 1391;
		if (!S) (negedge C => (Q : D)) = 1391;
	endspecify
`endif
endmodule

(* abc9_box, lib_whitebox *)
module SB_DFFNS (
	output reg Q,
	input C, S, D
);
	`SB_DFF_INIT

	always @(negedge C, posedge S)
		if (S)
			Q <= 1;
		else
			Q <= D;
`ifdef ICE40_HX
	specify
		// https://github.com/YosysHQ/icestorm/blob/95949315364f8d9b0c693386aefadf44b28e2cf6/icefuzz/timings_hx1k.txt#L74
		//   minus https://github.com/YosysHQ/icestorm/blob/95949315364f8d9b0c693386aefadf44b28e2cf6/icefuzz/timings_hx1k.txt#L80
		$setup(D, negedge C, 470 - 449);
		// https://github.com/YosysHQ/icestorm/blob/95949315364f8d9b0c693386aefadf44b28e2cf6/icefuzz/timings_hx1k.txt#L63
		$setup(negedge S, negedge C, 160);
		// https://github.com/YosysHQ/icestorm/blob/95949315364f8d9b0c693386aefadf44b28e2cf6/icefuzz/timings_hx1k.txt#L91
`ifndef YOSYS
		(posedge S => (Q : 1'b1)) = 599;
`else
		if (S) (S => Q) = 599;	// Technically, this should be an edge sensitive path
					// but for facilitating a bypass box, let's pretend it's
					// a simple path
`endif
		// https://github.com/YosysHQ/icestorm/blob/95949315364f8d9b0c693386aefadf44b28e2cf6/icefuzz/timings_hx1k.txt#L90
		if (!S) (negedge C => (Q : D)) = 540;
	endspecify
`endif
`ifdef ICE40_LP
	specify
		// https://github.com/YosysHQ/icestorm/blob/95949315364f8d9b0c693386aefadf44b28e2cf6/icefuzz/timings_lp1k.txt#L74
		//   minus https://github.com/YosysHQ/icestorm/blob/95949315364f8d9b0c693386aefadf44b28e2cf6/icefuzz/timings_lp1k.txt#L80
		$setup(D, negedge C, 693 - 662);
		// https://github.com/YosysHQ/icestorm/blob/95949315364f8d9b0c693386aefadf44b28e2cf6/icefuzz/timings_lp1k.txt#L63
		$setup(negedge S, negedge C, 235);
		// https://github.com/YosysHQ/icestorm/blob/95949315364f8d9b0c693386aefadf44b28e2cf6/icefuzz/timings_lp1k.txt#L91
`ifndef YOSYS
		(posedge S => (Q : 1'b1)) = 883;
`else
		if (S) (S => Q) = 883;	// Technically, this should be an edge sensitive path
					// but for facilitating a bypass box, let's pretend it's
					// a simple path
`endif
		// https://github.com/YosysHQ/icestorm/blob/95949315364f8d9b0c693386aefadf44b28e2cf6/icefuzz/timings_lp1k.txt#L90
		if (!S) (negedge C => (Q : D)) = 796;
	endspecify
`endif
`ifdef ICE40_U
	specify
		// https://github.com/YosysHQ/icestorm/blob/95949315364f8d9b0c693386aefadf44b28e2cf6/icefuzz/timings_lp1k.txt#L86
		//   minus https://github.com/YosysHQ/icestorm/blob/95949315364f8d9b0c693386aefadf44b28e2cf6/icefuzz/timings_lp1k.txt#L80
		$setup(D, negedge C, /*1232 - 1285*/ 0); // Negative times not currently supported
		// https://github.com/YosysHQ/icestorm/blob/95949315364f8d9b0c693386aefadf44b28e2cf6/icefuzz/timings_up5k.txt#L75
		$setup(negedge S, negedge C, 424);
		// https://github.com/YosysHQ/icestorm/blob/95949315364f8d9b0c693386aefadf44b28e2cf6/icefuzz/timings_up5k.txt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
`ifndef YOSYS
		(posedge S => (Q : 1'b1)) = 1589;
`else
		if (S) (S => Q) = 1589;	// Technically, this should be an edge sensitive path
					// but for facilitating a bypass box, let's pretend it's
					// a simple path
`endif
		// https://github.com/YosysHQ/icestorm/blob/95949315364f8d9b0c693386aefadf44b28e2cf6/icefuzz/timings_up5k.txt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
		if (!S) (negedge C => (Q : D)) = 1391;
	endspecify
`endif
endmodule

(* abc9_flop, lib_whitebox *)
module SB_DFFNESR (
	output reg Q,
	input C,
	input E `ICE40_DEFAULT_ASSIGNMENT_1,
	input R,
	input D
);
	`SB_DFF_INIT

	always @(negedge C)
		if (E) begin
			if (R)
				Q <= 0;
			else
				Q <= D;
		end
`ifdef ICE40_HX
	specify
		// https://github.com/YosysHQ/icestorm/blob/95949315364f8d9b0c693386aefadf44b28e2cf6/icefuzz/timings_hx1k.txt#L74
		//   minus https://github.com/YosysHQ/icestorm/blob/95949315364f8d9b0c693386aefadf44b28e2cf6/icefuzz/timings_hx1k.txt#L80
		$setup(D, negedge C &&& E && !R, 470 - 449);
		// https://github.com/YosysHQ/icestorm/blob/95949315364f8d9b0c693386aefadf44b28e2cf6/icefuzz/timings_hx1k.txt#L73
		$setup(E, negedge C, 0);
		// https://github.com/YosysHQ/icestorm/blob/95949315364f8d9b0c693386aefadf44b28e2cf6/icefuzz/timings_hx1k.txt#L78
		$setup(R, negedge C &&& E, 203);
		// https://github.com/YosysHQ/icestorm/blob/95949315364f8d9b0c693386aefadf44b28e2cf6/icefuzz/timings_hx1k.txt#L90
		if (E &&  R) (negedge C => (Q : 1'b0)) = 540;
		if (E && !R) (negedge C => (Q : D)) = 540;
	endspecify
`endif
`ifdef ICE40_LP
	specify
		// https://github.com/YosysHQ/icestorm/blob/95949315364f8d9b0c693386aefadf44b28e2cf6/icefuzz/timings_lp1k.txt#L74
		//   minus https://github.com/YosysHQ/icestorm/blob/95949315364f8d9b0c693386aefadf44b28e2cf6/icefuzz/timings_lp1k.txt#L80
		$setup(D, negedge C &&& E && !R, 693 - 662);
		// https://github.com/YosysHQ/icestorm/blob/95949315364f8d9b0c693386aefadf44b28e2cf6/icefuzz/timings_lp1k.txt#L73
		$setup(E, negedge C, 0);
		// https://github.com/YosysHQ/icestorm/blob/95949315364f8d9b0c693386aefadf44b28e2cf6/icefuzz/timings_lp1k.txt#L78
		$setup(R, negedge C &&& E, 299);
		// https://github.com/YosysHQ/icestorm/blob/95949315364f8d9b0c693386aefadf44b28e2cf6/icefuzz/timings_lp1k.txt#L90
		if (E &&  R) (negedge C => (Q : 1'b0)) = 796;
		if (E && !R) (negedge C => (Q : D)) = 796;
	endspecify
`endif
`ifdef ICE40_U
	specify
		// https://github.com/YosysHQ/icestorm/blob/95949315364f8d9b0c693386aefadf44b28e2cf6/icefuzz/timings_lp1k.txt#L86
		//   minus https://github.com/YosysHQ/icestorm/blob/95949315364f8d9b0c693386aefadf44b28e2cf6/icefuzz/timings_lp1k.txt#L80
		$setup(D, negedge C &&& E, /*1232 - 1285*/ 0); // Negative times not currently supported
		// https://github.com/YosysHQ/icestorm/blob/95949315364f8d9b0c693386aefadf44b28e2cf6/icefuzz/timings_up5k.txt#L86
		$setup(E, negedge C, 0);
		// https://github.com/YosysHQ/icestorm/blob/95949315364f8d9b0c693386aefadf44b28e2cf6/icefuzz/timings_up5k.txt#L90
		$setup(R, negedge C &&& E, 530);
		// https://github.com/YosysHQ/icestorm/blob/95949315364f8d9b0c693386aefadf44b28e2cf6/icefuzz/timings_up5k.txt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
		if (E &&  R) (negedge C => (Q : 1'b0)) = 1391;
		if (E && !R) (negedge C => (Q : D)) = 1391;
	endspecify
`endif
endmodule

(* abc9_box, lib_whitebox *)
module SB_DFFNER (
	output reg Q,
	input C,
	input E `ICE40_DEFAULT_ASSIGNMENT_1,
	input R,
	input D
);
	`SB_DFF_INIT

	always @(negedge C, posedge R)
		if (R)
			Q <= 0;
		else if (E)
			Q <= D;
`ifdef ICE40_HX
	specify
		// https://github.com/YosysHQ/icestorm/blob/95949315364f8d9b0c693386aefadf44b28e2cf6/icefuzz/timings_hx1k.txt#L74
		//   minus https://github.com/YosysHQ/icestorm/blob/95949315364f8d9b0c693386aefadf44b28e2cf6/icefuzz/timings_hx1k.txt#L80
		$setup(D, negedge C &&& E, 470 - 449);
		// https://github.com/YosysHQ/icestorm/blob/95949315364f8d9b0c693386aefadf44b28e2cf6/icefuzz/timings_hx1k.txt#L73
		$setup(E, negedge C, 0);
		// https://github.com/YosysHQ/icestorm/blob/95949315364f8d9b0c693386aefadf44b28e2cf6/icefuzz/timings_hx1k.txt#L63
		$setup(R, negedge C, 2160);
		// https://github.com/YosysHQ/icestorm/blob/95949315364f8d9b0c693386aefadf44b28e2cf6/icefuzz/timings_hx1k.txt#L91
`ifndef YOSYS
		(posedge R => (Q : 1'b0)) = 599;
`else
		if (R) (R => Q) = 599;	// Technically, this should be an edge sensitive path
					// but for facilitating a bypass box, let's pretend it's
					// a simple path
`endif
		// https://github.com/YosysHQ/icestorm/blob/95949315364f8d9b0c693386aefadf44b28e2cf6/icefuzz/timings_hx1k.txt#L90
		if (E && !R) (negedge C => (Q : D)) = 540;
	endspecify
`endif
`ifdef ICE40_LP
	specify
		// https://github.com/YosysHQ/icestorm/blob/95949315364f8d9b0c693386aefadf44b28e2cf6/icefuzz/timings_lp1k.txt#L74
		//   minus https://github.com/YosysHQ/icestorm/blob/95949315364f8d9b0c693386aefadf44b28e2cf6/icefuzz/timings_lp1k.txt#L80
		$setup(D, negedge C &&& E, 693 - 662);
		// https://github.com/YosysHQ/icestorm/blob/95949315364f8d9b0c693386aefadf44b28e2cf6/icefuzz/timings_lp1k.txt#L73
		$setup(E, negedge C, 0);
		// https://github.com/YosysHQ/icestorm/blob/95949315364f8d9b0c693386aefadf44b28e2cf6/icefuzz/timings_lp1k.txt#L63
		$setup(R, negedge C, 235);
		// https://github.com/YosysHQ/icestorm/blob/95949315364f8d9b0c693386aefadf44b28e2cf6/icefuzz/timings_lp1k.txt#L91
`ifndef YOSYS
		(posedge R => (Q : 1'b0)) = 883;
`else
		if (R) (R => Q) = 883;	// Technically, this should be an edge sensitive path
					// but for facilitating a bypass box, let's pretend it's
					// a simple path
`endif
		// https://github.com/YosysHQ/icestorm/blob/95949315364f8d9b0c693386aefadf44b28e2cf6/icefuzz/timings_lp1k.txt#L90
		if (E && !R) (negedge C => (Q : D)) = 796;
	endspecify
`endif
`ifdef ICE40_U
	specify
		// https://github.com/YosysHQ/icestorm/blob/95949315364f8d9b0c693386aefadf44b28e2cf6/icefuzz/timings_lp1k.txt#L86
		//   minus https://github.com/YosysHQ/icestorm/blob/95949315364f8d9b0c693386aefadf44b28e2cf6/icefuzz/timings_lp1k.txt#L80
		$setup(D, negedge C &&& E, /*1232 - 1285*/ 0); // Negative times not currently supported
		// https://github.com/YosysHQ/icestorm/blob/95949315364f8d9b0c693386aefadf44b28e2cf6/icefuzz/timings_up5k.txt#L86
		$setup(E, negedge C, 0);
		// https://github.com/YosysHQ/icestorm/blob/95949315364f8d9b0c693386aefadf44b28e2cf6/icefuzz/timings_up5k.txt#L75
		$setup(negedge R, negedge C, 424);
		// https://github.com/YosysHQ/icestorm/blob/95949315364f8d9b0c693386aefadf44b28e2cf6/icefuzz/timings_up5k.txt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
`ifndef YOSYS
		(posedge R => (Q : 1'b0)) = 1589;
`else
		if (R) (R => Q) = 1589;	// Technically, this should be an edge sensitive path
					// but for facilitating a bypass box, let's pretend it's
					// a simple path
`endif
		// https://github.com/YosysHQ/icestorm/blob/95949315364f8d9b0c693386aefadf44b28e2cf6/icefuzz/timings_up5k.txt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
		if (E && !R) (negedge C => (Q : D)) = 1391;
	endspecify
`endif
endmodule

(* abc9_flop, lib_whitebox *)
module SB_DFFNESS (
	output reg Q,
	input C,
	input E `ICE40_DEFAULT_ASSIGNMENT_1,
	input S,
	input D
);
	`SB_DFF_INIT

	always @(negedge C)
		if (E) begin
			if (S)
				Q <= 1;
			else
				Q <= D;
		end
`ifdef ICE40_HX
	specify
		// https://github.com/YosysHQ/icestorm/blob/95949315364f8d9b0c693386aefadf44b28e2cf6/icefuzz/timings_hx1k.txt#L74
		//   minus https://github.com/YosysHQ/icestorm/blob/95949315364f8d9b0c693386aefadf44b28e2cf6/icefuzz/timings_hx1k.txt#L80
		$setup(D, negedge C &&& E && !S, 470 - 449);
		// https://github.com/YosysHQ/icestorm/blob/95949315364f8d9b0c693386aefadf44b28e2cf6/icefuzz/timings_hx1k.txt#L73
		$setup(E, negedge C, 0);
		// https://github.com/YosysHQ/icestorm/blob/95949315364f8d9b0c693386aefadf44b28e2cf6/icefuzz/timings_hx1k.txt#L78
		$setup(S, negedge C &&& E, 203);
		// https://github.com/YosysHQ/icestorm/blob/95949315364f8d9b0c693386aefadf44b28e2cf6/icefuzz/timings_hx1k.txt#L90
		if (E &&  S) (negedge C => (Q : 1'b1)) = 540;
		if (E && !S) (negedge C => (Q : D)) = 540;
	endspecify
`endif
`ifdef ICE40_LP
	specify
		// https://github.com/YosysHQ/icestorm/blob/95949315364f8d9b0c693386aefadf44b28e2cf6/icefuzz/timings_lp1k.txt#L74
		//   minus https://github.com/YosysHQ/icestorm/blob/95949315364f8d9b0c693386aefadf44b28e2cf6/icefuzz/timings_lp1k.txt#L80
		$setup(D, negedge C &&& E && !S, 693 - 662);
		// https://github.com/YosysHQ/icestorm/blob/95949315364f8d9b0c693386aefadf44b28e2cf6/icefuzz/timings_lp1k.txt#L73
		$setup(E, negedge C, 0);
		// https://github.com/YosysHQ/icestorm/blob/95949315364f8d9b0c693386aefadf44b28e2cf6/icefuzz/timings_lp1k.txt#L78
		$setup(S, negedge C &&& E, 299);
		// https://github.com/YosysHQ/icestorm/blob/95949315364f8d9b0c693386aefadf44b28e2cf6/icefuzz/timings_lp1k.txt#L90
		if (E &&  S) (negedge C => (Q : 1'b1)) = 796;
		if (E && !S) (negedge C => (Q : D)) = 796;
	endspecify
`endif
`ifdef ICE40_U
	specify
		// https://github.com/YosysHQ/icestorm/blob/95949315364f8d9b0c693386aefadf44b28e2cf6/icefuzz/timings_lp1k.txt#L86
		//   minus https://github.com/YosysHQ/icestorm/blob/95949315364f8d9b0c693386aefadf44b28e2cf6/icefuzz/timings_lp1k.txt#L80
		$setup(D, negedge C &&& E, /*1232 - 1285*/ 0); // Negative times not currently supported
		// https://github.com/YosysHQ/icestorm/blob/95949315364f8d9b0c693386aefadf44b28e2cf6/icefuzz/timings_up5k.txt#L86
		$setup(E, negedge C, 0);
		// https://github.com/YosysHQ/icestorm/blob/95949315364f8d9b0c693386aefadf44b28e2cf6/icefuzz/timings_up5k.txt#L90
		$setup(S, negedge C &&& E, 530);
		// https://github.com/YosysHQ/icestorm/blob/95949315364f8d9b0c693386aefadf44b28e2cf6/icefuzz/timings_up5k.txt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
		if (E &&  S) (negedge C => (Q : 1'b1)) = 1391;
		if (E && !S) (negedge C => (Q : D)) = 1391;
	endspecify
`endif
endmodule

(* abc9_box, lib_whitebox *)
module SB_DFFNES (
	output reg Q,
	input C,
	input E `ICE40_DEFAULT_ASSIGNMENT_1,
	input S,
	input D
);
	`SB_DFF_INIT

	always @(negedge C, posedge S)
		if (S)
			Q <= 1;
		else if (E)
			Q <= D;
`ifdef ICE40_HX
	specify
		// https://github.com/YosysHQ/icestorm/blob/95949315364f8d9b0c693386aefadf44b28e2cf6/icefuzz/timings_hx1k.txt#L74
		//   minus https://github.com/YosysHQ/icestorm/blob/95949315364f8d9b0c693386aefadf44b28e2cf6/icefuzz/timings_hx1k.txt#L80
		$setup(D, negedge C &&& E, 470 - 449);
		// https://github.com/YosysHQ/icestorm/blob/95949315364f8d9b0c693386aefadf44b28e2cf6/icefuzz/timings_hx1k.txt#L73
		$setup(E, negedge C, 0);
		// https://github.com/YosysHQ/icestorm/blob/95949315364f8d9b0c693386aefadf44b28e2cf6/icefuzz/timings_hx1k.txt#L63
		$setup(negedge S, negedge C, 160);
		// https://github.com/YosysHQ/icestorm/blob/95949315364f8d9b0c693386aefadf44b28e2cf6/icefuzz/timings_hx1k.txt#L91
`ifndef YOSYS
		(posedge S => (Q : 1'b1)) = 599;
`else
        if (S) (S => Q) = 599; // Technically, this should be an edge sensitive path
                               // but for facilitating a bypass box, let's pretend it's
                               // a simple path
`endif

		// https://github.com/YosysHQ/icestorm/blob/95949315364f8d9b0c693386aefadf44b28e2cf6/icefuzz/timings_hx1k.txt#L90
		if (E && !S) (negedge C => (Q : D)) = 540;
	endspecify
`endif
`ifdef ICE40_LP
	specify
		// https://github.com/YosysHQ/icestorm/blob/95949315364f8d9b0c693386aefadf44b28e2cf6/icefuzz/timings_lp1k.txt#L74
		//   minus https://github.com/YosysHQ/icestorm/blob/95949315364f8d9b0c693386aefadf44b28e2cf6/icefuzz/timings_lp1k.txt#L80
		$setup(D, negedge C &&& E, 693 - 662);
		// https://github.com/YosysHQ/icestorm/blob/95949315364f8d9b0c693386aefadf44b28e2cf6/icefuzz/timings_lp1k.txt#L73
		$setup(E, negedge C, 0);
		// https://github.com/YosysHQ/icestorm/blob/95949315364f8d9b0c693386aefadf44b28e2cf6/icefuzz/timings_lp1k.txt#L63
		$setup(negedge S, negedge C, 235);
		// https://github.com/YosysHQ/icestorm/blob/95949315364f8d9b0c693386aefadf44b28e2cf6/icefuzz/timings_lp1k.txt#L91
`ifndef YOSYS
		(posedge S => (Q : 1'b1)) = 883;
`else
        if (S) (S => Q) = 883; // Technically, this should be an edge sensitive path
                               // but for facilitating a bypass box, let's pretend it's
                               // a simple path
`endif
		// https://github.com/YosysHQ/icestorm/blob/95949315364f8d9b0c693386aefadf44b28e2cf6/icefuzz/timings_lp1k.txt#L90
		if (E && !S) (negedge C => (Q : D)) = 796;
	endspecify
`endif
`ifdef ICE40_U
	specify
		// https://github.com/YosysHQ/icestorm/blob/95949315364f8d9b0c693386aefadf44b28e2cf6/icefuzz/timings_lp1k.txt#L86
		//   minus https://github.com/YosysHQ/icestorm/blob/95949315364f8d9b0c693386aefadf44b28e2cf6/icefuzz/timings_lp1k.txt#L80
		$setup(D, negedge C &&& E, /*1232 - 1285*/ 0); // Negative times not currently supported
		// https://github.com/YosysHQ/icestorm/blob/95949315364f8d9b0c693386aefadf44b28e2cf6/icefuzz/timings_up5k.txt#L86
		$setup(E, negedge C, 0);
		// https://github.com/YosysHQ/icestorm/blob/95949315364f8d9b0c693386aefadf44b28e2cf6/icefuzz/timings_up5k.txt#L75
		$setup(negedge S, negedge C, 424);
		// https://github.com/YosysHQ/icestorm/blob/95949315364f8d9b0c693386aefadf44b28e2cf6/icefuzz/timings_up5k.txt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
`ifndef YOSYS
		(posedge S => (Q : 1'b1)) = 1589;
`else
        if (S) (S => Q) = 1589; // Technically, this should be an edge sensitive path
                               // but for facilitating a bypass box, let's pretend it's
                               // a simple path
`endif
		// https://github.com/YosysHQ/icestorm/blob/95949315364f8d9b0c693386aefadf44b28e2cf6/icefuzz/timings_up5k.txt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
		if (E && !S) (negedge C => (Q : D)) = 1391;
	endspecify
`endif
endmodule

// SiliconBlue RAM Cells

module SB_RAM40_4K (
	output [15:0] RDATA,
	input         RCLK,
	input         RCLKE `ICE40_DEFAULT_ASSIGNMENT_1,
	input         RE `ICE40_DEFAULT_ASSIGNMENT_0,
	input  [10:0] RADDR,
	input         WCLK,
	input         WCLKE `ICE40_DEFAULT_ASSIGNMENT_1,
	input         WE `ICE40_DEFAULT_ASSIGNMENT_0,
	input  [10:0] WADDR,
	input  [15:0] MASK `ICE40_DEFAULT_ASSIGNMENT_V(16'h 0000),
	input  [15:0] WDATA
);
	// MODE 0:  256 x 16
	// MODE 1:  512 x 8
	// MODE 2: 1024 x 4
	// MODE 3: 2048 x 2
	parameter WRITE_MODE = 0;
	parameter READ_MODE = 0;

	parameter INIT_0 = 256'h0000000000000000000000000000000000000000000000000000000000000000;
	parameter INIT_1 = 256'h0000000000000000000000000000000000000000000000000000000000000000;
	parameter INIT_2 = 256'h0000000000000000000000000000000000000000000000000000000000000000;
	parameter INIT_3 = 256'h0000000000000000000000000000000000000000000000000000000000000000;
	parameter INIT_4 = 256'h0000000000000000000000000000000000000000000000000000000000000000;
	parameter INIT_5 = 256'h0000000000000000000000000000000000000000000000000000000000000000;
	parameter INIT_6 = 256'h0000000000000000000000000000000000000000000000000000000000000000;
	parameter INIT_7 = 256'h0000000000000000000000000000000000000000000000000000000000000000;
	parameter INIT_8 = 256'h0000000000000000000000000000000000000000000000000000000000000000;
	parameter INIT_9 = 256'h0000000000000000000000000000000000000000000000000000000000000000;
	parameter INIT_A = 256'h0000000000000000000000000000000000000000000000000000000000000000;
	parameter INIT_B = 256'h0000000000000000000000000000000000000000000000000000000000000000;
	parameter INIT_C = 256'h0000000000000000000000000000000000000000000000000000000000000000;
	parameter INIT_D = 256'h0000000000000000000000000000000000000000000000000000000000000000;
	parameter INIT_E = 256'h0000000000000000000000000000000000000000000000000000000000000000;
	parameter INIT_F = 256'h0000000000000000000000000000000000000000000000000000000000000000;

	parameter INIT_FILE = "";

`ifndef BLACKBOX
	wire [15:0] WMASK_I;
	wire [15:0] RMASK_I;

	reg  [15:0] RDATA_I;
	wire [15:0] WDATA_I;

	generate
		case (WRITE_MODE)
			0: assign WMASK_I = MASK;

			1: assign WMASK_I = WADDR[   8] == 0 ? 16'b 1010_1010_1010_1010 :
			                    WADDR[   8] == 1 ? 16'b 0101_0101_0101_0101 : 16'bx;

			2: assign WMASK_I = WADDR[ 9:8] == 0 ? 16'b 1110_1110_1110_1110 :
			                    WADDR[ 9:8] == 1 ? 16'b 1101_1101_1101_1101 :
			                    WADDR[ 9:8] == 2 ? 16'b 1011_1011_1011_1011 :
			                    WADDR[ 9:8] == 3 ? 16'b 0111_0111_0111_0111 : 16'bx;

			3: assign WMASK_I = WADDR[10:8] == 0 ? 16'b 1111_1110_1111_1110 :
			                    WADDR[10:8] == 1 ? 16'b 1111_1101_1111_1101 :
			                    WADDR[10:8] == 2 ? 16'b 1111_1011_1111_1011 :
			                    WADDR[10:8] == 3 ? 16'b 1111_0111_1111_0111 :
			                    WADDR[10:8] == 4 ? 16'b 1110_1111_1110_1111 :
			                    WADDR[10:8] == 5 ? 16'b 1101_1111_1101_1111 :
			                    WADDR[10:8] == 6 ? 16'b 1011_1111_1011_1111 :
			                    WADDR[10:8] == 7 ? 16'b 0111_1111_0111_1111 : 16'bx;
		endcase

		case (READ_MODE)
			0: assign RMASK_I = 16'b 0000_0000_0000_0000;

			1: assign RMASK_I = RADDR[   8] == 0 ? 16'b 1010_1010_1010_1010 :
			                    RADDR[   8] == 1 ? 16'b 0101_0101_0101_0101 : 16'bx;

			2: assign RMASK_I = RADDR[ 9:8] == 0 ? 16'b 1110_1110_1110_1110 :
			                    RADDR[ 9:8] == 1 ? 16'b 1101_1101_1101_1101 :
			                    RADDR[ 9:8] == 2 ? 16'b 1011_1011_1011_1011 :
			                    RADDR[ 9:8] == 3 ? 16'b 0111_0111_0111_0111 : 16'bx;

			3: assign RMASK_I = RADDR[10:8] == 0 ? 16'b 1111_1110_1111_1110 :
			                    RADDR[10:8] == 1 ? 16'b 1111_1101_1111_1101 :
			                    RADDR[10:8] == 2 ? 16'b 1111_1011_1111_1011 :
			                    RADDR[10:8] == 3 ? 16'b 1111_0111_1111_0111 :
			                    RADDR[10:8] == 4 ? 16'b 1110_1111_1110_1111 :
			                    RADDR[10:8] == 5 ? 16'b 1101_1111_1101_1111 :
			                    RADDR[10:8] == 6 ? 16'b 1011_1111_1011_1111 :
			                    RADDR[10:8] == 7 ? 16'b 0111_1111_0111_1111 : 16'bx;
		endcase

		case (WRITE_MODE)
			0: assign WDATA_I = WDATA;

			1: assign WDATA_I = {WDATA[14], WDATA[14], WDATA[12], WDATA[12],
			                     WDATA[10], WDATA[10], WDATA[ 8], WDATA[ 8],
			                     WDATA[ 6], WDATA[ 6], WDATA[ 4], WDATA[ 4],
			                     WDATA[ 2], WDATA[ 2], WDATA[ 0], WDATA[ 0]};

			2: assign WDATA_I = {WDATA[13], WDATA[13], WDATA[13], WDATA[13],
			                     WDATA[ 9], WDATA[ 9], WDATA[ 9], WDATA[ 9],
			                     WDATA[ 5], WDATA[ 5], WDATA[ 5], WDATA[ 5],
			                     WDATA[ 1], WDATA[ 1], WDATA[ 1], WDATA[ 1]};

			3: assign WDATA_I = {WDATA[11], WDATA[11], WDATA[11], WDATA[11],
			                     WDATA[11], WDATA[11], WDATA[11], WDATA[11],
			                     WDATA[ 3], WDATA[ 3], WDATA[ 3], WDATA[ 3],
			                     WDATA[ 3], WDATA[ 3], WDATA[ 3], WDATA[ 3]};
		endcase

		case (READ_MODE)
			0: assign RDATA = RDATA_I;
			1: assign RDATA = {1'b0, |RDATA_I[15:14], 1'b0, |RDATA_I[13:12], 1'b0, |RDATA_I[11:10], 1'b0, |RDATA_I[ 9: 8],
			                   1'b0, |RDATA_I[ 7: 6], 1'b0, |RDATA_I[ 5: 4], 1'b0, |RDATA_I[ 3: 2], 1'b0, |RDATA_I[ 1: 0]};
			2: assign RDATA = {2'b0, |RDATA_I[15:12], 3'b0, |RDATA_I[11: 8], 3'b0, |RDATA_I[ 7: 4], 3'b0, |RDATA_I[ 3: 0], 1'b0};
			3: assign RDATA = {4'b0, |RDATA_I[15: 8], 7'b0, |RDATA_I[ 7: 0], 3'b0};
		endcase
	endgenerate

	integer i;
	reg [15:0] memory [0:255];

	initial begin
		if (INIT_FILE != "")
			$readmemh(INIT_FILE, memory);
		else
			for (i=0; i<16; i=i+1) begin
				memory[ 0*16 + i] = INIT_0[16*i +: 16];
				memory[ 1*16 + i] = INIT_1[16*i +: 16];
				memory[ 2*16 + i] = INIT_2[16*i +: 16];
				memory[ 3*16 + i] = INIT_3[16*i +: 16];
				memory[ 4*16 + i] = INIT_4[16*i +: 16];
				memory[ 5*16 + i] = INIT_5[16*i +: 16];
				memory[ 6*16 + i] = INIT_6[16*i +: 16];
				memory[ 7*16 + i] = INIT_7[16*i +: 16];
				memory[ 8*16 + i] = INIT_8[16*i +: 16];
				memory[ 9*16 + i] = INIT_9[16*i +: 16];
				memory[10*16 + i] = INIT_A[16*i +: 16];
				memory[11*16 + i] = INIT_B[16*i +: 16];
				memory[12*16 + i] = INIT_C[16*i +: 16];
				memory[13*16 + i] = INIT_D[16*i +: 16];
				memory[14*16 + i] = INIT_E[16*i +: 16];
				memory[15*16 + i] = INIT_F[16*i +: 16];
			end
	end

	always @(posedge WCLK) begin
		if (WE && WCLKE) begin
			if (!WMASK_I[ 0]) memory[WADDR[7:0]][ 0] <= WDATA_I[ 0];
			if (!WMASK_I[ 1]) memory[WADDR[7:0]][ 1] <= WDATA_I[ 1];
			if (!WMASK_I[ 2]) memory[WADDR[7:0]][ 2] <= WDATA_I[ 2];
			if (!WMASK_I[ 3]) memory[WADDR[7:0]][ 3] <= WDATA_I[ 3];
			if (!WMASK_I[ 4]) memory[WADDR[7:0]][ 4] <= WDATA_I[ 4];
			if (!WMASK_I[ 5]) memory[WADDR[7:0]][ 5] <= WDATA_I[ 5];
			if (!WMASK_I[ 6]) memory[WADDR[7:0]][ 6] <= WDATA_I[ 6];
			if (!WMASK_I[ 7]) memory[WADDR[7:0]][ 7] <= WDATA_I[ 7];
			if (!WMASK_I[ 8]) memory[WADDR[7:0]][ 8] <= WDATA_I[ 8];
			if (!WMASK_I[ 9]) memory[WADDR[7:0]][ 9] <= WDATA_I[ 9];
			if (!WMASK_I[10]) memory[WADDR[7:0]][10] <= WDATA_I[10];
			if (!WMASK_I[11]) memory[WADDR[7:0]][11] <= WDATA_I[11];
			if (!WMASK_I[12]) memory[WADDR[7:0]][12] <= WDATA_I[12];
			if (!WMASK_I[13]) memory[WADDR[7:0]][13] <= WDATA_I[13];
			if (!WMASK_I[14]) memory[WADDR[7:0]][14] <= WDATA_I[14];
			if (!WMASK_I[15]) memory[WADDR[7:0]][15] <= WDATA_I[15];
		end
	end

	always @(posedge RCLK) begin
		if (RE && RCLKE) begin
			RDATA_I <= memory[RADDR[7:0]] & ~RMASK_I;
		end
	end
`endif
`ifdef ICE40_HX
	specify
		// https://github.com/YosysHQ/icestorm/blob/95949315364f8d9b0c693386aefadf44b28e2cf6/icefuzz/timings_hx1k.txt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
		$setup(MASK, posedge WCLK &&& WE && WCLKE, 274);
		// https://github.com/YosysHQ/icestorm/blob/95949315364f8d9b0c693386aefadf44b28e2cf6/icefuzz/timings_hx1k.txt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
		$setup(RADDR, posedge RCLK &&& RE && RCLKE, 203);
		// https://github.com/YosysHQ/icestorm/blob/95949315364f8d9b0c693386aefadf44b28e2cf6/icefuzz/timings_hx1k.txt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
		$setup(RCLKE, posedge RCLK, 267);
		// https://github.com/YosysHQ/icestorm/blob/95949315364f8d9b0c693386aefadf44b28e2cf6/icefuzz/timings_hx1k.txt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
		$setup(RE, posedge RCLK, 98);
		// https://github.com/YosysHQ/icestorm/blob/95949315364f8d9b0c693386aefadf44b28e2cf6/icefuzz/timings_hx1k.txt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
		$setup(WADDR, posedge WCLK &&& WE && WCLKE, 224);
		// https://github.com/YosysHQ/icestorm/blob/95949315364f8d9b0c693386aefadf44b28e2cf6/icefuzz/timings_hx1k.txt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
		$setup(WCLKE, posedge WCLK, 267);
		// https://github.com/YosysHQ/icestorm/blob/95949315364f8d9b0c693386aefadf44b28e2cf6/icefuzz/timings_hx1k.txt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
		$setup(WDATA, posedge WCLK &&& WE && WCLKE, 161);
		// https://github.com/YosysHQ/icestorm/blob/95949315364f8d9b0c693386aefadf44b28e2cf6/icefuzz/timings_hx1k.txt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
		$setup(WE, posedge WCLK, 133);
		// https://github.com/YosysHQ/icestorm/blob/95949315364f8d9b0c693386aefadf44b28e2cf6/icefuzz/timings_hx1k.txt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
		(posedge RCLK *> (RDATA : 16'bx)) = 2146;
	endspecify
`endif
`ifdef ICE40_LP
	specify
		// https://github.com/YosysHQ/icestorm/blob/95949315364f8d9b0c693386aefadf44b28e2cf6/icefuzz/timings_lp1k.txt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
		$setup(MASK, posedge WCLK &&& WE && WCLKE, 403);
		// https://github.com/YosysHQ/icestorm/blob/95949315364f8d9b0c693386aefadf44b28e2cf6/icefuzz/timings_lp1k.txt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
		$setup(RADDR, posedge RCLK &&& RE && RCLKE, 300);
		// https://github.com/YosysHQ/icestorm/blob/95949315364f8d9b0c693386aefadf44b28e2cf6/icefuzz/timings_lp1k.txt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
		$setup(RCLKE, posedge RCLK, 393);
		// https://github.com/YosysHQ/icestorm/blob/95949315364f8d9b0c693386aefadf44b28e2cf6/icefuzz/timings_lp1k.txt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
		$setup(RE, posedge RCLK, 145);
		// https://github.com/YosysHQ/icestorm/blob/95949315364f8d9b0c693386aefadf44b28e2cf6/icefuzz/timings_lp1k.txt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
		$setup(WADDR, posedge WCLK &&& WE && WCLKE, 331);
		// https://github.com/YosysHQ/icestorm/blob/95949315364f8d9b0c693386aefadf44b28e2cf6/icefuzz/timings_lp1k.txt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
		$setup(WCLKE, posedge WCLK, 393);
		// https://github.com/YosysHQ/icestorm/blob/95949315364f8d9b0c693386aefadf44b28e2cf6/icefuzz/timings_lp1k.txt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
		$setup(WDATA, posedge WCLK &&& WE && WCLKE, 238);
		// https://github.com/YosysHQ/icestorm/blob/95949315364f8d9b0c693386aefadf44b28e2cf6/icefuzz/timings_lp1k.txt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
		$setup(WE, posedge WCLK, 196);
		// https://github.com/YosysHQ/icestorm/blob/95949315364f8d9b0c693386aefadf44b28e2cf6/icefuzz/timings_lp1k.txt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
		(posedge RCLK *> (RDATA : 16'bx)) = 3163;
	endspecify
`endif
`ifdef ICE40_U
	specify
		// https://github.com/YosysHQ/icestorm/blob/95949315364f8d9b0c693386aefadf44b28e2cf6/icefuzz/timings_up5k.txt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
		$setup(MASK, posedge WCLK &&& WE && WCLKE, 517);
		// https://github.com/YosysHQ/icestorm/blob/95949315364f8d9b0c693386aefadf44b28e2cf6/icefuzz/timings_up5k.txt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
		$setup(RADDR, posedge RCLK &&& RE && RCLKE, 384);
		// https://github.com/YosysHQ/icestorm/blob/95949315364f8d9b0c693386aefadf44b28e2cf6/icefuzz/timings_up5k.txt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
		$setup(RCLKE, posedge RCLK, 503);
		// https://github.com/YosysHQ/icestorm/blob/95949315364f8d9b0c693386aefadf44b28e2cf6/icefuzz/timings_up5k.txt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
		$setup(RE, posedge RCLK, 185);
		// https://github.com/YosysHQ/icestorm/blob/95949315364f8d9b0c693386aefadf44b28e2cf6/icefuzz/timings_up5k.txt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
		$setup(WADDR, posedge WCLK &&& WE && WCLKE, 424);
		// https://github.com/YosysHQ/icestorm/blob/95949315364f8d9b0c693386aefadf44b28e2cf6/icefuzz/timings_up5k.txt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
		$setup(WCLKE, posedge WCLK, 503);
		// https://github.com/YosysHQ/icestorm/blob/95949315364f8d9b0c693386aefadf44b28e2cf6/icefuzz/timings_up5k.txt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
		$setup(WDATA, posedge WCLK &&& WE && WCLKE, 305);
		// https://github.com/YosysHQ/icestorm/blob/95949315364f8d9b0c693386aefadf44b28e2cf6/icefuzz/timings_up5k.txt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
		$setup(WE, posedge WCLK, 252);
		// https://github.com/YosysHQ/icestorm/blob/95949315364f8d9b0c693386aefadf44b28e2cf6/icefuzz/timings_up5k.txt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
		(posedge RCLK *> (RDATA : 16'bx)) = 1179;
	endspecify
`endif
endmodule

module SB_RAM40_4KNR (
	output [15:0] RDATA,
	input         RCLKN,
	input         RCLKE `ICE40_DEFAULT_ASSIGNMENT_1,
	input         RE `ICE40_DEFAULT_ASSIGNMENT_0,
	input  [10:0] RADDR,
	input         WCLK,
	input         WCLKE `ICE40_DEFAULT_ASSIGNMENT_1,
	input         WE `ICE40_DEFAULT_ASSIGNMENT_0,
	input  [10:0] WADDR,
	input  [15:0] MASK `ICE40_DEFAULT_ASSIGNMENT_V(16'h 0000),
	input  [15:0] WDATA
);
	parameter WRITE_MODE = 0;
	parameter READ_MODE = 0;

	parameter INIT_0 = 256'h0000000000000000000000000000000000000000000000000000000000000000;
	parameter INIT_1 = 256'h0000000000000000000000000000000000000000000000000000000000000000;
	parameter INIT_2 = 256'h0000000000000000000000000000000000000000000000000000000000000000;
	parameter INIT_3 = 256'h0000000000000000000000000000000000000000000000000000000000000000;
	parameter INIT_4 = 256'h0000000000000000000000000000000000000000000000000000000000000000;
	parameter INIT_5 = 256'h0000000000000000000000000000000000000000000000000000000000000000;
	parameter INIT_6 = 256'h0000000000000000000000000000000000000000000000000000000000000000;
	parameter INIT_7 = 256'h0000000000000000000000000000000000000000000000000000000000000000;
	parameter INIT_8 = 256'h0000000000000000000000000000000000000000000000000000000000000000;
	parameter INIT_9 = 256'h0000000000000000000000000000000000000000000000000000000000000000;
	parameter INIT_A = 256'h0000000000000000000000000000000000000000000000000000000000000000;
	parameter INIT_B = 256'h0000000000000000000000000000000000000000000000000000000000000000;
	parameter INIT_C = 256'h0000000000000000000000000000000000000000000000000000000000000000;
	parameter INIT_D = 256'h0000000000000000000000000000000000000000000000000000000000000000;
	parameter INIT_E = 256'h0000000000000000000000000000000000000000000000000000000000000000;
	parameter INIT_F = 256'h0000000000000000000000000000000000000000000000000000000000000000;

	parameter INIT_FILE = "";

	SB_RAM40_4K #(
		.WRITE_MODE(WRITE_MODE),
		.READ_MODE (READ_MODE ),
		.INIT_0    (INIT_0    ),
		.INIT_1    (INIT_1    ),
		.INIT_2    (INIT_2    ),
		.INIT_3    (INIT_3    ),
		.INIT_4    (INIT_4    ),
		.INIT_5    (INIT_5    ),
		.INIT_6    (INIT_6    ),
		.INIT_7    (INIT_7    ),
		.INIT_8    (INIT_8    ),
		.INIT_9    (INIT_9    ),
		.INIT_A    (INIT_A    ),
		.INIT_B    (INIT_B    ),
		.INIT_C    (INIT_C    ),
		.INIT_D    (INIT_D    ),
		.INIT_E    (INIT_E    ),
		.INIT_F    (INIT_F    ),
		.INIT_FILE (INIT_FILE )
	) RAM (
		.RDATA(RDATA),
		.RCLK (~RCLKN),
		.RCLKE(RCLKE),
		.RE   (RE   ),
		.RADDR(RADDR),
		.WCLK (WCLK ),
		.WCLKE(WCLKE),
		.WE   (WE   ),
		.WADDR(WADDR),
		.MASK (MASK ),
		.WDATA(WDATA)
	);
`ifdef ICE40_HX
	specify
		// https://github.com/YosysHQ/icestorm/blob/95949315364f8d9b0c693386aefadf44b28e2cf6/icefuzz/timings_hx1k.txt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
		$setup(MASK, posedge WCLK &&& WE && WCLKE, 274);
		// https://github.com/YosysHQ/icestorm/blob/95949315364f8d9b0c693386aefadf44b28e2cf6/icefuzz/timings_hx1k.txt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
		$setup(RADDR, posedge RCLKN &&& RE && RCLKE, 203);
		// https://github.com/YosysHQ/icestorm/blob/95949315364f8d9b0c693386aefadf44b28e2cf6/icefuzz/timings_hx1k.txt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
		$setup(RCLKE, posedge RCLKN, 267);
		// https://github.com/YosysHQ/icestorm/blob/95949315364f8d9b0c693386aefadf44b28e2cf6/icefuzz/timings_hx1k.txt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
		$setup(RE, posedge RCLKN, 98);
		// https://github.com/YosysHQ/icestorm/blob/95949315364f8d9b0c693386aefadf44b28e2cf6/icefuzz/timings_hx1k.txt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
		$setup(WADDR, posedge WCLK &&& WE && WCLKE, 224);
		// https://github.com/YosysHQ/icestorm/blob/95949315364f8d9b0c693386aefadf44b28e2cf6/icefuzz/timings_hx1k.txt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
		$setup(WCLKE, posedge WCLK, 267);
		// https://github.com/YosysHQ/icestorm/blob/95949315364f8d9b0c693386aefadf44b28e2cf6/icefuzz/timings_hx1k.txt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
		$setup(WDATA, posedge WCLK &&& WE && WCLKE, 161);
		// https://github.com/YosysHQ/icestorm/blob/95949315364f8d9b0c693386aefadf44b28e2cf6/icefuzz/timings_hx1k.txt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
		$setup(WE, posedge WCLK, 133);
		// https://github.com/YosysHQ/icestorm/blob/95949315364f8d9b0c693386aefadf44b28e2cf6/icefuzz/timings_hx1k.txt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
		(posedge RCLKN *> (RDATA : 16'bx)) = 2146;
	endspecify
`endif
`ifdef ICE40_LP
	specify
		// https://github.com/YosysHQ/icestorm/blob/95949315364f8d9b0c693386aefadf44b28e2cf6/icefuzz/timings_lp1k.txt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
		$setup(MASK, posedge WCLK &&& WE && WCLKE, 403);
		// https://github.com/YosysHQ/icestorm/blob/95949315364f8d9b0c693386aefadf44b28e2cf6/icefuzz/timings_lp1k.txt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
		$setup(RADDR, posedge RCLKN &&& RE && RCLKE, 300);
		// https://github.com/YosysHQ/icestorm/blob/95949315364f8d9b0c693386aefadf44b28e2cf6/icefuzz/timings_lp1k.txt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
		$setup(RCLKE, posedge RCLKN, 393);
		// https://github.com/YosysHQ/icestorm/blob/95949315364f8d9b0c693386aefadf44b28e2cf6/icefuzz/timings_lp1k.txt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
		$setup(RE, posedge RCLKN, 145);
		// https://github.com/YosysHQ/icestorm/blob/95949315364f8d9b0c693386aefadf44b28e2cf6/icefuzz/timings_lp1k.txt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
		$setup(WADDR, posedge WCLK &&& WE && WCLKE, 331);
		// https://github.com/YosysHQ/icestorm/blob/95949315364f8d9b0c693386aefadf44b28e2cf6/icefuzz/timings_lp1k.txt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
		$setup(WCLKE, posedge WCLK, 393);
		// https://github.com/YosysHQ/icestorm/blob/95949315364f8d9b0c693386aefadf44b28e2cf6/icefuzz/timings_lp1k.txt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
		$setup(WDATA, posedge WCLK &&& WE && WCLKE, 238);
		// https://github.com/YosysHQ/icestorm/blob/95949315364f8d9b0c693386aefadf44b28e2cf6/icefuzz/timings_lp1k.txt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
		$setup(WE, posedge WCLK, 196);
		// https://github.com/YosysHQ/icestorm/blob/95949315364f8d9b0c693386aefadf44b28e2cf6/icefuzz/timings_lp1k.txt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
		(posedge RCLKN *> (RDATA : 16'bx)) = 3163;
	endspecify
`endif
`ifdef ICE40_U
	specify
		// https://github.com/YosysHQ/icestorm/blob/95949315364f8d9b0c693386aefadf44b28e2cf6/icefuzz/timings_up5k.txt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
		$setup(MASK, posedge WCLK &&& WE && WCLKE, 517);
		// https://github.com/YosysHQ/icestorm/blob/95949315364f8d9b0c693386aefadf44b28e2cf6/icefuzz/timings_up5k.txt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
		$setup(RADDR, posedge RCLKN &&& RE && RCLKE, 384);
		// https://github.com/YosysHQ/icestorm/blob/95949315364f8d9b0c693386aefadf44b28e2cf6/icefuzz/timings_up5k.txt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
		$setup(RCLKE, posedge RCLKN, 503);
		// https://github.com/YosysHQ/icestorm/blob/95949315364f8d9b0c693386aefadf44b28e2cf6/icefuzz/timings_up5k.txt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
		$setup(RE, posedge RCLKN, 185);
		// https://github.com/YosysHQ/icestorm/blob/95949315364f8d9b0c693386aefadf44b28e2cf6/icefuzz/timings_up5k.txt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
		$setup(WADDR, posedge WCLK &&& WE && WCLKE, 424);
		// https://github.com/YosysHQ/icestorm/blob/95949315364f8d9b0c693386aefadf44b28e2cf6/icefuzz/timings_up5k.txt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
		$setup(WCLKE, posedge WCLK, 503);
		// https://github.com/YosysHQ/icestorm/blob/95949315364f8d9b0c693386aefadf44b28e2cf6/icefuzz/timings_up5k.txt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
		$setup(WDATA, posedge WCLK &&& WE && WCLKE, 305);
		// https://github.com/YosysHQ/icestorm/blob/95949315364f8d9b0c693386aefadf44b28e2cf6/icefuzz/timings_up5k.txt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
		$setup(WE, posedge WCLK, 252);
		// https://github.com/YosysHQ/icestorm/blob/95949315364f8d9b0c693386aefadf44b28e2cf6/icefuzz/timings_up5k.txt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
		(posedge RCLKN *> (RDATA : 16'bx)) = 1179;
	endspecify
`endif
endmodule

module SB_RAM40_4KNW (
	output [15:0] RDATA,
	input         RCLK,
	input         RCLKE `ICE40_DEFAULT_ASSIGNMENT_1,
	input         RE `ICE40_DEFAULT_ASSIGNMENT_0,
	input  [10:0] RADDR,
	input         WCLKN,
	input         WCLKE `ICE40_DEFAULT_ASSIGNMENT_1,
	input         WE `ICE40_DEFAULT_ASSIGNMENT_0,
	input  [10:0] WADDR,
	input  [15:0] MASK `ICE40_DEFAULT_ASSIGNMENT_V(16'h 0000),
	input  [15:0] WDATA
);
	parameter WRITE_MODE = 0;
	parameter READ_MODE = 0;

	parameter INIT_0 = 256'h0000000000000000000000000000000000000000000000000000000000000000;
	parameter INIT_1 = 256'h0000000000000000000000000000000000000000000000000000000000000000;
	parameter INIT_2 = 256'h0000000000000000000000000000000000000000000000000000000000000000;
	parameter INIT_3 = 256'h0000000000000000000000000000000000000000000000000000000000000000;
	parameter INIT_4 = 256'h0000000000000000000000000000000000000000000000000000000000000000;
	parameter INIT_5 = 256'h0000000000000000000000000000000000000000000000000000000000000000;
	parameter INIT_6 = 256'h0000000000000000000000000000000000000000000000000000000000000000;
	parameter INIT_7 = 256'h0000000000000000000000000000000000000000000000000000000000000000;
	parameter INIT_8 = 256'h0000000000000000000000000000000000000000000000000000000000000000;
	parameter INIT_9 = 256'h0000000000000000000000000000000000000000000000000000000000000000;
	parameter INIT_A = 256'h0000000000000000000000000000000000000000000000000000000000000000;
	parameter INIT_B = 256'h0000000000000000000000000000000000000000000000000000000000000000;
	parameter INIT_C = 256'h0000000000000000000000000000000000000000000000000000000000000000;
	parameter INIT_D = 256'h0000000000000000000000000000000000000000000000000000000000000000;
	parameter INIT_E = 256'h0000000000000000000000000000000000000000000000000000000000000000;
	parameter INIT_F = 256'h0000000000000000000000000000000000000000000000000000000000000000;

	parameter INIT_FILE = "";

	SB_RAM40_4K #(
		.WRITE_MODE(WRITE_MODE),
		.READ_MODE (READ_MODE ),
		.INIT_0    (INIT_0    ),
		.INIT_1    (INIT_1    ),
		.INIT_2    (INIT_2    ),
		.INIT_3    (INIT_3    ),
		.INIT_4    (INIT_4    ),
		.INIT_5    (INIT_5    ),
		.INIT_6    (INIT_6    ),
		.INIT_7    (INIT_7    ),
		.INIT_8    (INIT_8    ),
		.INIT_9    (INIT_9    ),
		.INIT_A    (INIT_A    ),
		.INIT_B    (INIT_B    ),
		.INIT_C    (INIT_C    ),
		.INIT_D    (INIT_D    ),
		.INIT_E    (INIT_E    ),
		.INIT_F    (INIT_F    ),
		.INIT_FILE (INIT_FILE )
	) RAM (
		.RDATA(RDATA),
		.RCLK (RCLK ),
		.RCLKE(RCLKE),
		.RE   (RE   ),
		.RADDR(RADDR),
		.WCLK (~WCLKN),
		.WCLKE(WCLKE),
		.WE   (WE   ),
		.WADDR(WADDR),
		.MASK (MASK ),
		.WDATA(WDATA)
	);
`ifdef ICE40_HX
	specify
		// https://github.com/YosysHQ/icestorm/blob/95949315364f8d9b0c693386aefadf44b28e2cf6/icefuzz/timings_hx1k.txt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
		$setup(MASK, posedge WCLKN &&& WE && WCLKE, 274);
		// https://github.com/YosysHQ/icestorm/blob/95949315364f8d9b0c693386aefadf44b28e2cf6/icefuzz/timings_hx1k.txt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
		$setup(RADDR, posedge RCLK &&& RE && RCLKE, 203);
		// https://github.com/YosysHQ/icestorm/blob/95949315364f8d9b0c693386aefadf44b28e2cf6/icefuzz/timings_hx1k.txt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
		$setup(RCLKE, posedge RCLK, 267);
		// https://github.com/YosysHQ/icestorm/blob/95949315364f8d9b0c693386aefadf44b28e2cf6/icefuzz/timings_hx1k.txt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
		$setup(RE, posedge RCLK, 98);
		// https://github.com/YosysHQ/icestorm/blob/95949315364f8d9b0c693386aefadf44b28e2cf6/icefuzz/timings_hx1k.txt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
		$setup(WADDR, posedge WCLKN &&& WE && WCLKE, 224);
		// https://github.com/YosysHQ/icestorm/blob/95949315364f8d9b0c693386aefadf44b28e2cf6/icefuzz/timings_hx1k.txt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
		$setup(WCLKE, posedge WCLKN, 267);
		// https://github.com/YosysHQ/icestorm/blob/95949315364f8d9b0c693386aefadf44b28e2cf6/icefuzz/timings_hx1k.txt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
		$setup(WDATA, posedge WCLKN &&& WE && WCLKE, 161);
		// https://github.com/YosysHQ/icestorm/blob/95949315364f8d9b0c693386aefadf44b28e2cf6/icefuzz/timings_hx1k.txt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
		$setup(WE, posedge WCLKN, 133);
		// https://github.com/YosysHQ/icestorm/blob/95949315364f8d9b0c693386aefadf44b28e2cf6/icefuzz/timings_hx1k.txt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
		(posedge RCLK *> (RDATA : 16'bx)) = 2146;
	endspecify
`endif
`ifdef ICE40_LP
	specify
		// https://github.com/YosysHQ/icestorm/blob/95949315364f8d9b0c693386aefadf44b28e2cf6/icefuzz/timings_lp1k.txt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
		$setup(MASK, posedge WCLKN &&& WE && WCLKE, 403);
		// https://github.com/YosysHQ/icestorm/blob/95949315364f8d9b0c693386aefadf44b28e2cf6/icefuzz/timings_lp1k.txt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
		$setup(RADDR, posedge RCLK &&& RE && RCLKE, 300);
		// https://github.com/YosysHQ/icestorm/blob/95949315364f8d9b0c693386aefadf44b28e2cf6/icefuzz/timings_lp1k.txt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
		$setup(RCLKE, posedge RCLK, 393);
		// https://github.com/YosysHQ/icestorm/blob/95949315364f8d9b0c693386aefadf44b28e2cf6/icefuzz/timings_lp1k.txt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
		$setup(RE, posedge RCLK, 145);
		// https://github.com/YosysHQ/icestorm/blob/95949315364f8d9b0c693386aefadf44b28e2cf6/icefuzz/timings_lp1k.txt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
		$setup(WADDR, posedge WCLKN &&& WE && WCLKE, 331);
		// https://github.com/YosysHQ/icestorm/blob/95949315364f8d9b0c693386aefadf44b28e2cf6/icefuzz/timings_lp1k.txt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
		$setup(WCLKE, posedge WCLKN, 393);
		// https://github.com/YosysHQ/icestorm/blob/95949315364f8d9b0c693386aefadf44b28e2cf6/icefuzz/timings_lp1k.txt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
		$setup(WDATA, posedge WCLKN &&& WE && WCLKE, 238);
		// https://github.com/YosysHQ/icestorm/blob/95949315364f8d9b0c693386aefadf44b28e2cf6/icefuzz/timings_lp1k.txt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
		$setup(WE, posedge WCLKN, 196);
		// https://github.com/YosysHQ/icestorm/blob/95949315364f8d9b0c693386aefadf44b28e2cf6/icefuzz/timings_lp1k.txt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
		(posedge RCLK *> (RDATA : 16'bx)) = 3163;
	endspecify
`endif
`ifdef ICE40_U
	specify
		// https://github.com/YosysHQ/icestorm/blob/95949315364f8d9b0c693386aefadf44b28e2cf6/icefuzz/timings_up5k.txt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
		$setup(MASK, posedge WCLKN &&& WE && WCLKE, 517);
		// https://github.com/YosysHQ/icestorm/blob/95949315364f8d9b0c693386aefadf44b28e2cf6/icefuzz/timings_up5k.txt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
		$setup(RADDR, posedge RCLK &&& RE && RCLKE, 384);
		// https://github.com/YosysHQ/icestorm/blob/95949315364f8d9b0c693386aefadf44b28e2cf6/icefuzz/timings_up5k.txt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
		$setup(RCLKE, posedge RCLK, 503);
		// https://github.com/YosysHQ/icestorm/blob/95949315364f8d9b0c693386aefadf44b28e2cf6/icefuzz/timings_up5k.txt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
		$setup(RE, posedge RCLK, 185);
		// https://github.com/YosysHQ/icestorm/blob/95949315364f8d9b0c693386aefadf44b28e2cf6/icefuzz/timings_up5k.txt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
		$setup(WADDR, posedge WCLKN &&& WE && WCLKE, 424);
		// https://github.com/YosysHQ/icestorm/blob/95949315364f8d9b0c693386aefadf44b28e2cf6/icefuzz/timings_up5k.txt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
		$setup(WCLKE, posedge WCLKN, 503);
		// https://github.com/YosysHQ/icestorm/blob/95949315364f8d9b0c693386aefadf44b28e2cf6/icefuzz/timings_up5k.txt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
		$setup(WDATA, posedge WCLKN &&& WE && WCLKE, 305);
		// https://github.com/YosysHQ/icestorm/blob/95949315364f8d9b0c693386aefadf44b28e2cf6/icefuzz/timings_up5k.txt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
		$setup(WE, posedge WCLKN, 252);
		// https://github.com/YosysHQ/icestorm/blob/95949315364f8d9b0c693386aefadf44b28e2cf6/icefuzz/timings_up5k.txt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
		(posedge RCLK *> (RDATA : 16'bx)) = 1179;
	endspecify
`endif
endmodule

module SB_RAM40_4KNRNW (
	output [15:0] RDATA,
	input         RCLKN,
	input         RCLKE `ICE40_DEFAULT_ASSIGNMENT_1,
	input         RE `ICE40_DEFAULT_ASSIGNMENT_0,
	input  [10:0] RADDR,
	input         WCLKN,
	input         WCLKE `ICE40_DEFAULT_ASSIGNMENT_1,
	input         WE `ICE40_DEFAULT_ASSIGNMENT_0,
	input  [10:0] WADDR,
	input  [15:0] MASK `ICE40_DEFAULT_ASSIGNMENT_V(16'h 0000),
	input  [15:0] WDATA
);
	parameter WRITE_MODE = 0;
	parameter READ_MODE = 0;

	parameter INIT_0 = 256'h0000000000000000000000000000000000000000000000000000000000000000;
	parameter INIT_1 = 256'h0000000000000000000000000000000000000000000000000000000000000000;
	parameter INIT_2 = 256'h0000000000000000000000000000000000000000000000000000000000000000;
	parameter INIT_3 = 256'h0000000000000000000000000000000000000000000000000000000000000000;
	parameter INIT_4 = 256'h0000000000000000000000000000000000000000000000000000000000000000;
	parameter INIT_5 = 256'h0000000000000000000000000000000000000000000000000000000000000000;
	parameter INIT_6 = 256'h0000000000000000000000000000000000000000000000000000000000000000;
	parameter INIT_7 = 256'h0000000000000000000000000000000000000000000000000000000000000000;
	parameter INIT_8 = 256'h0000000000000000000000000000000000000000000000000000000000000000;
	parameter INIT_9 = 256'h0000000000000000000000000000000000000000000000000000000000000000;
	parameter INIT_A = 256'h0000000000000000000000000000000000000000000000000000000000000000;
	parameter INIT_B = 256'h0000000000000000000000000000000000000000000000000000000000000000;
	parameter INIT_C = 256'h0000000000000000000000000000000000000000000000000000000000000000;
	parameter INIT_D = 256'h0000000000000000000000000000000000000000000000000000000000000000;
	parameter INIT_E = 256'h0000000000000000000000000000000000000000000000000000000000000000;
	parameter INIT_F = 256'h0000000000000000000000000000000000000000000000000000000000000000;

	parameter INIT_FILE = "";

	SB_RAM40_4K #(
		.WRITE_MODE(WRITE_MODE),
		.READ_MODE (READ_MODE ),
		.INIT_0    (INIT_0    ),
		.INIT_1    (INIT_1    ),
		.INIT_2    (INIT_2    ),
		.INIT_3    (INIT_3    ),
		.INIT_4    (INIT_4    ),
		.INIT_5    (INIT_5    ),
		.INIT_6    (INIT_6    ),
		.INIT_7    (INIT_7    ),
		.INIT_8    (INIT_8    ),
		.INIT_9    (INIT_9    ),
		.INIT_A    (INIT_A    ),
		.INIT_B    (INIT_B    ),
		.INIT_C    (INIT_C    ),
		.INIT_D    (INIT_D    ),
		.INIT_E    (INIT_E    ),
		.INIT_F    (INIT_F    ),
		.INIT_FILE (INIT_FILE )
	) RAM (
		.RDATA(RDATA),
		.RCLK (~RCLKN),
		.RCLKE(RCLKE),
		.RE   (RE   ),
		.RADDR(RADDR),
		.WCLK (~WCLKN),
		.WCLKE(WCLKE),
		.WE   (WE   ),
		.WADDR(WADDR),
		.MASK (MASK ),
		.WDATA(WDATA)
	);
`ifdef ICE40_HX
	specify
		// https://github.com/YosysHQ/icestorm/blob/95949315364f8d9b0c693386aefadf44b28e2cf6/icefuzz/timings_hx1k.txt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
		$setup(MASK, posedge WCLKN &&& WE && WCLKE, 274);
		// https://github.com/YosysHQ/icestorm/blob/95949315364f8d9b0c693386aefadf44b28e2cf6/icefuzz/timings_hx1k.txt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
		$setup(RADDR, posedge RCLKN &&& RE && RCLKE, 203);
		// https://github.com/YosysHQ/icestorm/blob/95949315364f8d9b0c693386aefadf44b28e2cf6/icefuzz/timings_hx1k.txt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
		$setup(RCLKE, posedge RCLKN, 267);
		// https://github.com/YosysHQ/icestorm/blob/95949315364f8d9b0c693386aefadf44b28e2cf6/icefuzz/timings_hx1k.txt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
		$setup(RE, posedge RCLKN, 98);
		// https://github.com/YosysHQ/icestorm/blob/95949315364f8d9b0c693386aefadf44b28e2cf6/icefuzz/timings_hx1k.txt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
		$setup(WADDR, posedge WCLKN &&& WE && WCLKE, 224);
		// https://github.com/YosysHQ/icestorm/blob/95949315364f8d9b0c693386aefadf44b28e2cf6/icefuzz/timings_hx1k.txt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
		$setup(WCLKE, posedge WCLKN, 267);
		// https://github.com/YosysHQ/icestorm/blob/95949315364f8d9b0c693386aefadf44b28e2cf6/icefuzz/timings_hx1k.txt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
		$setup(WDATA, posedge WCLKN &&& WE && WCLKE, 161);
		// https://github.com/YosysHQ/icestorm/blob/95949315364f8d9b0c693386aefadf44b28e2cf6/icefuzz/timings_hx1k.txt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
		$setup(WE, posedge WCLKN, 133);
		// https://github.com/YosysHQ/icestorm/blob/95949315364f8d9b0c693386aefadf44b28e2cf6/icefuzz/timings_hx1k.txt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
		(posedge RCLKN *> (RDATA : 16'bx)) = 2146;
	endspecify
`endif
`ifdef ICE40_LP
	specify
		// https://github.com/YosysHQ/icestorm/blob/95949315364f8d9b0c693386aefadf44b28e2cf6/icefuzz/timings_lp1k.txt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
		$setup(MASK, posedge WCLKN &&& WE && WCLKE, 403);
		// https://github.com/YosysHQ/icestorm/blob/95949315364f8d9b0c693386aefadf44b28e2cf6/icefuzz/timings_lp1k.txt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
		$setup(RADDR, posedge RCLKN &&& RE && RCLKE, 300);
		// https://github.com/YosysHQ/icestorm/blob/95949315364f8d9b0c693386aefadf44b28e2cf6/icefuzz/timings_lp1k.txt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
		$setup(RCLKE, posedge RCLKN, 393);
		// https://github.com/YosysHQ/icestorm/blob/95949315364f8d9b0c693386aefadf44b28e2cf6/icefuzz/timings_lp1k.txt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
		$setup(RE, posedge RCLKN, 145);
		// https://github.com/YosysHQ/icestorm/blob/95949315364f8d9b0c693386aefadf44b28e2cf6/icefuzz/timings_lp1k.txt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
		$setup(WADDR, posedge WCLKN &&& WE && WCLKE, 331);
		// https://github.com/YosysHQ/icestorm/blob/95949315364f8d9b0c693386aefadf44b28e2cf6/icefuzz/timings_lp1k.txt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
		$setup(WCLKE, posedge WCLKN, 393);
		// https://github.com/YosysHQ/icestorm/blob/95949315364f8d9b0c693386aefadf44b28e2cf6/icefuzz/timings_lp1k.txt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
		$setup(WDATA, posedge WCLKN &&& WE && WCLKE, 238);
		// https://github.com/YosysHQ/icestorm/blob/95949315364f8d9b0c693386aefadf44b28e2cf6/icefuzz/timings_lp1k.txt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
		$setup(WE, posedge WCLKN, 196);
		// https://github.com/YosysHQ/icestorm/blob/95949315364f8d9b0c693386aefadf44b28e2cf6/icefuzz/timings_lp1k.txt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
		(posedge RCLKN *> (RDATA : 16'bx)) = 3163;
	endspecify
`endif
`ifdef ICE40_U
	specify
		// https://github.com/YosysHQ/icestorm/blob/95949315364f8d9b0c693386aefadf44b28e2cf6/icefuzz/timings_up5k.txt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
		$setup(MASK, posedge WCLKN &&& WE && WCLKE, 517);
		// https://github.com/YosysHQ/icestorm/blob/95949315364f8d9b0c693386aefadf44b28e2cf6/icefuzz/timings_up5k.txt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
		$setup(RADDR, posedge RCLKN &&& RE && RCLKE, 384);
		// https://github.com/YosysHQ/icestorm/blob/95949315364f8d9b0c693386aefadf44b28e2cf6/icefuzz/timings_up5k.txt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
		$setup(RCLKE, posedge RCLKN, 503);
		// https://github.com/YosysHQ/icestorm/blob/95949315364f8d9b0c693386aefadf44b28e2cf6/icefuzz/timings_up5k.txt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
		$setup(RE, posedge RCLKN, 185);
		// https://github.com/YosysHQ/icestorm/blob/95949315364f8d9b0c693386aefadf44b28e2cf6/icefuzz/timings_up5k.txt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
		$setup(WADDR, posedge WCLKN &&& WE && WCLKE, 424);
		// https://github.com/YosysHQ/icestorm/blob/95949315364f8d9b0c693386aefadf44b28e2cf6/icefuzz/timings_up5k.txt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
		$setup(WCLKE, posedge WCLKN, 503);
		// https://github.com/YosysHQ/icestorm/blob/95949315364f8d9b0c693386aefadf44b28e2cf6/icefuzz/timings_up5k.txt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
		$setup(WDATA, posedge WCLKN &&& WE && WCLKE, 305);
		// https://github.com/YosysHQ/icestorm/blob/95949315364f8d9b0c693386aefadf44b28e2cf6/icefuzz/timings_up5k.txt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
		$setup(WE, posedge WCLKN, 252);
		// https://github.com/YosysHQ/icestorm/blob/95949315364f8d9b0c693386aefadf44b28e2cf6/icefuzz/timings_up5k.txt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
		(posedge RCLKN *> (RDATA : 16'bx)) = 1179;
	endspecify
`endif
endmodule

// Packed IceStorm Logic Cells

module ICESTORM_LC (
	input I0, I1, I2, I3, CIN, CLK, CEN, SR,
	output LO,
	output O,
	output COUT
);
	parameter [15:0] LUT_INIT = 0;

	parameter [0:0] NEG_CLK      = 0;
	parameter [0:0] CARRY_ENABLE = 0;
	parameter [0:0] DFF_ENABLE   = 0;
	parameter [0:0] SET_NORESET  = 0;
	parameter [0:0] ASYNC_SR     = 0;

	parameter [0:0] CIN_CONST    = 0;
	parameter [0:0] CIN_SET      = 0;

	wire I0_pd = (I0 === 1'bz) ? 1'b0 : I0;
	wire I1_pd = (I1 === 1'bz) ? 1'b0 : I1;
	wire I2_pd = (I2 === 1'bz) ? 1'b0 : I2;
	wire I3_pd = (I3 === 1'bz) ? 1'b0 : I3;
	wire SR_pd = (SR === 1'bz) ? 1'b0 : SR;
	wire CEN_pu = (CEN === 1'bz) ? 1'b1 : CEN;

	wire mux_cin = CIN_CONST ? CIN_SET : CIN;

	assign COUT = CARRY_ENABLE ? (I1_pd && I2_pd) || ((I1_pd || I2_pd) && mux_cin) : 1'bx;

	wire [7:0] lut_s3 = I3_pd ? LUT_INIT[15:8] : LUT_INIT[7:0];
	wire [3:0] lut_s2 = I2_pd ?   lut_s3[ 7:4] :   lut_s3[3:0];
	wire [1:0] lut_s1 = I1_pd ?   lut_s2[ 3:2] :   lut_s2[1:0];
	wire       lut_o  = I0_pd ?   lut_s1[   1] :   lut_s1[  0];

	assign LO = lut_o;

	wire polarized_clk;
	assign polarized_clk = CLK ^ NEG_CLK;

	reg o_reg = 1'b0;
	always @(posedge polarized_clk)
		if (CEN_pu)
			o_reg <= SR_pd ? SET_NORESET : lut_o;

	reg o_reg_async = 1'b0;
	always @(posedge polarized_clk, posedge SR_pd)
		if (SR_pd)
			o_reg_async <= SET_NORESET;
		else if (CEN_pu)
			o_reg_async <= lut_o;

	assign O = DFF_ENABLE ? ASYNC_SR ? o_reg_async : o_reg : lut_o;
`ifdef TIMING
specify
	(I0 => O) = (0:0:0, 0:0:0);
	(I1 => O) = (0:0:0, 0:0:0);
	(I2 => O) = (0:0:0, 0:0:0);
	(I3 => O) = (0:0:0, 0:0:0);
	(I0 => LO) = (0:0:0, 0:0:0);
	(I1 => LO) = (0:0:0, 0:0:0);
	(I2 => LO) = (0:0:0, 0:0:0);
	(I3 => LO) = (0:0:0, 0:0:0);
	(I1 => COUT) = (0:0:0, 0:0:0);
	(I2 => COUT) = (0:0:0, 0:0:0);
	(CIN => COUT) = (0:0:0, 0:0:0);
	(CLK => O) = (0:0:0, 0:0:0);
	(SR => O) = (0:0:0, 0:0:0);
	$setuphold(posedge CLK, posedge I0, 0:0:0, 0:0:0);
	$setuphold(posedge CLK, negedge I0, 0:0:0, 0:0:0);
	$setuphold(negedge CLK, posedge I0, 0:0:0, 0:0:0);
	$setuphold(negedge CLK, negedge I0, 0:0:0, 0:0:0);
	$setuphold(posedge CLK, posedge I1, 0:0:0, 0:0:0);
	$setuphold(posedge CLK, negedge I1, 0:0:0, 0:0:0);
	$setuphold(negedge CLK, posedge I1, 0:0:0, 0:0:0);
	$setuphold(negedge CLK, negedge I1, 0:0:0, 0:0:0);
	$setuphold(posedge CLK, posedge I2, 0:0:0, 0:0:0);
	$setuphold(posedge CLK, negedge I2, 0:0:0, 0:0:0);
	$setuphold(negedge CLK, posedge I2, 0:0:0, 0:0:0);
	$setuphold(negedge CLK, negedge I2, 0:0:0, 0:0:0);
	$setuphold(posedge CLK, posedge I3, 0:0:0, 0:0:0);
	$setuphold(posedge CLK, negedge I3, 0:0:0, 0:0:0);
	$setuphold(negedge CLK, posedge I3, 0:0:0, 0:0:0);
	$setuphold(negedge CLK, negedge I3, 0:0:0, 0:0:0);
	$setuphold(posedge CLK, posedge CEN, 0:0:0, 0:0:0);
	$setuphold(posedge CLK, negedge CEN, 0:0:0, 0:0:0);
	$setuphold(negedge CLK, posedge CEN, 0:0:0, 0:0:0);
	$setuphold(negedge CLK, negedge CEN, 0:0:0, 0:0:0);
	$setuphold(posedge CLK, posedge SR, 0:0:0, 0:0:0);
	$setuphold(posedge CLK, negedge SR, 0:0:0, 0:0:0);
	$setuphold(negedge CLK, posedge SR, 0:0:0, 0:0:0);
	$setuphold(negedge CLK, negedge SR, 0:0:0, 0:0:0);
endspecify
`endif
`ifdef ICE40_HX
specify
	// https://github.com/YosysHQ/icestorm/blob/95949315364f8d9b0c693386aefadf44b28e2cf6/icefuzz/timings_hx1k.txt#L79
	(CIN => COUT) = (101:112:126, 85:94:105);
	// https://github.com/YosysHQ/icestorm/blob/95949315364f8d9b0c693386aefadf44b28e2cf6/icefuzz/timings_hx1k.txt#L80
	(I0 => O) = (361:399:449, 310:343:386);
	// https://github.com/YosysHQ/icestorm/blob/95949315364f8d9b0c693386aefadf44b28e2cf6/icefuzz/timings_hx1k.txt#L81
	(I0 => LO) = (293:324:365, 310:343:386);
	// https://github.com/YosysHQ/icestorm/blob/95949315364f8d9b0c693386aefadf44b28e2cf6/icefuzz/timings_hx1k.txt#L82
	(I1 => COUT) = (209:231:259, 197:218:245);
	// https://github.com/YosysHQ/icestorm/blob/95949315364f8d9b0c693386aefadf44b28e2cf6/icefuzz/timings_hx1k.txt#L83
	(I1 => O) = (321:355:400, 304:337:379);
	// https://github.com/YosysHQ/icestorm/blob/95949315364f8d9b0c693386aefadf44b28e2cf6/icefuzz/timings_hx1k.txt#L84
	(I1 => LO) = (259:287:323, 304:337:379);
	// https://github.com/YosysHQ/icestorm/blob/95949315364f8d9b0c693386aefadf44b28e2cf6/icefuzz/timings_hx1k.txt#L85
	(I2 => COUT) = (186:206:231, 107:118:133);
	// https://github.com/YosysHQ/icestorm/blob/95949315364f8d9b0c693386aefadf44b28e2cf6/icefuzz/timings_hx1k.txt#L86
	(I2 => O) = (304:337:379, 282:312:351);
	// https://github.com/YosysHQ/icestorm/blob/95949315364f8d9b0c693386aefadf44b28e2cf6/icefuzz/timings_hx1k.txt#L87
	(I2 => LO) = (254:281:316, 231:256:288);
	// https://github.com/YosysHQ/icestorm/blob/95949315364f8d9b0c693386aefadf44b28e2cf6/icefuzz/timings_hx1k.txt#L88
	(I3 => O) = (254:281:316, 231:256:288);
	// https://github.com/YosysHQ/icestorm/blob/95949315364f8d9b0c693386aefadf44b28e2cf6/icefuzz/timings_hx1k.txt#L89
	(I3 => LO) = (214:237:267, 220:243:274);
	// https://github.com/YosysHQ/icestorm/blob/95949315364f8d9b0c693386aefadf44b28e2cf6/icefuzz/timings_hx1k.txt#L90
	(posedge CLK => (O : 1'bx)) = (434:480:540, 434:480:540);
	// https://github.com/YosysHQ/icestorm/blob/95949315364f8d9b0c693386aefadf44b28e2cf6/icefuzz/timings_hx1k.txt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
	(SR => O) = (482:535:599, 482:533:599);
	// https://github.com/YosysHQ/icestorm/blob/95949315364f8d9b0c693386aefadf44b28e2cf6/icefuzz/timings_hx1k.txt#L74
	$setuphold(posedge CLK, posedge I0, 378:418:470, 0:0:0);
	// https://github.com/YosysHQ/icestorm/blob/95949315364f8d9b0c693386aefadf44b28e2cf6/icefuzz/timings_hx1k.txt#L68
	$setuphold(posedge CLK, negedge I0, 321:355:400, 0:0:0);
	$setuphold(negedge CLK, posedge I0, 378:418:470, 0:0:0);
	$setuphold(negedge CLK, negedge I0, 321:355:400, 0:0:0);
	// https://github.com/YosysHQ/icestorm/blob/95949315364f8d9b0c693386aefadf44b28e2cf6/icefuzz/timings_hx1k.txt#L75
	$setuphold(posedge CLK, posedge I1, 321:355:400, 0:0:0);
	// https://github.com/YosysHQ/icestorm/blob/95949315364f8d9b0c693386aefadf44b28e2cf6/icefuzz/timings_hx1k.txt#L69
	$setuphold(posedge CLK, negedge I1, 304:337:379, 0:0:0);
	$setuphold(negedge CLK, posedge I1, 321:355:400, 0:0:0);
	$setuphold(negedge CLK, negedge I1, 304:337:379, 0:0:0);
	// https://github.com/YosysHQ/icestorm/blob/95949315364f8d9b0c693386aefadf44b28e2cf6/icefuzz/timings_hx1k.txt#L76
	$setuphold(posedge CLK, posedge I2, 299:330:372, 0:0:0);
	// https://github.com/YosysHQ/icestorm/blob/95949315364f8d9b0c693386aefadf44b28e2cf6/icefuzz/timings_hx1k.txt#L70
	$setuphold(posedge CLK, negedge I2, 259:287:323, 0:0:0);
	$setuphold(negedge CLK, posedge I2, 299:330:372, 0:0:0);
	$setuphold(negedge CLK, negedge I2, 259:287:323, 0:0:0);
	// https://github.com/YosysHQ/icestorm/blob/95949315364f8d9b0c693386aefadf44b28e2cf6/icefuzz/timings_hx1k.txt#L77
	$setuphold(posedge CLK, posedge I3, 220:243:274, 0:0:0);
	// https://github.com/YosysHQ/icestorm/blob/95949315364f8d9b0c693386aefadf44b28e2cf6/icefuzz/timings_hx1k.txt#L71
	$setuphold(posedge CLK, negedge I3, 175:183:217, 0:0:0);
	$setuphold(negedge CLK, posedge I3, 220:243:274, 0:0:0);
	$setuphold(negedge CLK, negedge I3, 175:183:217, 0:0:0);
	// https://github.com/YosysHQ/icestorm/blob/95949315364f8d9b0c693386aefadf44b28e2cf6/icefuzz/timings_hx1k.txt#L73
	$setuphold(posedge CLK, negedge CEN, 0:0:0, 0:0:0);
	// https://github.com/YosysHQ/icestorm/blob/95949315364f8d9b0c693386aefadf44b28e2cf6/icefuzz/timings_hx1k.txt#L67
	$setuphold(posedge CLK, posedge CEN, 0:0:0, 0:0:0);
	// https://github.com/YosysHQ/icestorm/blob/95949315364f8d9b0c693386aefadf44b28e2cf6/icefuzz/timings_hx1k.txt#L78
	$setuphold(posedge CLK, posedge SR, 163:181:203, 0:0:0);
	// https://github.com/YosysHQ/icestorm/blob/95949315364f8d9b0c693386aefadf44b28e2cf6/icefuzz/timings_hx1k.txt#L72
	$setuphold(posedge CLK, negedge SR, 113:125:140, 0:0:0);
	$setuphold(negedge CLK, posedge SR, 163:181:203, 0:0:0);
	$setuphold(negedge CLK, negedge SR, 113:125:140, 0:0:0);
endspecify
`endif
`ifdef ICE40_LP
specify
	// https://github.com/YosysHQ/icestorm/blob/95949315364f8d9b0c693386aefadf44b28e2cf6/icefuzz/timings_lp1k.txt#L79
	(CIN => COUT) = (118:153:186, 98:128:155);
	// https://github.com/YosysHQ/icestorm/blob/95949315364f8d9b0c693386aefadf44b28e2cf6/icefuzz/timings_lp1k.txt#L80
	(I0 => O) = (419:545:662, 360:468:569);
	// https://github.com/YosysHQ/icestorm/blob/95949315364f8d9b0c693386aefadf44b28e2cf6/icefuzz/timings_lp1k.txt#L81
	(I0 => LO) = (340:442:538, 360:468:569);
	// https://github.com/YosysHQ/icestorm/blob/95949315364f8d9b0c693386aefadf44b28e2cf6/icefuzz/timings_lp1k.txt#L82
	(I1 => COUT) = (242:315:382, 229:298:362);
	// https://github.com/YosysHQ/icestorm/blob/95949315364f8d9b0c693386aefadf44b28e2cf6/icefuzz/timings_lp1k.txt#L83
	(I1 => O) = (372:485:589, 353:459:558);
	// https://github.com/YosysHQ/icestorm/blob/95949315364f8d9b0c693386aefadf44b28e2cf6/icefuzz/timings_lp1k.txt#L84
	(I1 => LO) = (301:391:475, 353:459:558);
	// https://github.com/YosysHQ/icestorm/blob/95949315364f8d9b0c693386aefadf44b28e2cf6/icefuzz/timings_lp1k.txt#L85
	(I2 => COUT) = (216:281:341, 124:162:196);
	// https://github.com/YosysHQ/icestorm/blob/95949315364f8d9b0c693386aefadf44b28e2cf6/icefuzz/timings_lp1k.txt#L86
	(I2 => O) = (353:459:558, 327:425:517);
	// https://github.com/YosysHQ/icestorm/blob/95949315364f8d9b0c693386aefadf44b28e2cf6/icefuzz/timings_lp1k.txt#L87
	(I2 => LO) = (288:374:455, 321:417:507);
	// https://github.com/YosysHQ/icestorm/blob/95949315364f8d9b0c693386aefadf44b28e2cf6/icefuzz/timings_lp1k.txt#L88
	(I3 => O) = (294:383:465, 268:349:424);
	// https://github.com/YosysHQ/icestorm/blob/95949315364f8d9b0c693386aefadf44b28e2cf6/icefuzz/timings_lp1k.txt#L89
	(I3 => LO) = (249:323:393, 255:332:403);
	// https://github.com/YosysHQ/icestorm/blob/95949315364f8d9b0c693386aefadf44b28e2cf6/icefuzz/timings_lp1k.txt#L90
	(posedge CLK => (O : 1'bx)) = (504:655:796, 504:655:796);
	// https://github.com/YosysHQ/icestorm/blob/95949315364f8d9b0c693386aefadf44b28e2cf6/icefuzz/timings_lp1k.txt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
	(SR => O) = (559:726:883, 559:726:883);
	// https://github.com/YosysHQ/icestorm/blob/95949315364f8d9b0c693386aefadf44b28e2cf6/icefuzz/timings_lp1k.txt#L74
	$setuphold(posedge CLK, posedge I0, 438:570:693, 0:0:0);
	// https://github.com/YosysHQ/icestorm/blob/95949315364f8d9b0c693386aefadf44b28e2cf6/icefuzz/timings_lp1k.txt#L68
	$setuphold(posedge CLK, negedge I0, 373:485:589, 0:0:0);
	$setuphold(negedge CLK, posedge I0, 438:570:693, 0:0:0);
	$setuphold(negedge CLK, negedge I0, 373:485:589, 0:0:0);
	// https://github.com/YosysHQ/icestorm/blob/95949315364f8d9b0c693386aefadf44b28e2cf6/icefuzz/timings_lp1k.txt#L75
	$setuphold(posedge CLK, posedge I1, 373:485:589, 0:0:0);
	// https://github.com/YosysHQ/icestorm/blob/95949315364f8d9b0c693386aefadf44b28e2cf6/icefuzz/timings_lp1k.txt#L69
	$setuphold(posedge CLK, negedge I1, 353:459:558, 0:0:0);
	$setuphold(negedge CLK, posedge I1, 373:485:589, 0:0:0);
	$setuphold(negedge CLK, negedge I1, 353:459:558, 0:0:0);
	// https://github.com/YosysHQ/icestorm/blob/95949315364f8d9b0c693386aefadf44b28e2cf6/icefuzz/timings_lp1k.txt#L76
	$setuphold(posedge CLK, posedge I2, 347:451:548, 0:0:0);
	// https://github.com/YosysHQ/icestorm/blob/95949315364f8d9b0c693386aefadf44b28e2cf6/icefuzz/timings_lp1k.txt#L70
	$setuphold(posedge CLK, negedge I2, 301:391:475, 0:0:0);
	$setuphold(negedge CLK, posedge I2, 347:451:548, 0:0:0);
	$setuphold(negedge CLK, negedge I2, 301:391:475, 0:0:0);
	// https://github.com/YosysHQ/icestorm/blob/95949315364f8d9b0c693386aefadf44b28e2cf6/icefuzz/timings_lp1k.txt#L77
	$setuphold(posedge CLK, posedge I3, 255:332:403, 0:0:0);
	// https://github.com/YosysHQ/icestorm/blob/95949315364f8d9b0c693386aefadf44b28e2cf6/icefuzz/timings_lp1k.txt#L71
	$setuphold(posedge CLK, negedge I3, 203:264:320, 0:0:0);
	$setuphold(negedge CLK, posedge I3, 255:332:403, 0:0:0);
	$setuphold(negedge CLK, negedge I3, 203:264:320, 0:0:0);
	// https://github.com/YosysHQ/icestorm/blob/95949315364f8d9b0c693386aefadf44b28e2cf6/icefuzz/timings_lp1k.txt#L73
	$setuphold(posedge CLK, negedge CEN, 0:0:0, 0:0:0);
	// https://github.com/YosysHQ/icestorm/blob/95949315364f8d9b0c693386aefadf44b28e2cf6/icefuzz/timings_lp1k.txt#L67
	$setuphold(posedge CLK, posedge CEN, 0:0:0, 0:0:0);
	// https://github.com/YosysHQ/icestorm/blob/95949315364f8d9b0c693386aefadf44b28e2cf6/icefuzz/timings_lp1k.txt#L78
	$setuphold(posedge CLK, posedge SR, 190:247:300, 0:0:0);
	// https://github.com/YosysHQ/icestorm/blob/95949315364f8d9b0c693386aefadf44b28e2cf6/icefuzz/timings_lp1k.txt#L72
	$setuphold(posedge CLK, negedge SR, 131:170:207, 0:0:0);
	$setuphold(negedge CLK, posedge SR, 190:247:300, 0:0:0);
	$setuphold(negedge CLK, negedge SR, 131:170:207, 0:0:0);
endspecify
`endif
`ifdef ICE40_U
specify
	// https://github.com/YosysHQ/icestorm/blob/95949315364f8d9b0c693386aefadf44b28e2cf6/icefuzz/timings_up5k.txt#L91
	(CIN => COUT) = (103:181:278, 103:181:278);
	// https://github.com/YosysHQ/icestorm/blob/95949315364f8d9b0c693386aefadf44b28e2cf6/icefuzz/timings_up5k.txt#L92
	(I0 => O) = (462:808:1255, 477:834:1285);
	// https://github.com/YosysHQ/icestorm/blob/95949315364f8d9b0c693386aefadf44b28e2cf6/icefuzz/timings_up5k.txt#L93
	(I0 => LO) = (315:550:848, 334:585:901);
	// https://github.com/YosysHQ/icestorm/blob/95949315364f8d9b0c693386aefadf44b28e2cf6/icefuzz/timings_up5k.txt#L94
	(I1 => COUT) = (251:438:675, 246:430:662);
	// https://github.com/YosysHQ/icestorm/blob/95949315364f8d9b0c693386aefadf44b28e2cf6/icefuzz/timings_up5k.txt#L95
	(I1 => O) = (438:765:1179, 457:799:1232);
	// https://github.com/YosysHQ/icestorm/blob/95949315364f8d9b0c693386aefadf44b28e2cf6/icefuzz/timings_up5k.txt#L96
	(I1 => LO) = (275:481:742, 329:576:887);
	// https://github.com/YosysHQ/icestorm/blob/95949315364f8d9b0c693386aefadf44b28e2cf6/icefuzz/timings_up5k.txt#L97
	(I2 => COUT) = (226:395:609, 133:232:358);
	// https://github.com/YosysHQ/icestorm/blob/95949315364f8d9b0c693386aefadf44b28e2cf6/icefuzz/timings_up5k.txt#L98
	(I2 => O) = (438:765:1179, 447:782:1205);
	// https://github.com/YosysHQ/icestorm/blob/95949315364f8d9b0c693386aefadf44b28e2cf6/icefuzz/timings_up5k.txt#L99
	(I2 => LO) = (261:456:702, 290:507:781);
	// https://github.com/YosysHQ/icestorm/blob/95949315364f8d9b0c693386aefadf44b28e2cf6/icefuzz/timings_up5k.txt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
	(I3 => O) = (320:559:861, 226:370:874);
	// https://github.com/YosysHQ/icestorm/blob/95949315364f8d9b0c693386aefadf44b28e2cf6/icefuzz/timings_up5k.txt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
	(I3 => LO) = (216:378:583, 226:395:609);
	// https://github.com/YosysHQ/icestorm/blob/95949315364f8d9b0c693386aefadf44b28e2cf6/icefuzz/timings_up5k.txt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
	(posedge CLK => (O : 1'bx)) = (516:903:1391, 516:903:1391);
	// https://github.com/YosysHQ/icestorm/blob/95949315364f8d9b0c693386aefadf44b28e2cf6/icefuzz/timings_up5k.txt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
	(SR => O) = (420:734:1131, 590:1032:1589);
	// https://github.com/YosysHQ/icestorm/blob/95949315364f8d9b0c693386aefadf44b28e2cf6/icefuzz/timings_up5k.txt#L86
	$setuphold(posedge CLK, posedge I0, 457:799:1232, 0:0:0);
	// https://github.com/YosysHQ/icestorm/blob/95949315364f8d9b0c693386aefadf44b28e2cf6/icefuzz/timings_up5k.txt#L80
	$setuphold(posedge CLK, negedge I0, 393:688:1060, 0:0:0);
	$setuphold(negedge CLK, posedge I0, 457:799:1232, 0:0:0);
	$setuphold(negedge CLK, negedge I0, 393:688:1060, 0:0:0);
	// https://github.com/YosysHQ/icestorm/blob/95949315364f8d9b0c693386aefadf44b28e2cf6/icefuzz/timings_up5k.txt#L87
	$setuphold(posedge CLK, posedge I1, 393:688:1060, 0:0:0);
	// https://github.com/YosysHQ/icestorm/blob/95949315364f8d9b0c693386aefadf44b28e2cf6/icefuzz/timings_up5k.txt#L81
	$setuphold(posedge CLK, negedge I1, 373:653:1007, 0:0:0);
	$setuphold(negedge CLK, posedge I1, 393:688:1060, 0:0:0);
	$setuphold(negedge CLK, negedge I1, 373:653:1007, 0:0:0);
	// https://github.com/YosysHQ/icestorm/blob/95949315364f8d9b0c693386aefadf44b28e2cf6/icefuzz/timings_up5k.txt#L88
	$setuphold(posedge CLK, posedge I2, 364:636:980, 0:0:0);
	// https://github.com/YosysHQ/icestorm/blob/95949315364f8d9b0c693386aefadf44b28e2cf6/icefuzz/timings_up5k.txt#L82
	$setuphold(posedge CLK, negedge I2, 320:559:861, 0:0:0);
	$setuphold(negedge CLK, posedge I2, 364:636:980, 0:0:0);
	$setuphold(negedge CLK, negedge I2, 320:559:861, 0:0:0);
	// https://github.com/YosysHQ/icestorm/blob/95949315364f8d9b0c693386aefadf44b28e2cf6/icefuzz/timings_up5k.txt#L89
	$setuphold(posedge CLK, posedge I3, 279:473:728, 0:0:0);
	// https://github.com/YosysHQ/icestorm/blob/95949315364f8d9b0c693386aefadf44b28e2cf6/icefuzz/timings_up5k.txt#L83
	$setuphold(posedge CLK, negedge I3, 216:378:583, 0:0:0);
	$setuphold(negedge CLK, posedge I3, 279:473:728, 0:0:0);
	$setuphold(negedge CLK, negedge I3, 216:378:583, 0:0:0);
	// https://github.com/YosysHQ/icestorm/blob/95949315364f8d9b0c693386aefadf44b28e2cf6/icefuzz/timings_up5k.txt#L85
	$setuphold(posedge CLK, negedge CEN, 0:0:0, 0:0:0);
	// https://github.com/YosysHQ/icestorm/blob/95949315364f8d9b0c693386aefadf44b28e2cf6/icefuzz/timings_up5k.txt#L79
	$setuphold(posedge CLK, posedge CEN, 0:0:0, 0:0:0);
	// https://github.com/YosysHQ/icestorm/blob/95949315364f8d9b0c693386aefadf44b28e2cf6/icefuzz/timings_up5k.txt#L90
	$setuphold(posedge CLK, posedge SR, 197:344:530, 0:0:0);
	// https://github.com/YosysHQ/icestorm/blob/95949315364f8d9b0c693386aefadf44b28e2cf6/icefuzz/timings_up5k.txt#L84
	$setuphold(posedge CLK, negedge SR, 143:249:384, 0:0:0);
	$setuphold(negedge CLK, posedge SR, 197:344:530, 0:0:0);
	$setuphold(negedge CLK, negedge SR, 131:170:207, 0:0:0);
endspecify
`endif
endmodule

// SiliconBlue PLL Cells

(* blackbox *)
module SB_PLL40_CORE (
	input   REFERENCECLK,
	output  PLLOUTCORE,
	output  PLLOUTGLOBAL,
	input   EXTFEEDBACK,
	input   [7:0] DYNAMICDELAY,
	output  LOCK,
	input   BYPASS,
	input   RESETB,
	input   LATCHINPUTVALUE,
	output  SDO,
	input   SDI,
	input   SCLK
);
	parameter FEEDBACK_PATH = "SIMPLE";
	parameter DELAY_ADJUSTMENT_MODE_FEEDBACK = "FIXED";
	parameter DELAY_ADJUSTMENT_MODE_RELATIVE = "FIXED";
	parameter SHIFTREG_DIV_MODE = 1'b0;
	parameter FDA_FEEDBACK = 4'b0000;
	parameter FDA_RELATIVE = 4'b0000;
	parameter PLLOUT_SELECT = "GENCLK";
	parameter DIVR = 4'b0000;
	parameter DIVF = 7'b0000000;
	parameter DIVQ = 3'b000;
	parameter FILTER_RANGE = 3'b000;
	parameter ENABLE_ICEGATE = 1'b0;
	parameter TEST_MODE = 1'b0;
	parameter EXTERNAL_DIVIDE_FACTOR = 1;
endmodule

(* blackbox *)
module SB_PLL40_PAD (
	input   PACKAGEPIN,
	output  PLLOUTCORE,
	output  PLLOUTGLOBAL,
	input   EXTFEEDBACK,
	input   [7:0] DYNAMICDELAY,
	output  LOCK,
	input   BYPASS,
	input   RESETB,
	input   LATCHINPUTVALUE,
	output  SDO,
	input   SDI,
	input   SCLK
);
	parameter FEEDBACK_PATH = "SIMPLE";
	parameter DELAY_ADJUSTMENT_MODE_FEEDBACK = "FIXED";
	parameter DELAY_ADJUSTMENT_MODE_RELATIVE = "FIXED";
	parameter SHIFTREG_DIV_MODE = 1'b0;
	parameter FDA_FEEDBACK = 4'b0000;
	parameter FDA_RELATIVE = 4'b0000;
	parameter PLLOUT_SELECT = "GENCLK";
	parameter DIVR = 4'b0000;
	parameter DIVF = 7'b0000000;
	parameter DIVQ = 3'b000;
	parameter FILTER_RANGE = 3'b000;
	parameter ENABLE_ICEGATE = 1'b0;
	parameter TEST_MODE = 1'b0;
	parameter EXTERNAL_DIVIDE_FACTOR = 1;
endmodule

(* blackbox *)
module SB_PLL40_2_PAD (
	input   PACKAGEPIN,
	output  PLLOUTCOREA,
	output  PLLOUTGLOBALA,
	output  PLLOUTCOREB,
	output  PLLOUTGLOBALB,
	input   EXTFEEDBACK,
	input   [7:0] DYNAMICDELAY,
	output  LOCK,
	input   BYPASS,
	input   RESETB,
	input   LATCHINPUTVALUE,
	output  SDO,
	input   SDI,
	input   SCLK
);
	parameter FEEDBACK_PATH = "SIMPLE";
	parameter DELAY_ADJUSTMENT_MODE_FEEDBACK = "FIXED";
	parameter DELAY_ADJUSTMENT_MODE_RELATIVE = "FIXED";
	parameter SHIFTREG_DIV_MODE = 1'b0;
	parameter FDA_FEEDBACK = 4'b0000;
	parameter FDA_RELATIVE = 4'b0000;
	parameter PLLOUT_SELECT_PORTB = "GENCLK";
	parameter DIVR = 4'b0000;
	parameter DIVF = 7'b0000000;
	parameter DIVQ = 3'b000;
	parameter FILTER_RANGE = 3'b000;
	parameter ENABLE_ICEGATE_PORTA = 1'b0;
	parameter ENABLE_ICEGATE_PORTB = 1'b0;
	parameter TEST_MODE = 1'b0;
	parameter EXTERNAL_DIVIDE_FACTOR = 1;
endmodule
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
