alanmimms/WSPR-ease/(commit log)

2026-04-16 Use relays and do layout over again to make these damned things fit
    [LPFs.kicad_sch, WSPR-ease.kicad_pcb, WSPR-ease.kicad_sch, tx.kicad_sch]
2026-04-16 Timing now closes at 121MHz. But output still does not produce any signal on my scope. Shit.
    [LPFs.kicad_sch, WSPR-ease.kicad_pcb]
2026-04-16 Update documentation to match where we are now with FPGA
    [iCE40UltraUltraPlusSG48PinMigration.ods]
2026-04-17 Use VFPGAIO for pullup for driverNEN. Fix some layout issues with more equal routing lengths in critical tx phase paths.
    [LPFs.kicad_sch, WSPR-ease.kicad_pcb, WSPR-ease.kicad_sch, phase-driver.kicad_sch, tx.kicad_sch]
2026-04-18 Remove power setting API
2026-04-20 Checkpoint before switching AI strategies
2026-05-08 Checkpoint before revamping testbench - now broken for SPI
    [build.py, fpga.cpp, gateware.py, regs.py, timing.py]
2026-05-08 Checkpoint after rewrite in amaranth. Still not generating wave output nor is SPI working, but it is progress
2026-05-10 FPGA: Implement zero-fabric-carry DSP NCO and achieve 94MHz timing closure
    - Refactored 48-bit PipelinedNCO to use 3 pipelined SB_MAC16 DSP blocks,
    eliminating all fabric carry-chain bottlenecks.
    - Migrated FrequencyCounter to the 8th DSP block for 32-bit precision at speed.
    - Overhauled SPIRegisters with one-hot address decoding and registered data
    fetching to resolve massive cross-chip routing delays.
    - Resolved posedge-to-negedge half-cycle IO timing violations by registering
    control signals before the DDR output stage.
    - Fixed SB_MAC16 simulation model feedback logic and sanitized generated
    Verilog for GTKWave compatibility.
    - Verified 180 Msps DDR synthesis and SPI loopback in V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
    [gateware.py, tbTop.cpp]
2026-05-10 FPGA: Fix pipeline misalignment in Exciter and update test bench for 1-2-1 modulation
    [gateware.py, tbTop.cpp]
2026-05-13 Eliminate more evil underscores. Still debugging FPGA spurious random pulse problem.
    [build.py, gateware.py, pins.pcf, tbTop.cpp, timing.py]
2026-05-13 Clean up a lot. Switch to common clocking for sim rather than a buncha copypasta everywhere, 90MHz clock
2026-05-14 Add some debug for sim. Fix offs module to do actual 16-bit add with right params.
    [gateware.py]
2026-06-09 Convert to async based sim. Sort 90MHz vs 40MHz clocking and use SB_PLL40_PAD to generate both. Clean up sim vs hw build to create two separate RTL outputs from Amaranth gateware.py. Probably this st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
    [build.py, gateware.py, pins.pcf, regs.py, tbTop.cpp, timing.py]
2026-06-09 Fix RF exciter pin phase alignment, state 6 clamping, and square wave mode pin assignments; timing closed at 100.93MHz
    [gateware.py, tbTop.cpp]
2026-06-09 Keep buildNumber.txt in git so it keeps going up (multiple clones will cause problems!). Starting to figure out why hw DDR IO is generating the wrong signals but still borked.
    [gateware.py]
2026-06-10 Set DDR pin type to no enable no register DDR, unset clock and enable pins. This did not change a thing in the result.
2026-06-10 Align rising/falling edge delays, fix cells_sim.v simulation fidelity, and resolve Makefile dependency caching
    [cells_sim.v, gateware.py]
2026-06-10 Fix 90MHz hardware toggling by replacing DSP adder/multipliers in Exciter with fabric logic
    [gateware.py]
2026-06-10 Fix simulation/hardware DDR mapping discrepancy and align pipeline delays
    [cells_sim.v, gateware.py]
2026-06-10 Closer. I think the LFSR dithering is causing problems now since I reenabled it.
    [gateware.py]
2026-06-13 I think this is now using the SB_MAC16 properly for each instance. The AI based configs were all screwed up. I listed teh name from the iCE40 Tech Lib doc for each flavor used in a comment to help if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
    [WSPR-ease.kicad_pcb, tx.kicad_sch]
2026-06-18 Fix SB_MAC16 in NCO to use UPPER 16-bits of result since A is mapped to the top half.
    [gateware.py]
2026-06-18 Fix FreqCounter SB_MAC16 config (but not yet tested)
    [gateware.py]
2026-06-18 Fixed up macR multiplier - still not 100%, but I think this is "closer"
    [gateware.py]
2026-06-19 Fix routing problem for multiplier resets
    [gateware.py]
2026-06-19 Add original recipe code for cells_sim.v in case we need to revert. Changed the bit shift for the dithering noise to make it less jittery. I think it is generating 9MHz and lower quite well now.
    [gateware.py]
2026-06-19 Add 0MHz "tx stop" equivalent. Fix DOS line endings.
    [fpga.cpp, shellcmds.cpp]
2026-06-20 Fucking USB 16-pin footprint! Also, completely redid the layout and wiring of the transmitter using a MOSFET gate and R+diode gate drive, simplify BOM, enhance LPFs for square wave output >= 10MHz.
    [LPFs.kicad_sch, WSPR-ease.kicad_pcb, WSPR-ease.kicad_sch, phase-driver.kicad_sch, tx.kicad_sch]
2026-06-21 Checkpoint after significant refactoring which BROKE the FPGA
    [gateware.py]
2026-06-22 The square wave and 1-2-1 modulation are properly dithering now. When I move to UCC27524DGN gate driver and 10R+1N4148 diode on the gate drive, I think the shoot-through will mostly disappear. I cann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
2026-06-26 Add symbols for new components, switch to SI5351 in place of FPGA. Simplify!
    [LPFs.kicad_sch, WSPR-ease.kicad_pcb, WSPR-ease.kicad_sch, phase-driver.kicad_sch, tx.kicad_sch]
2026-06-26 Add footprints too
2026-06-26 Switch to SI5351C-B-GM for exciter + AHC to attenuate 3rd harmonic on a separate winding on the binocular transformer. Do so layout tweaks. This is much simpler than the FPGA version.
    [WSPR-ease.kicad_pcb, WSPR-ease.kicad_sch, tx.kicad_sch]
2026-06-27 Horsing around with JLCPCB assembly and BOM. I think it is still too expensive to do it this way for p1 build
    [LPFs.kicad_sch, WSPR-ease.kicad_pcb, WSPR-ease.kicad_sch, tx.kicad_sch]
2026-06-27 OCD fixes. Fix USB2 connector footprint AGAIN (these things are not standardized!).
    [LPFs.kicad_sch, WSPR-ease.kicad_pcb, WSPR-ease.kicad_sch, tx.kicad_sch]
2026-07-02 Now using RP2040 as a DDS. I can use SPI co-host to program its (SPI) flash. I can use I2C between ESP32 and RP2040 to send commands and receive status.
    [LPFs.kicad_sch, WSPR-ease.kicad_pcb, WSPR-ease.kicad_sch, dds.kicad_sch, tx.kicad_sch]
2026-07-06 Switched to SI5351 clocking MACHXO2 CPLD to drive gate driver for MOSFETs. It passes DRC but needs serious reviewing.
    [LPFs.kicad_sch, WSPR-ease.kicad_pcb, WSPR-ease.kicad_sch, exciter.kicad_sch, tx.kicad_sch]
2026-07-07 Various schematic clean ups. Improved/fixed decoupling around relays. Filter Vdd for TCXO and SI5351 to try to minimize modulation of the clock freq by noise
    [LPFs.kicad_sch, WSPR-ease.kicad_pcb, WSPR-ease.kicad_sch, exciter.kicad_sch, tx.kicad_sch]
2026-07-07 Simplify. Put exciter stuff onto transmitter sheet.
    [LPFs.kicad_sch, WSPR-ease.kicad_pcb, WSPR-ease.kicad_sch, exciter.kicad_sch, tx.kicad_sch]
2026-07-08 Add stitched GND zone around edge of PCB on all layers and pretty up the mounting holes with vias as well.
    [WSPR-ease.kicad_pcb, tx.kicad_sch]
2026-07-15 Prep to go back to FPGA. Board is routed except for power layer zones. No time to run DRC yet.
    [WSPR-ease.kicad_pcb, WSPR-ease.kicad_sch, exciter.kicad_sch, tx.kicad_sch]
2026-07-16 Now we pass schematic and PCB DRC and 3D renders nicely also.
    [WSPR-ease.kicad_pcb, WSPR-ease.kicad_sch, exciter.kicad_sch]
2026-07-16 Remove old stuff, describe new FPGA strategy, clean up schematic to show this more cleanly, add I2S I/O for ESP32 to FPGA and mic ADC with common clocking.
    [WSPR-ease.kicad_sch, exciter.kicad_sch]
2026-07-16 Getting closer but not timing at 40MHz clock still. I think I have a fix but I have run out of time. Checkpoint.
    [WSPR-ease.kicad_pcb, exciter.kicad_sch]
2026-07-18 Clean up old garbage files
    [WSPR-ease.kicad_pcb, WSPR-ease.kicad_sch, dds.kicad_sch, exciter.kicad_sch, phase-driver.kicad_sch]
